kaloyanMilev13/GreenHouse/doc/design/design_presentation.odp

## Greenhouse Management Design

The presentation is separated into 4 parts:

1. Overview
2. Wiring and Schematics
3. Modules
4. Firmware

## Overview

Back to first slide

## Slide 3

1.1. System architecture

1. Overview

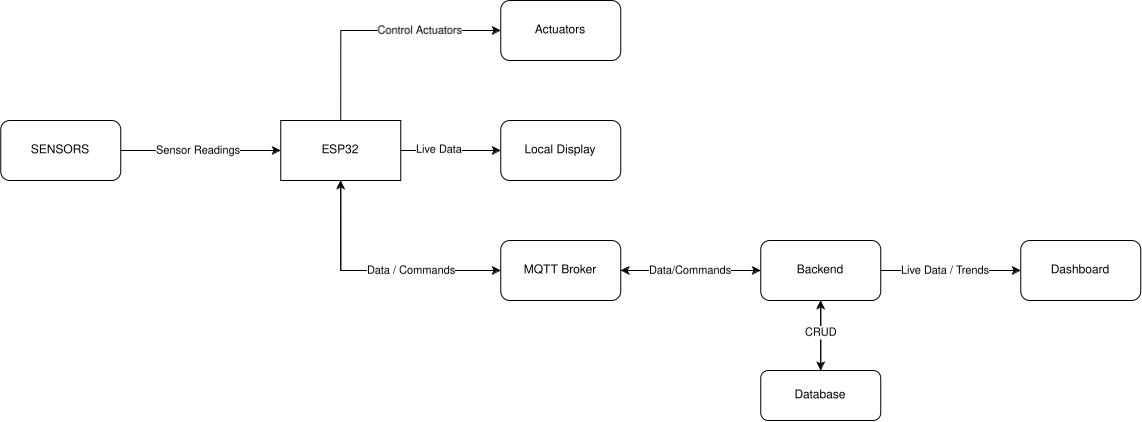
[picture p1: figure]

Back to first slide

## Slide 4

1.1. System architecture - detailed

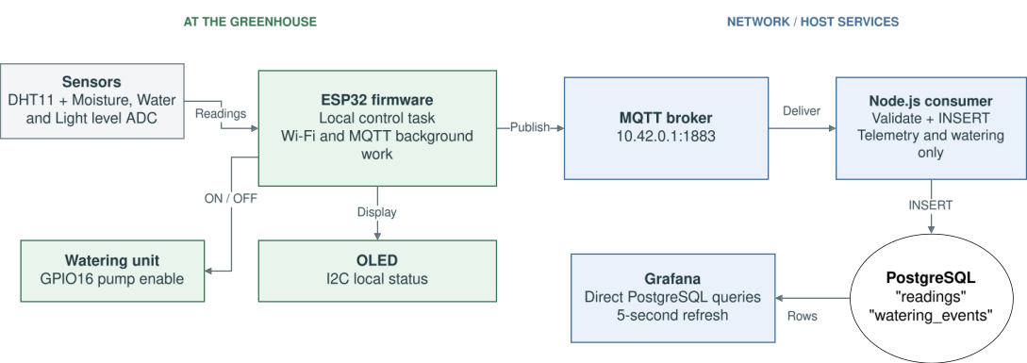
[picture p2: figure]

1. Overview

Back to first slide

## Slide 5

1.2. Firmware responsibilities

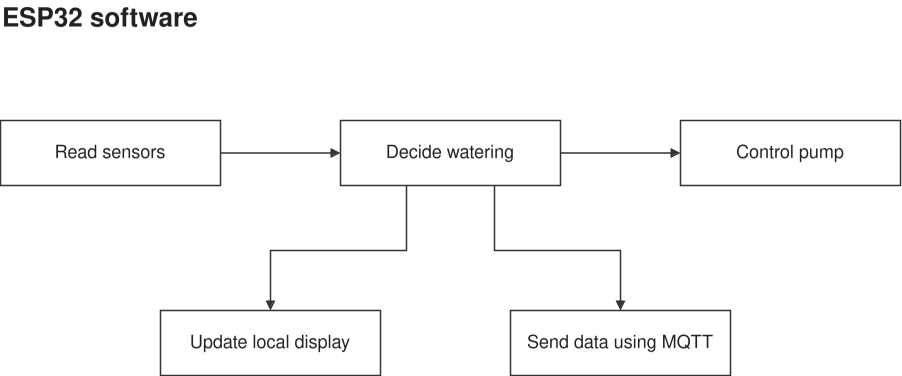
[picture p3: figure]

1. Overview

Back to first slide

## Slide 6

1.3. Whole system – more detailed

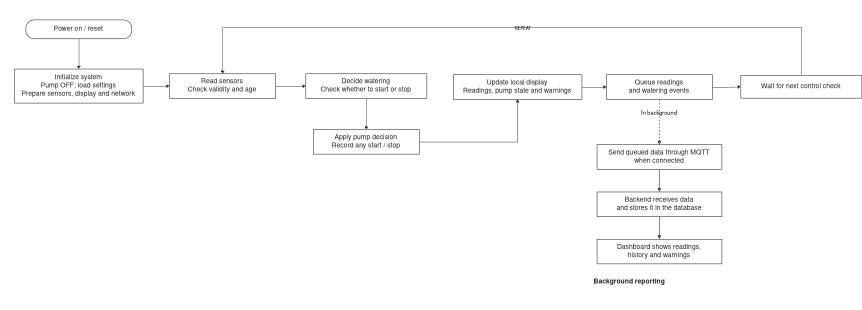
[picture p4: figure]

1. Overview

Back to first slide

## Slide 7

1.4. Initialization / setup part

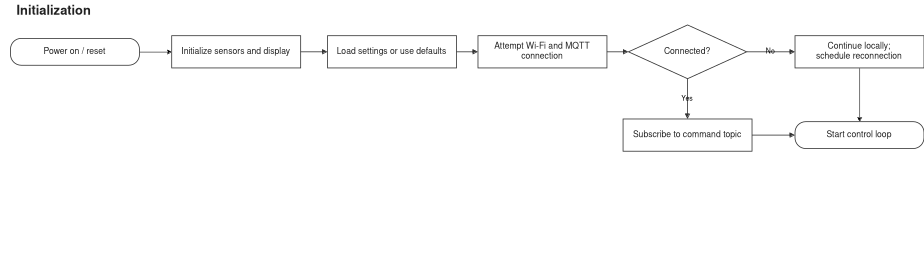
[picture p5: figure]

1. Overview

Back to first slide

## Slide 8

1.5. Control Loop

1. Overview

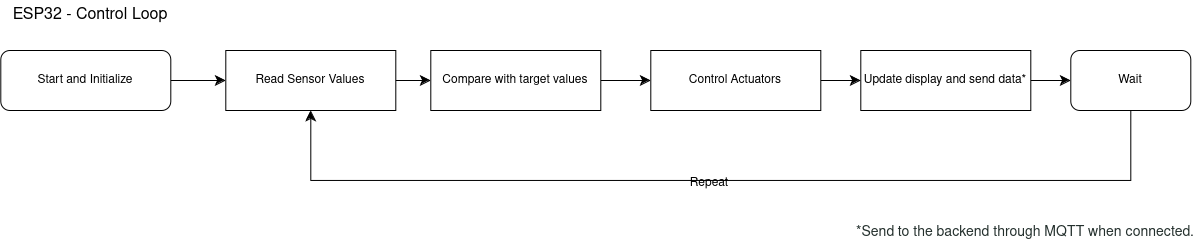
[picture p6: figure]

Back to first slide

## Slide 9

1.6. Communication protocol

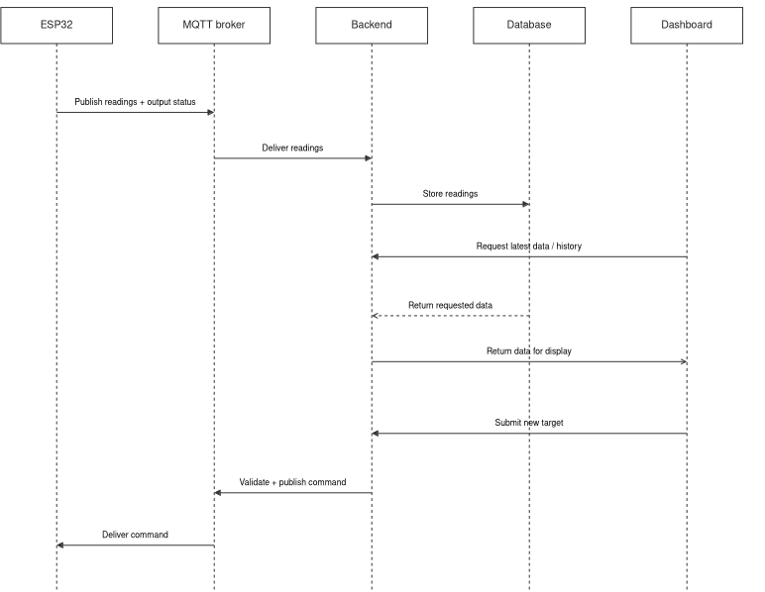
[picture p7: figure]

1. Overview

Back to first slide

## Slide 10

1.7. Sensor Readings

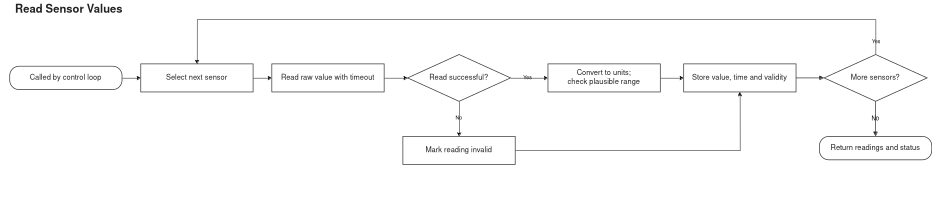
[picture p8: figure]

1. Overview

Back to first slide

## Wiring and Schematics

Back to first slide

## Slide 12

2.1. Wiring table

Component | Component signal | ESP32 GPIO | Interface / behavior
Soil-moisture sensor | Analog output | GPIO33 | ADC1 channel 5
Water-level sensor | Analog output | GPIO35 | ADC1 channel 7
Light sensor | Analog output | GPIO34 | ADC1 channel 6
DHT11 temperature/humidity sensor | DATA | GPIO17 | Digital sensor communication
Pump control | PUMP_EN | GPIO16 | HIGH = ON; LOW = OFF
SSD1306 OLED, 128 × 64 | SDA | GPIO21 | I²C data
SSD1306 OLED, 128 × 64 | SCL | GPIO22 | I²C clock

2. Wiring and Schematics

Back to first slide

## Slide 13

2.2. KiCad Wiring Schematic

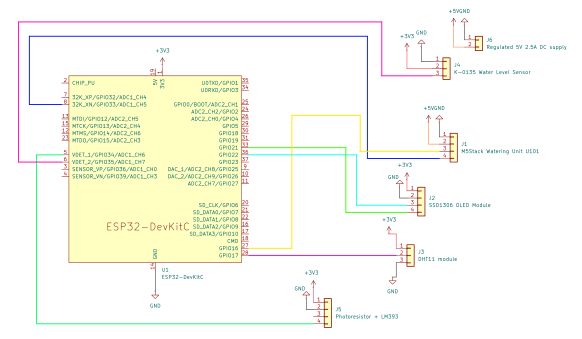
[picture p9: figure]

2. Wiring and Schematics

Back to first slide

## Slide 14

2.2. Power Wiring Table

Component | Power connection | Ground connection
ESP32 DevKitC — U1 | USB through Micro-USB socket | ESP32 GND → common GND
External 5V supply — J6 | J6 pin 2 (+5V) → J1 pin 2 | J6 pin 1 (negative) → common GND
Watering unit: soil sensor + pump — J1 | J1 pin 2 → external +5V | J1 pin 1 → common GND
SSD1306 OLED — J2 | J2 pin 1 → ESP32 3V3 | J2 pin 2 → common GND
DHT11 module — J3 | J3 pin 1 → ESP32 3V3 | J3 pin 3 → common GND
Water-level sensor — J4 | J4 pin 2 → ESP32 3V3 | J4 pin 1 → common GND
Light-sensor module — J5 | J5 pin 1 → ESP32 3V3 | J5 pin 2 → common GND

2. Wiring and Schematics

Back to first slide

## Modules

Back to first slide

## Slide 16

3.1. Source files and responsibilities

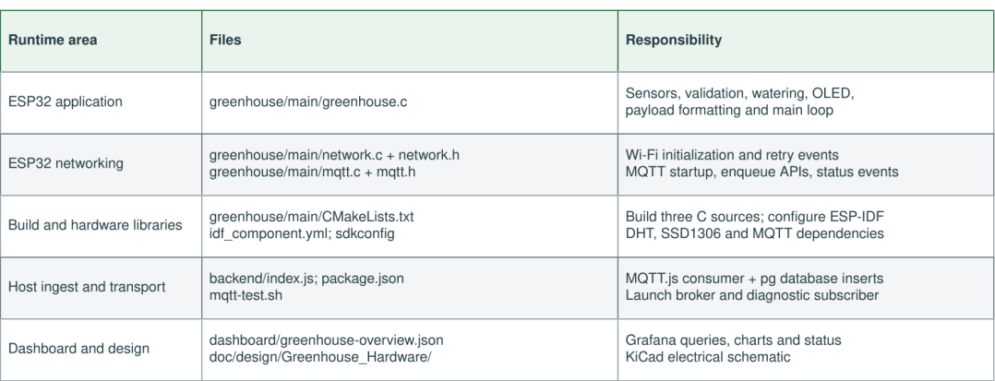
[picture p10: figure]

3. Modules

Back to first slide

## Slide 17

3.2. Connections between modules

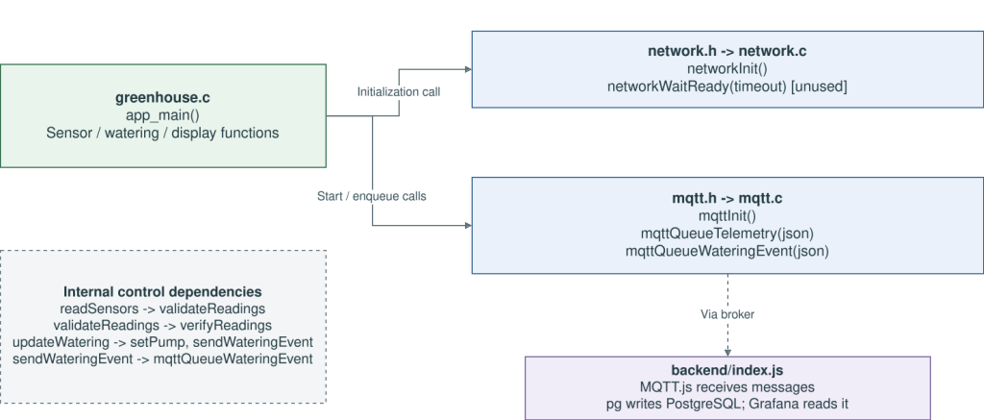
[picture p11: figure]

3. Modules

Back to first slide

## Slide 18

3.3. Data Structures

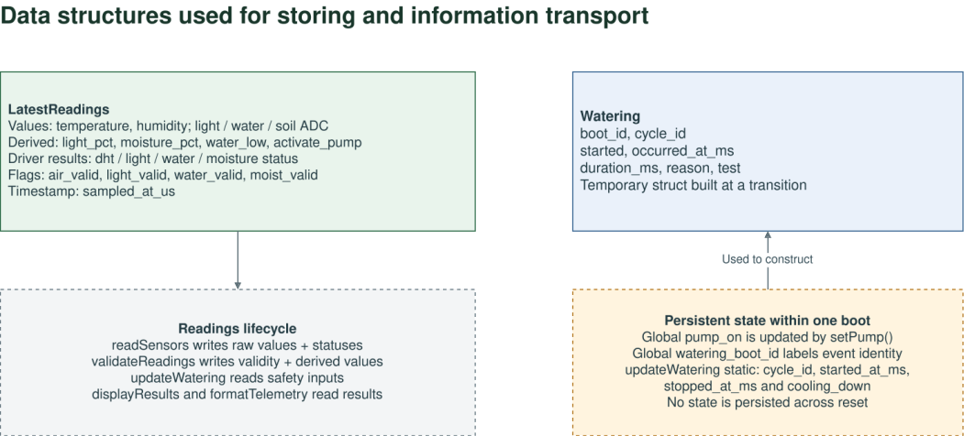
[picture p12: figure]

Back to first slide

3. Modules

## Firmware

Back to first slide

## Slide 20

4.1. Control Loop Logic

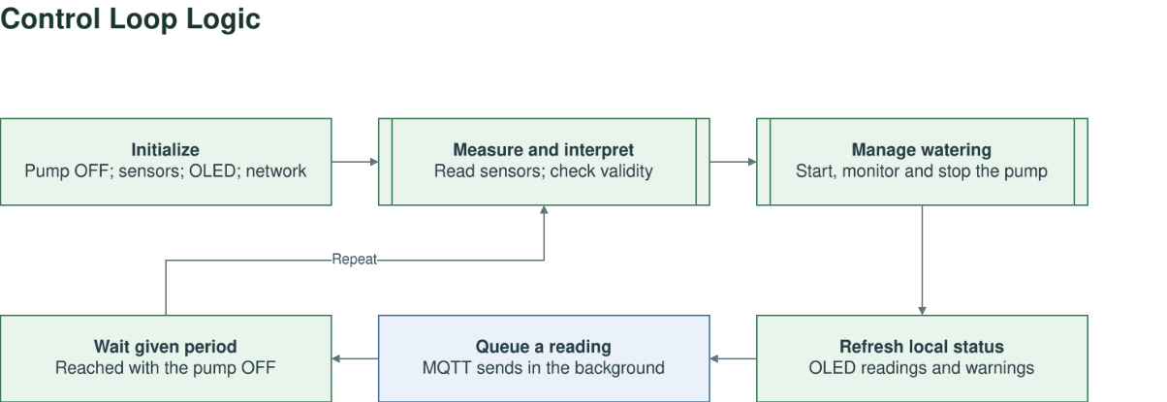
[picture p13: figure]

4. Firmware

Back to first slide

## Slide 21

4.2. Startup Logic

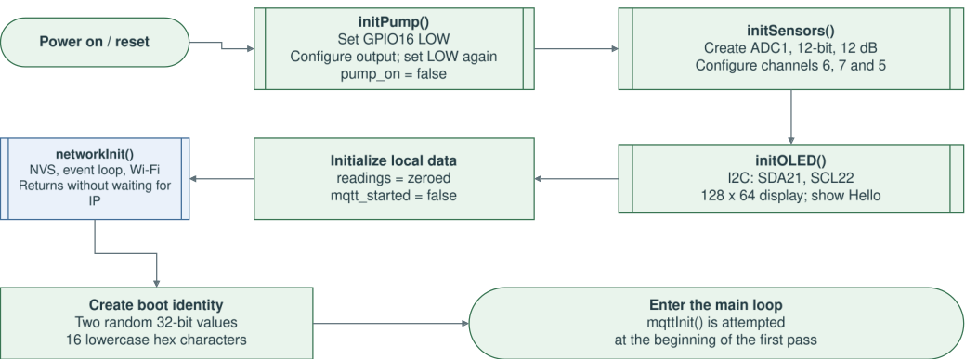
[picture p14: figure]

4. Firmware

Back to first slide

## Slide 22

4.3. Main Loop Logic

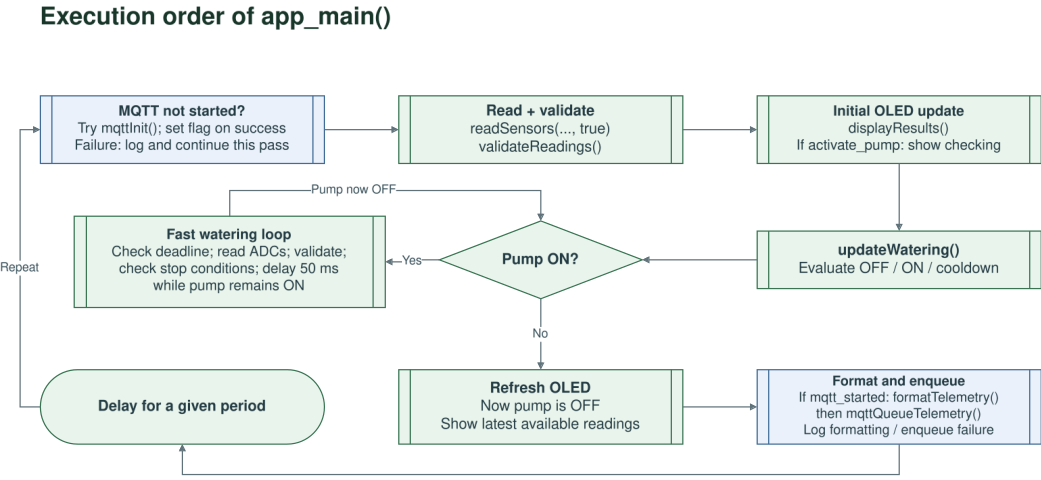
[picture p15: figure]

4. Firmware

Back to first slide

## Slide 23

4.4. Network logic

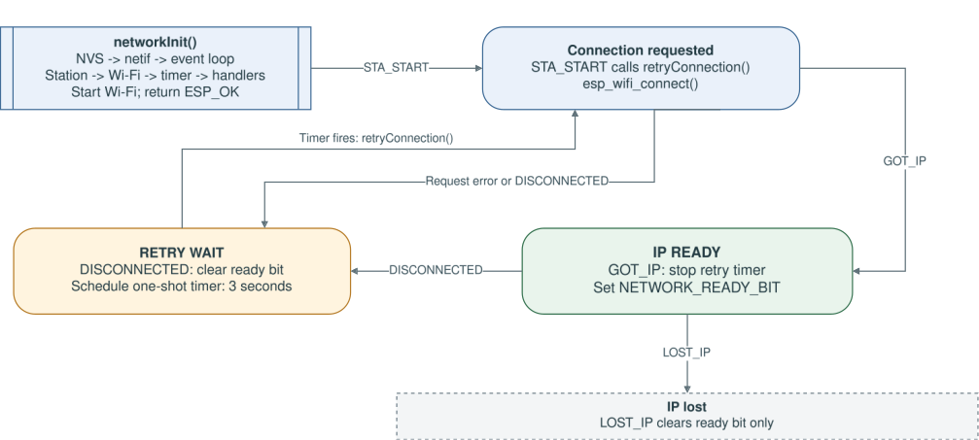
[picture p16: figure]

4. Firmware

Back to first slide

## Slide 24

4.5. MQTT Logic

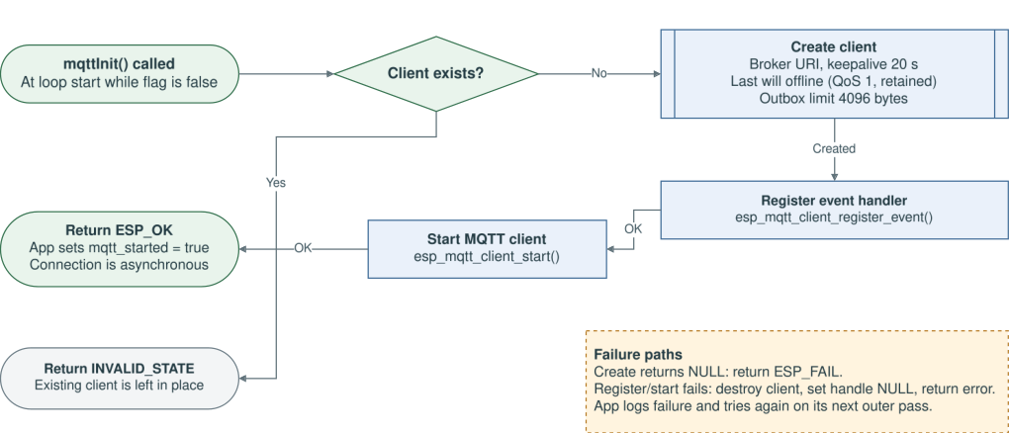
[picture p17: figure]

4. Firmware

Back to first slide

## Slide 25

4.6. Backend Logic

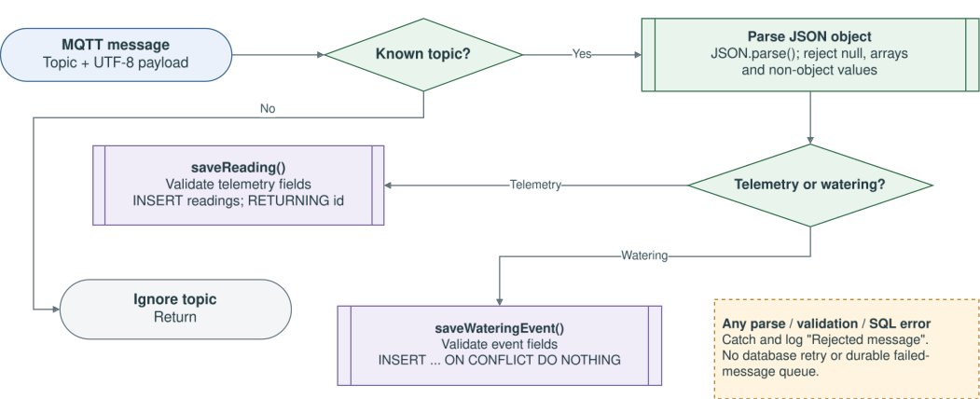
[picture p18: figure]

4. Firmware

Back to first slide

## Slide 26

4.7. Reporting Logic

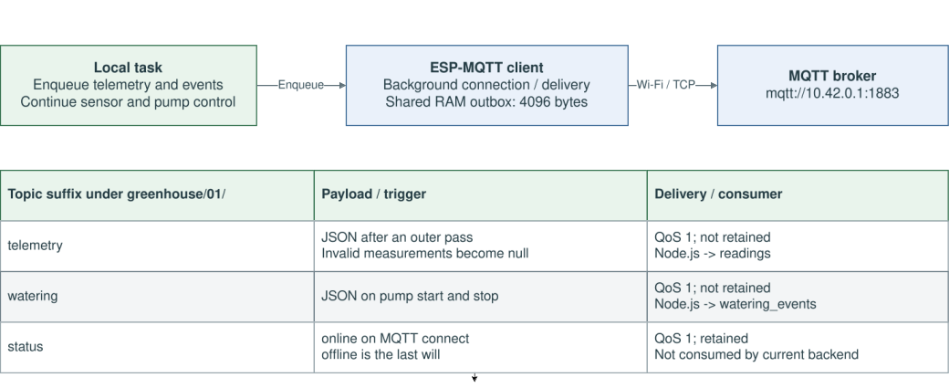
[picture p19: figure]

4. Firmware

Back to first slide
