kaloyanMilev13/GreenHouse/doc/realizaton/realization.pdf

# Demonstration Presentation

1.OLED View
2.Dashboard View
3.Project overview
4.Temperature and Humidity Functionality 5.Light Level Functionality
6.Water Status Functionality 7.Irrigation Example

## 1.1. OLED View

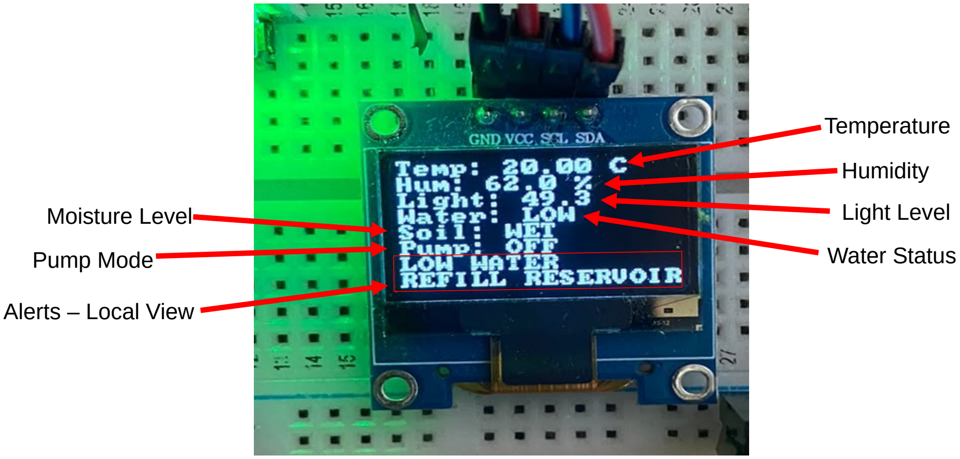
[picture p25: figure]
Temperature; Humidity; Light Level; Water Status; Moisture Level; Pump Mode; Alerts – Local View
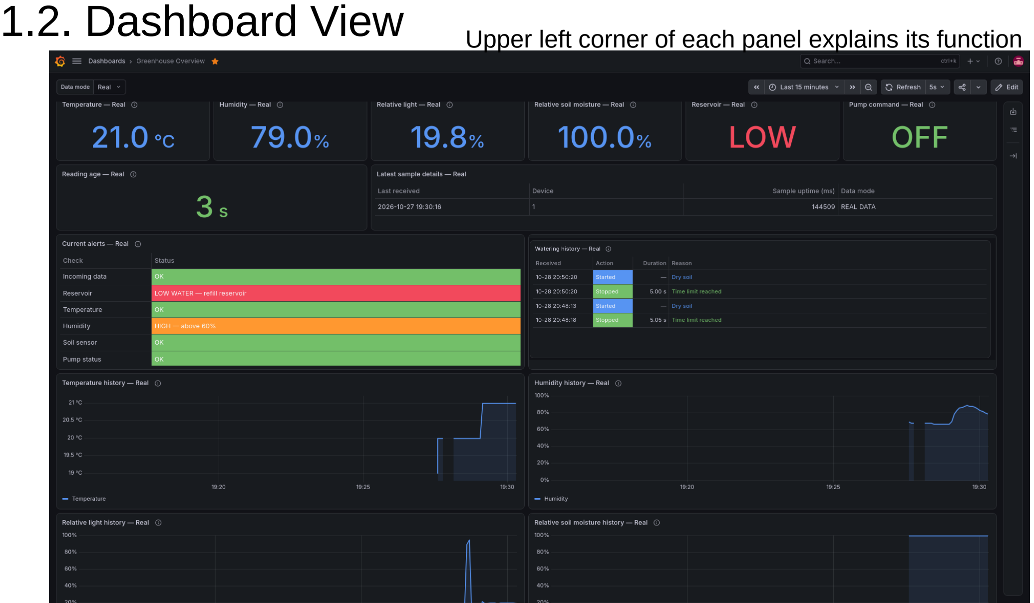
[picture p26: page 3]

1.2. Dashboard View Upper left corner of each panel explains its function

# 2. Overview

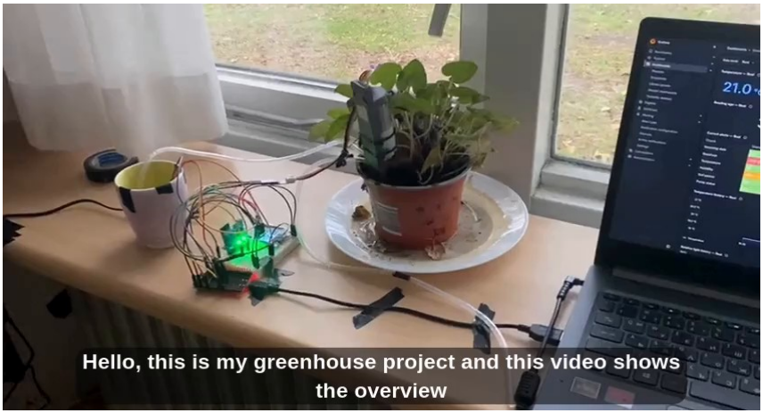
[picture p27: figure]

## 3. Temperature and Humidity functionality

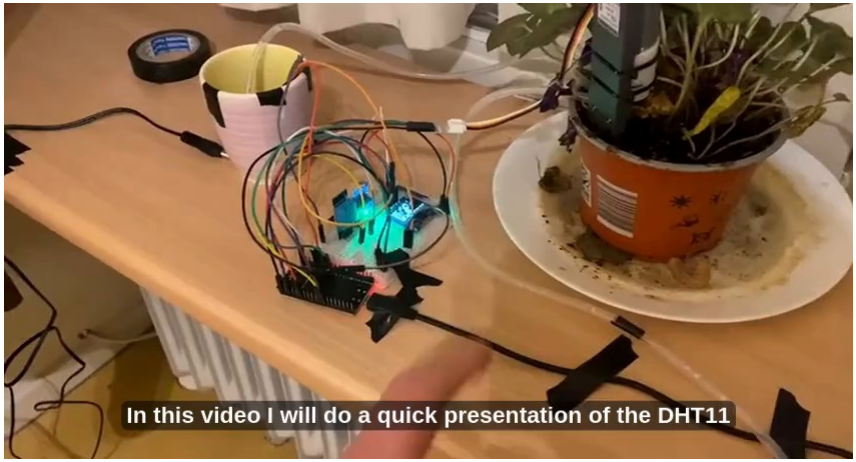
[picture p28: figure]

## 4. Light Level functionality

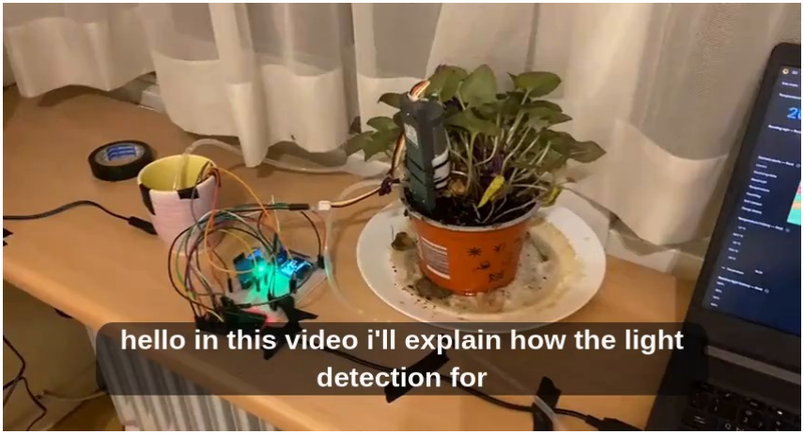
[picture p29: figure]

## 5. Water Status functionality

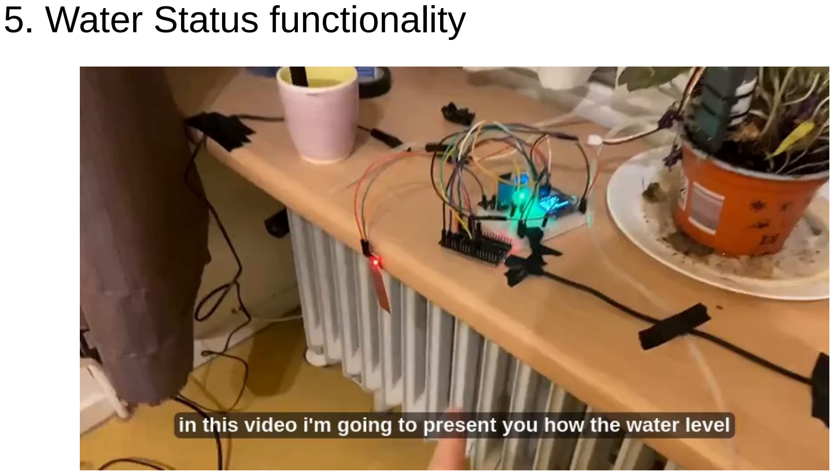
[picture p30: page 7]

## 6. Irrigation Example

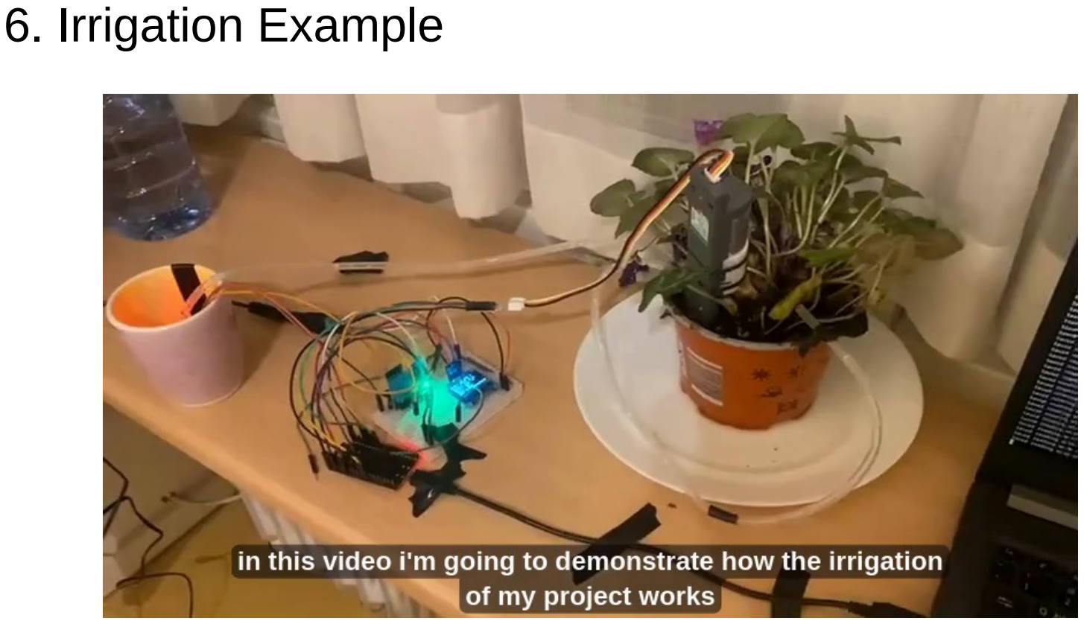
[picture p31: page 8]
