kaloyanMilev13/GreenHouse/doc/planning/Greenhouse_Project_Plan.docx

# Greenhouse Planning and Approach

# 1. Waterfall approach

I will work through five phases, checking components early and updating earlier decisions when a problem requires it.

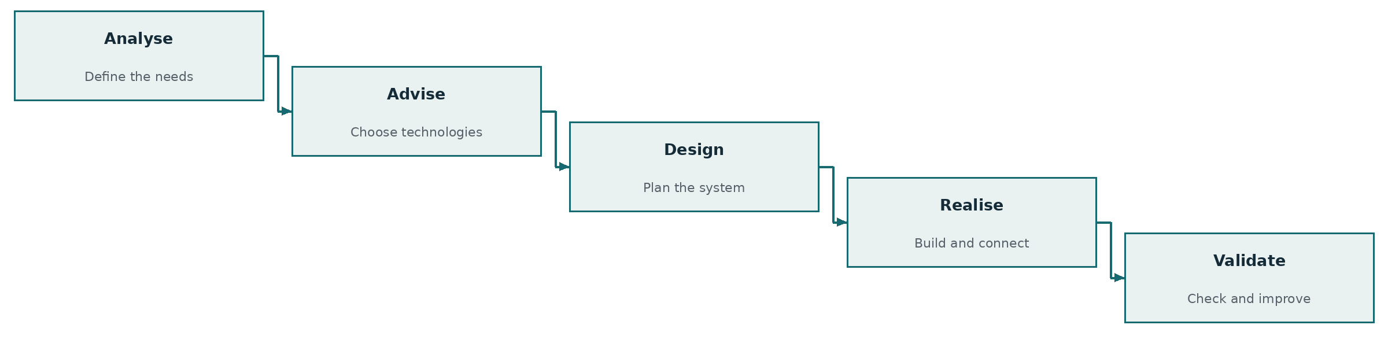
[picture p32: figure]
Five descending phases: Analyse, Advise, Design, Realise, Validate. Each names its main activity.

# 2. Weekly milestones

Week 1 | Week 2 | Week 3 | Week 4
Requirements and technology choices defined. | Design ready and individual components checked. | Local control, storage and dashboard connected. | Final checks complete; fixes retested and work submitted.

# 3. What depends on what

These links show which work must come together before the complete system can be evaluated.

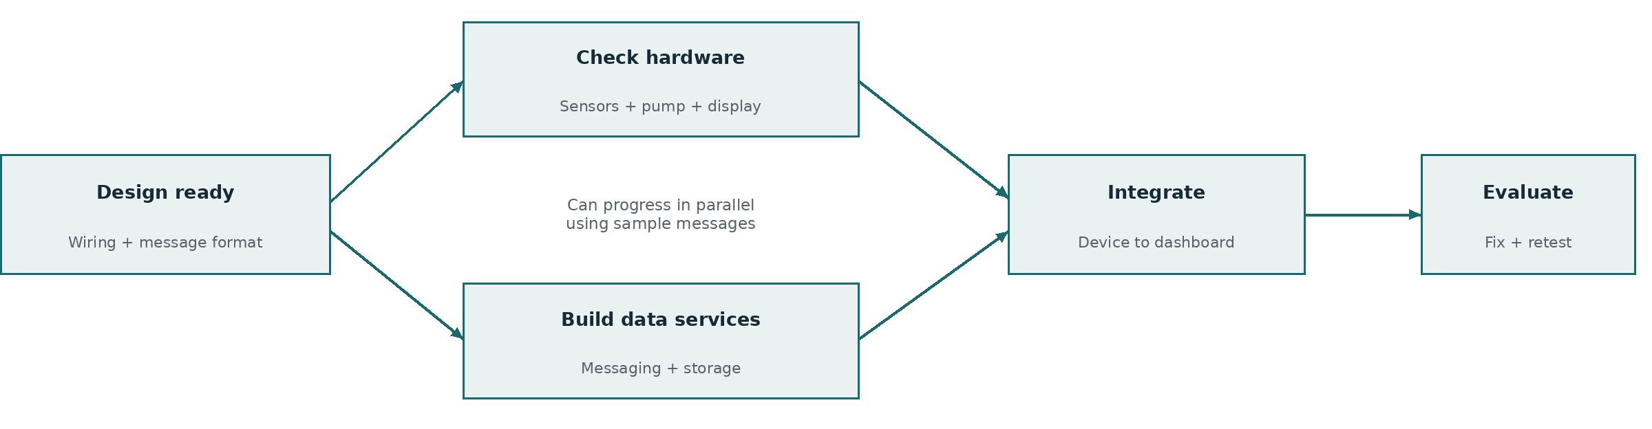
[picture p33: figure]
Design branches into hardware checks and data services, which can progress in parallel using sample messages. Both feed integration, followed by evaluation, fixes and retesting.

If parts are delayed, I can continue the data services with sample readings. Actual hardware integration still needs the real components.

# 4. How I will handle delays

If this happens | My response
A component does not work as expected | Check compatibility early; revise the choice or wiring before integration.
Connecting the software takes longer | Complete one path first: device → stored reading → dashboard. Expand after it works.
There is not enough time for every feature | Postpone “Could Have” requirements first, then “Should Have” if needed.

# 5. Detailed schedule – Gantt Chart

The Gantt chart will show task durations, overlaps, dependencies and milestones across the four weeks.

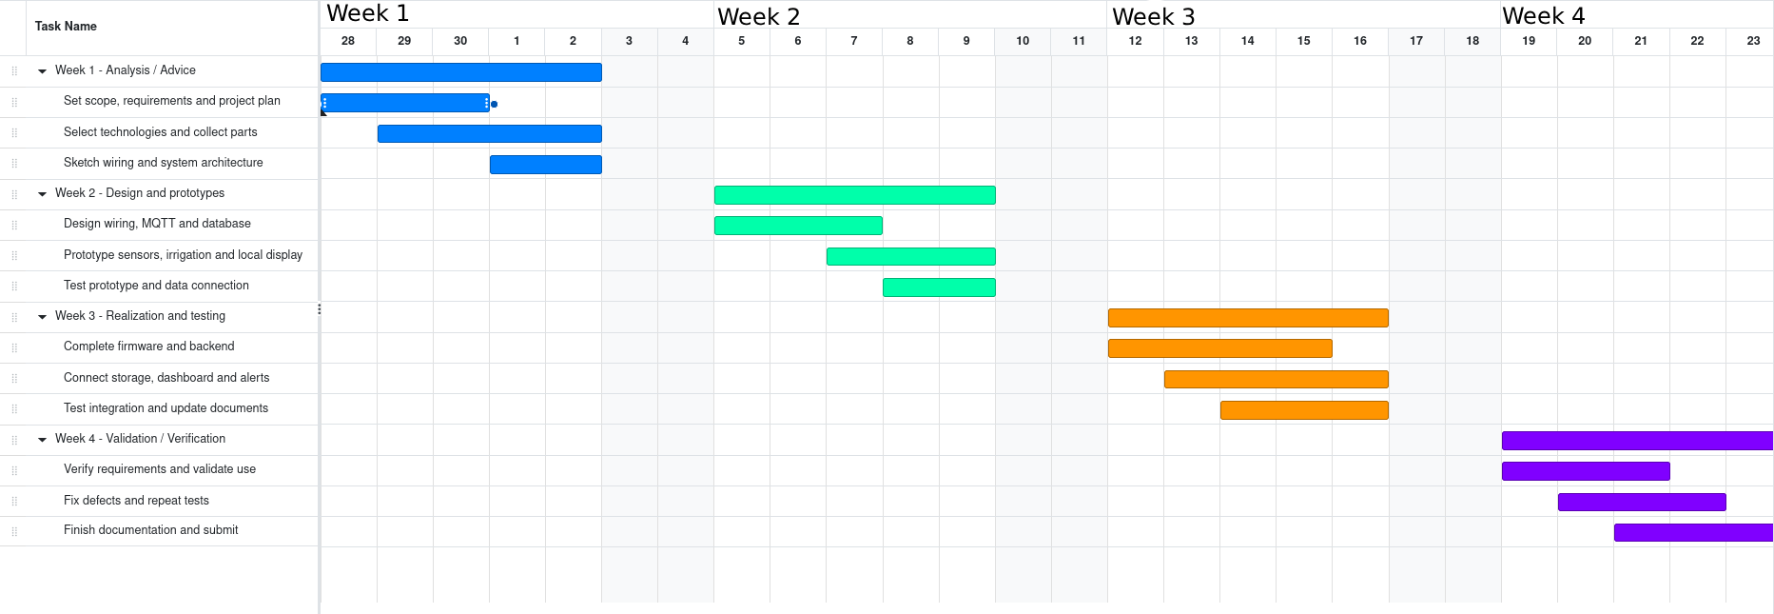
[picture p34: figure]

Kaloyan Milev | 4
