kaloyanMilev13/GreenHouse/doc/planning/Project_Plan_Gantt.pdf

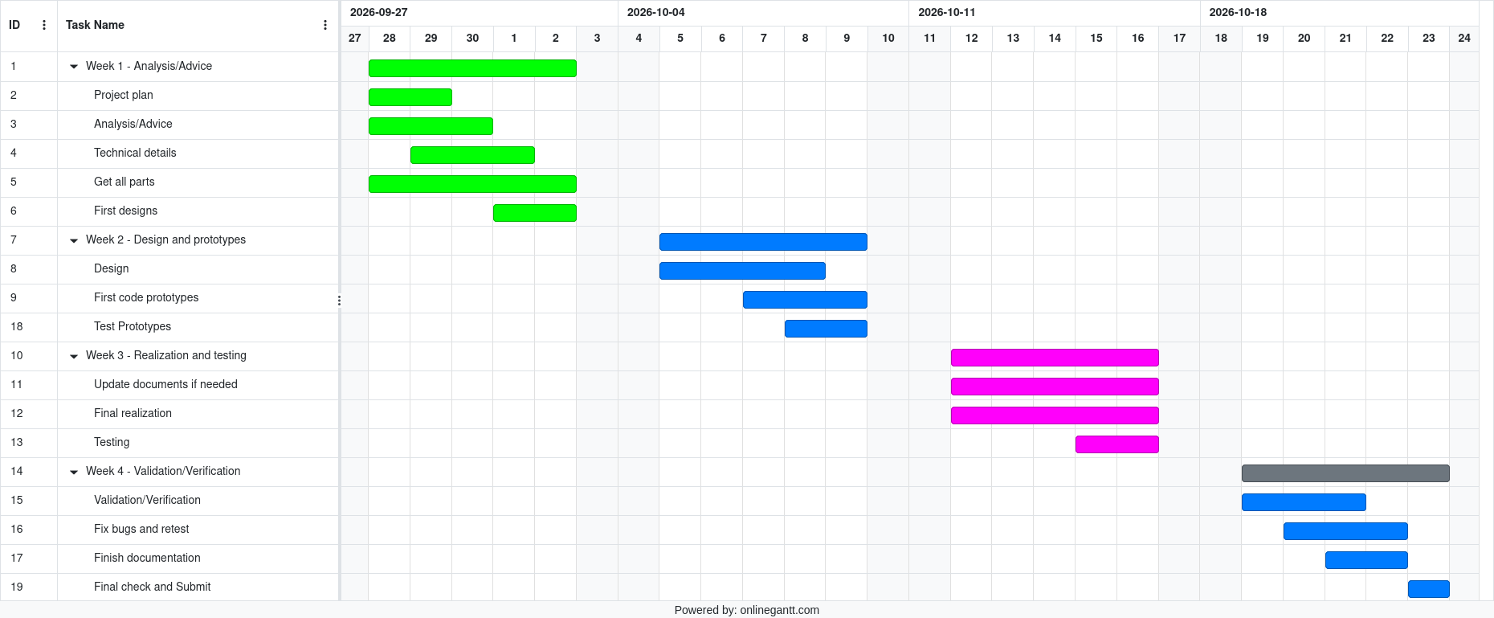
[picture p37: page 1]
