kaloyanMilev13/GreenHouse/doc/design/System_Architecture/previews/00_Design_Map/01-map.png

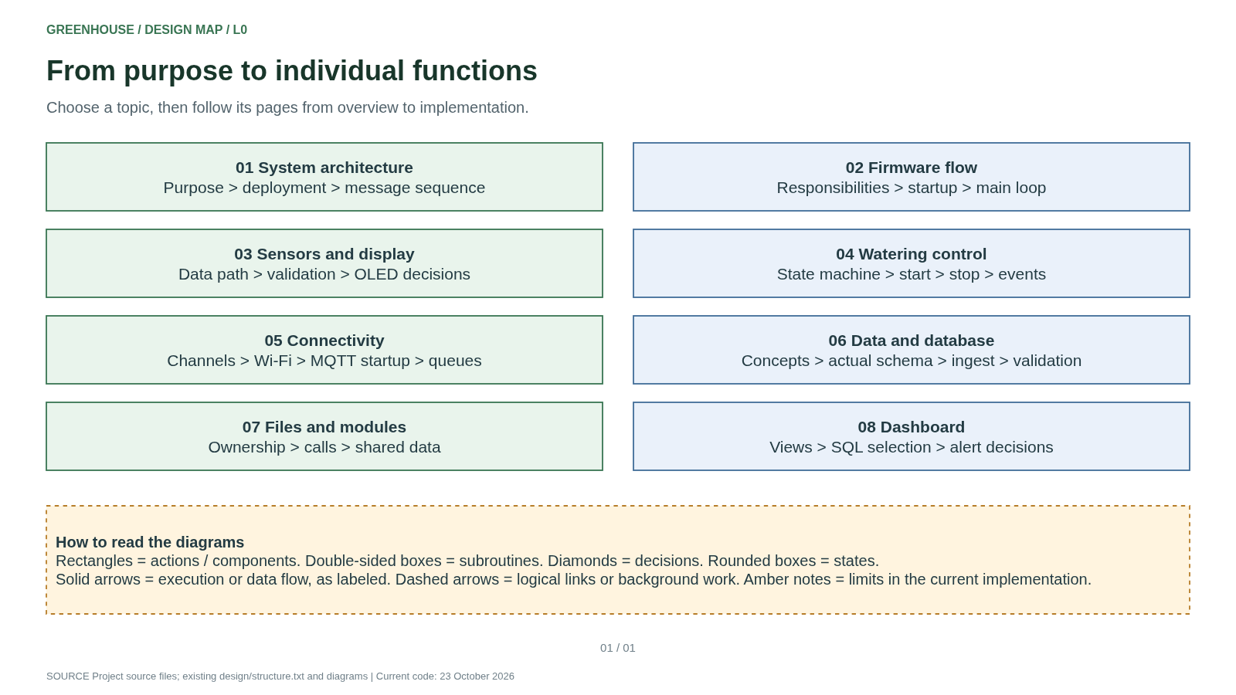
doc/design/System_Architecture/previews/00_Design_Map/01-map.png
