kaloyanMilev13/GreenHouse/doc/design/System_Architecture/previews/01_System_Architecture/01-system-purpose.png

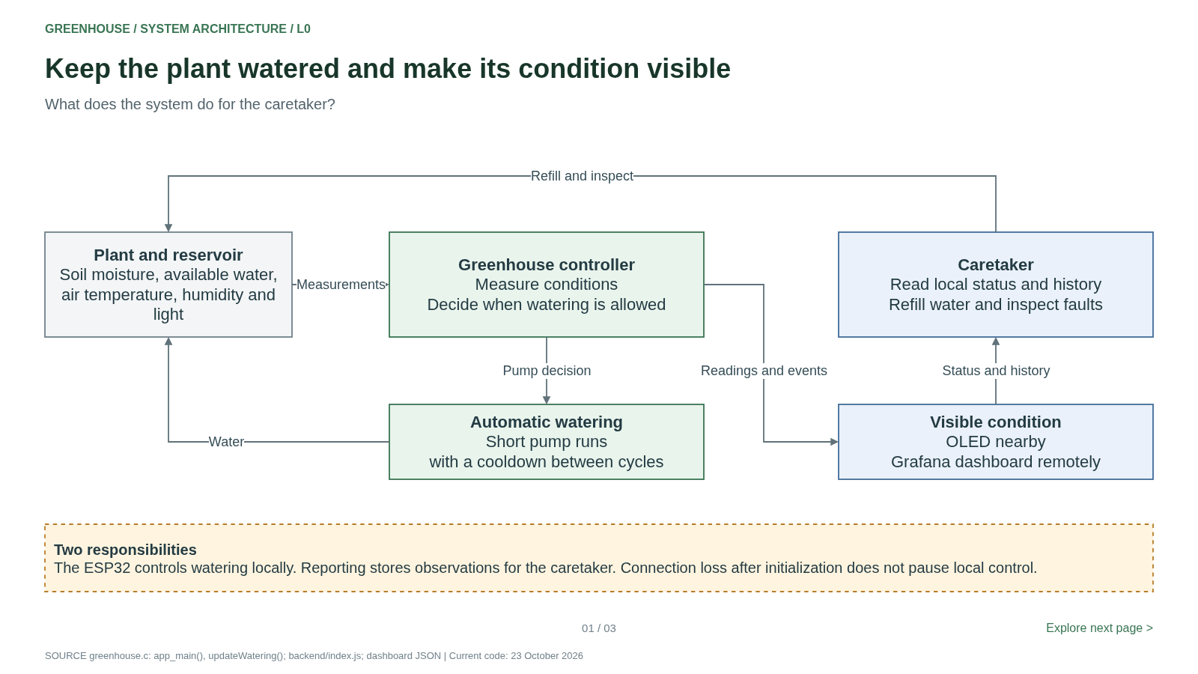
doc/design/System_Architecture/previews/01_System_Architecture/01-system-purpose.png
