kaloyanMilev13/GreenHouse/doc/design/System_Architecture/previews/01_System_Architecture/02-system-containers.png

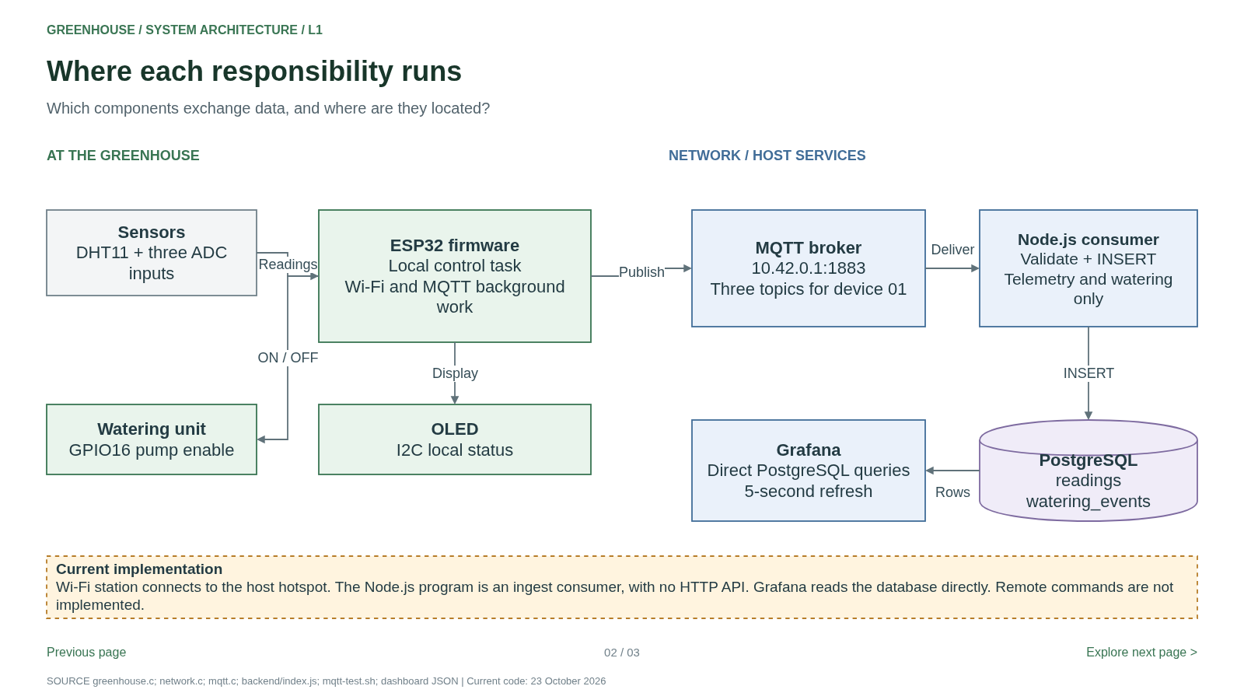
doc/design/System_Architecture/previews/01_System_Architecture/02-system-containers.png
