kaloyanMilev13/GreenHouse/doc/design/System_Architecture/previews/01_System_Architecture/03-system-sequence.png

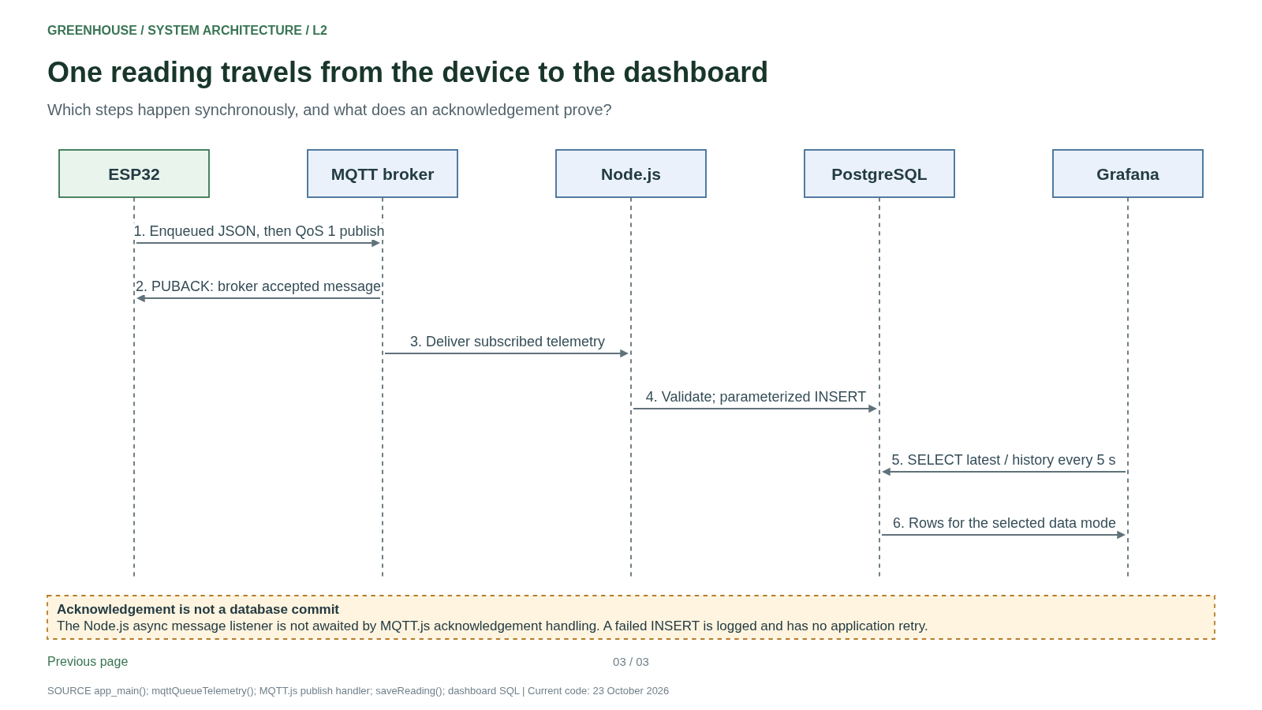
doc/design/System_Architecture/previews/01_System_Architecture/03-system-sequence.png
