kaloyanMilev13/GreenHouse/doc/design/System_Architecture/previews/02_Firmware_Flow/01-firmware-overview.png

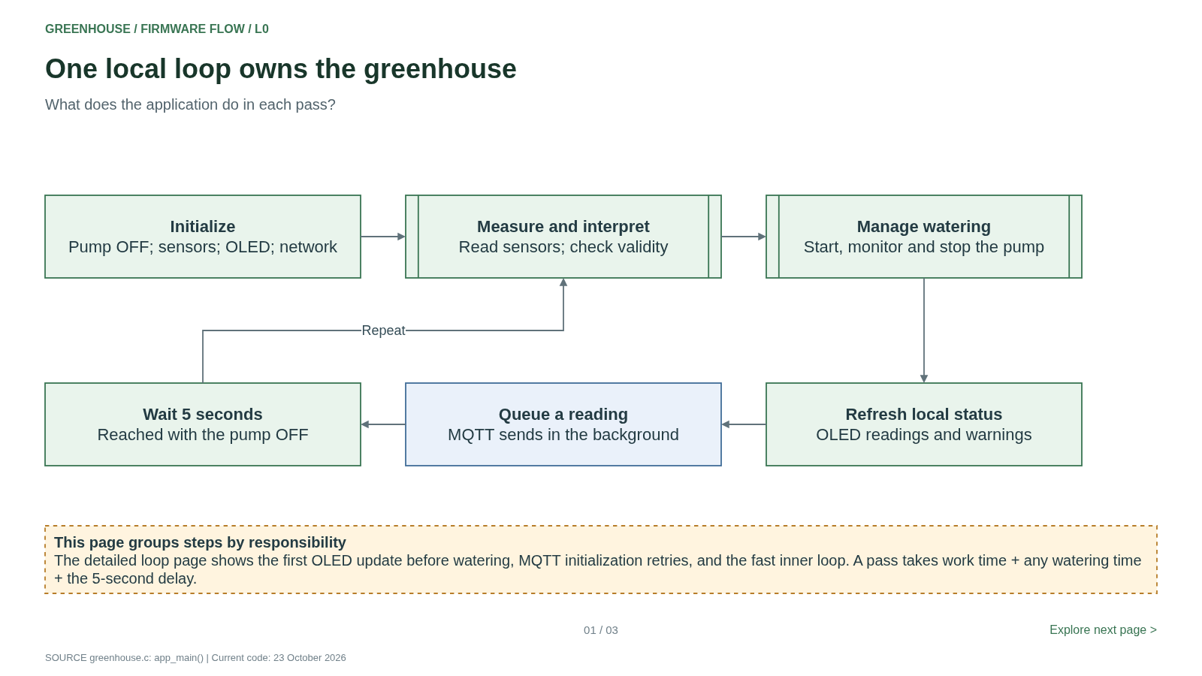
doc/design/System_Architecture/previews/02_Firmware_Flow/01-firmware-overview.png
