kaloyanMilev13/GreenHouse/doc/design/System_Architecture/previews/02_Firmware_Flow/02-firmware-startup.png

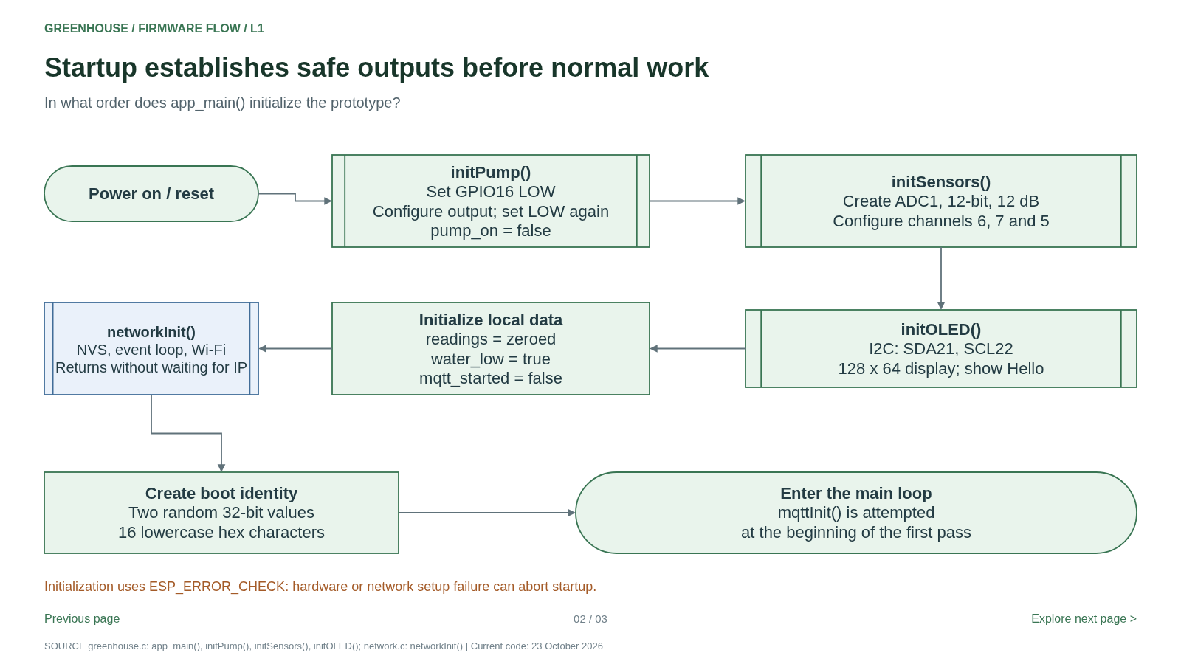
doc/design/System_Architecture/previews/02_Firmware_Flow/02-firmware-startup.png
