kaloyanMilev13/GreenHouse/doc/design/System_Architecture/previews/02_Firmware_Flow/03-firmware-main.png

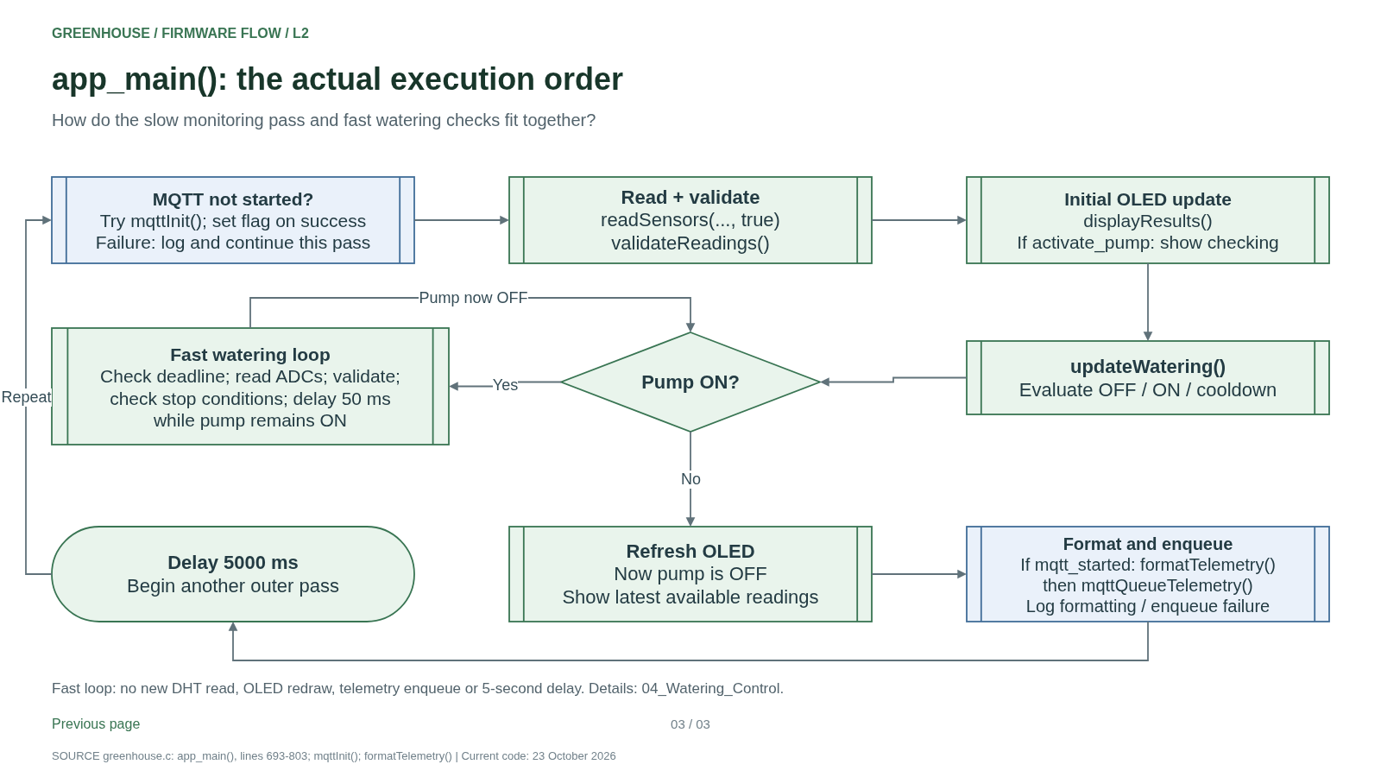
doc/design/System_Architecture/previews/02_Firmware_Flow/03-firmware-main.png
