kaloyanMilev13/GreenHouse/doc/design/System_Architecture/previews/03_Sensors_and_Display/01-sensors-path.png

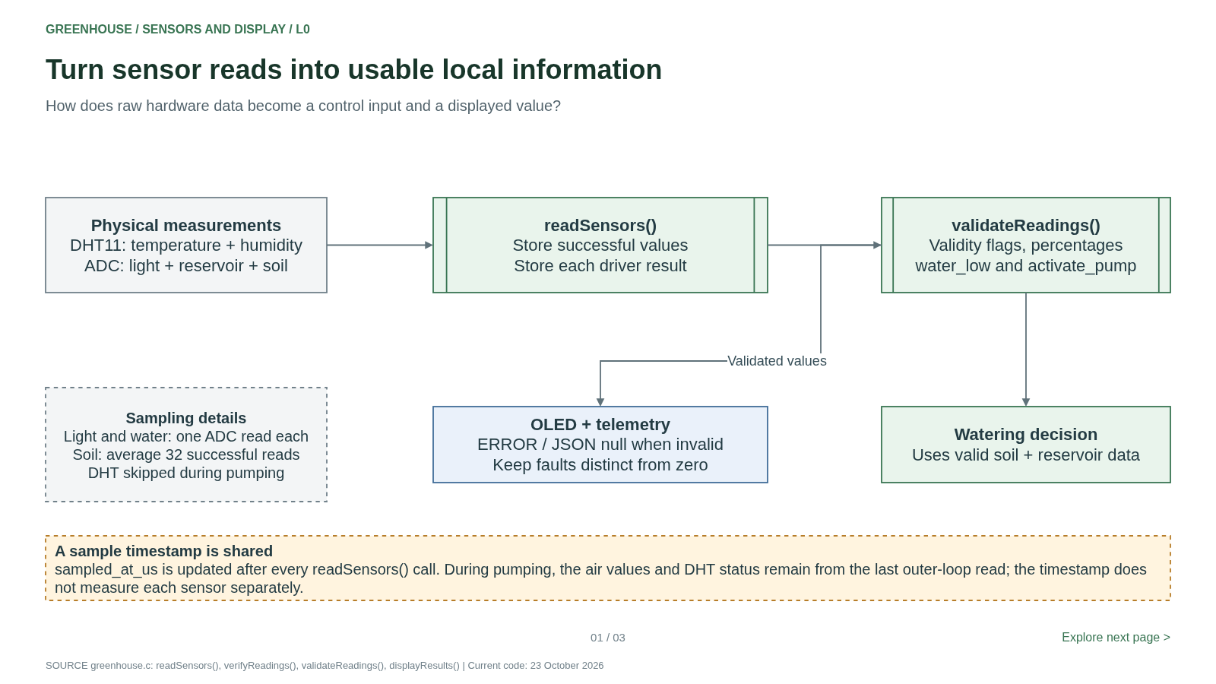
doc/design/System_Architecture/previews/03_Sensors_and_Display/01-sensors-path.png
