kaloyanMilev13/GreenHouse/doc/design/System_Architecture/previews/03_Sensors_and_Display/03-oled-priority.png

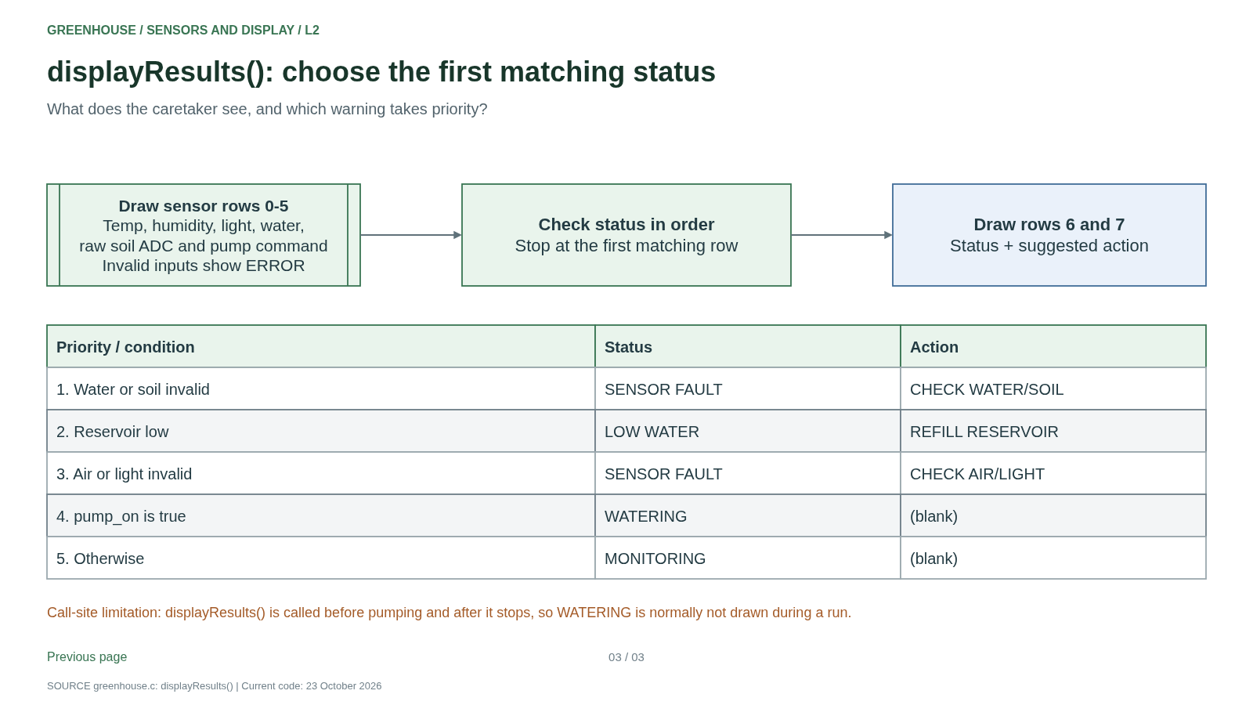
doc/design/System_Architecture/previews/03_Sensors_and_Display/03-oled-priority.png
