kaloyanMilev13/GreenHouse/doc/design/System_Architecture/previews/04_Watering_Control/01-watering-states.png

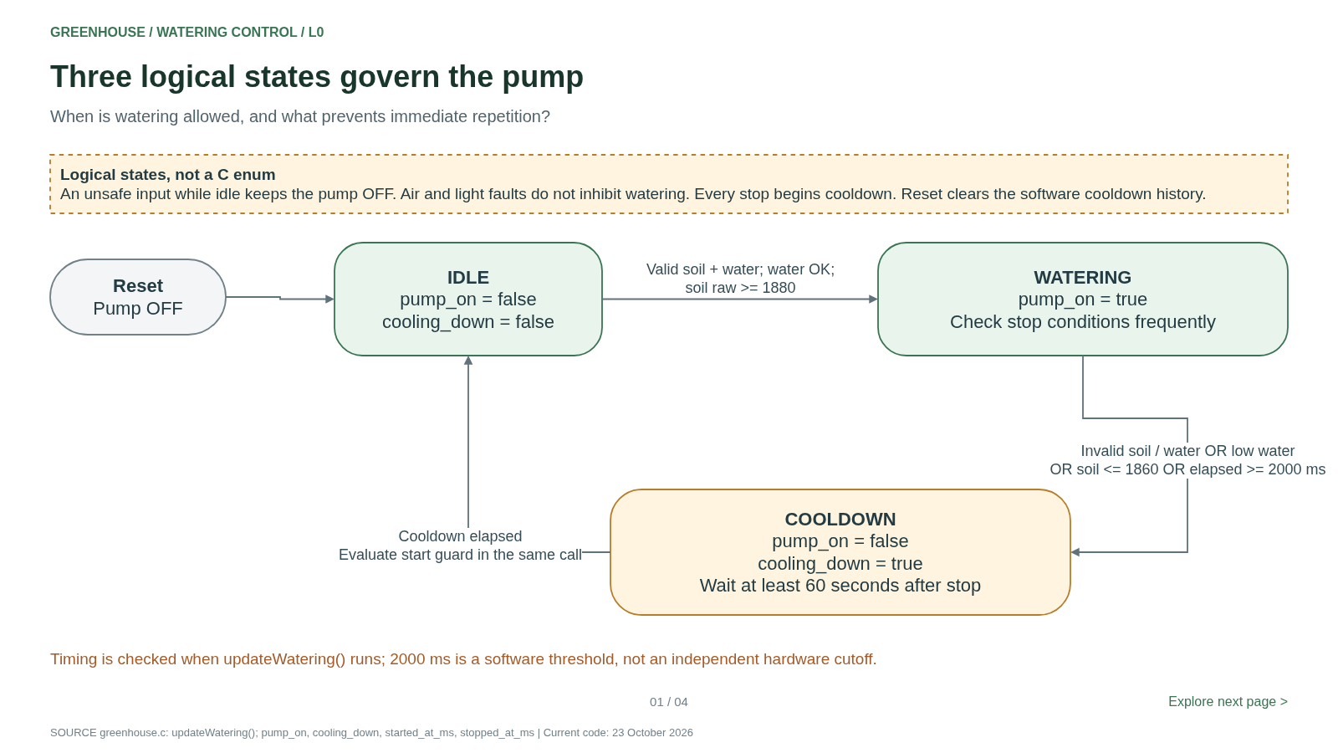
doc/design/System_Architecture/previews/04_Watering_Control/01-watering-states.png
