kaloyanMilev13/GreenHouse/doc/design/System_Architecture/previews/04_Watering_Control/02-watering-start.png

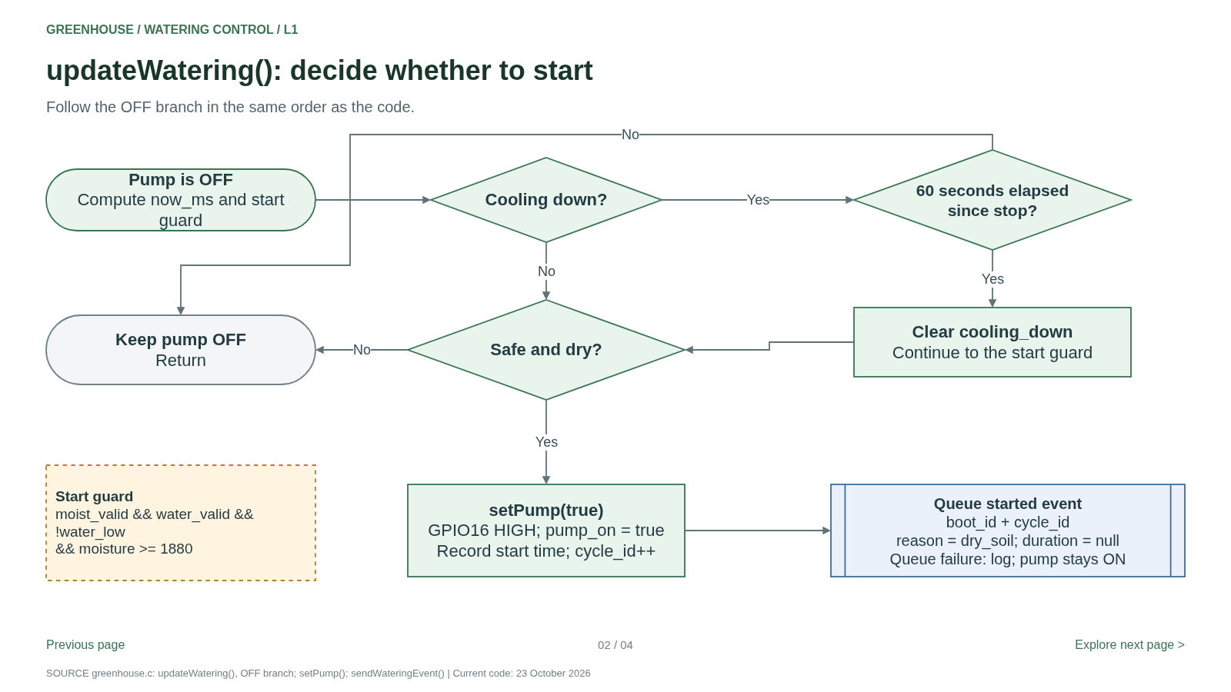
doc/design/System_Architecture/previews/04_Watering_Control/02-watering-start.png
