kaloyanMilev13/GreenHouse/doc/design/System_Architecture/previews/04_Watering_Control/03-watering-stop.png

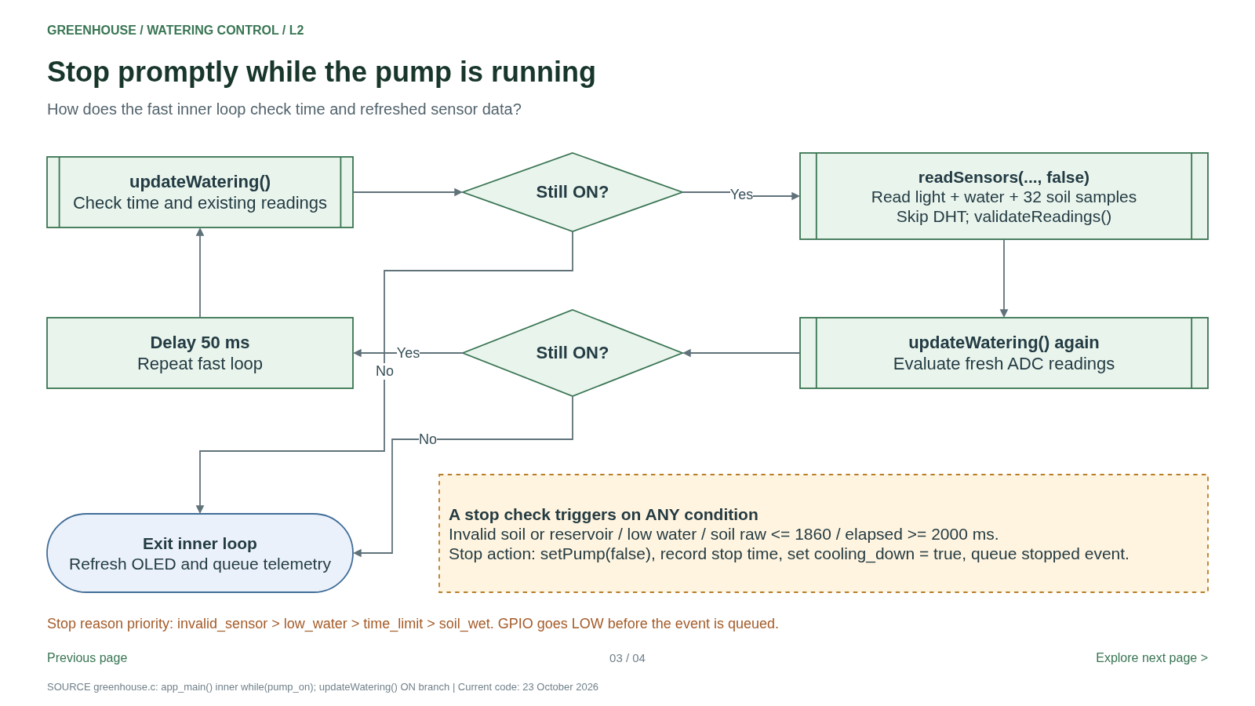
doc/design/System_Architecture/previews/04_Watering_Control/03-watering-stop.png
