kaloyanMilev13/GreenHouse/doc/design/System_Architecture/previews/04_Watering_Control/04-watering-events.png

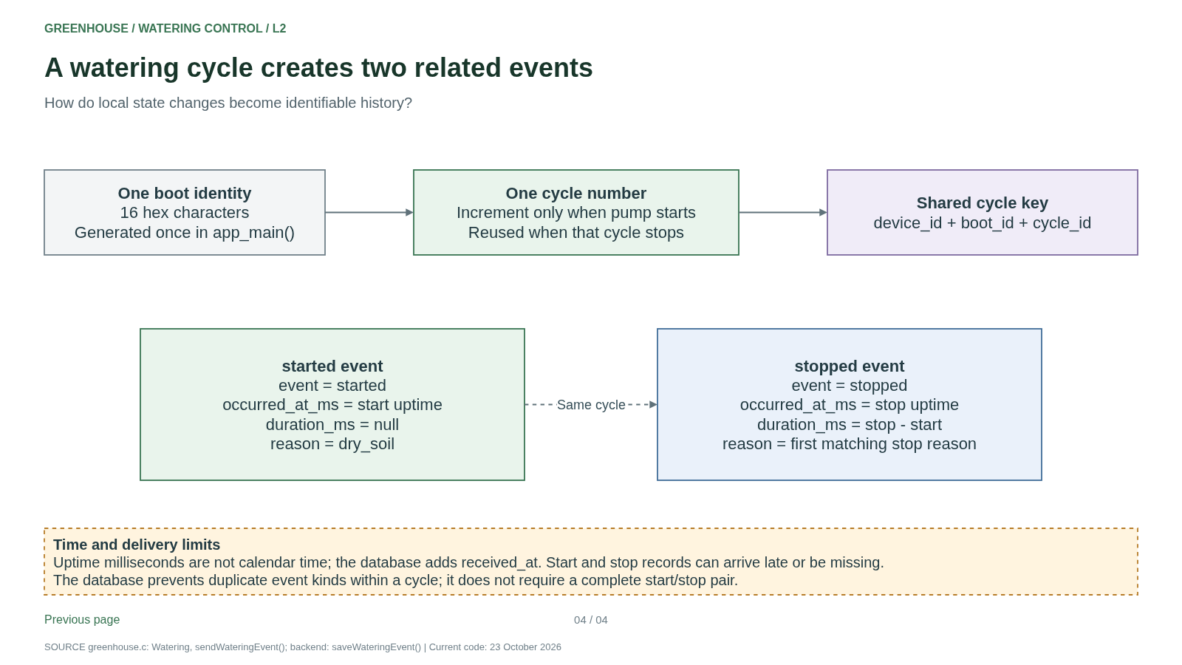
doc/design/System_Architecture/previews/04_Watering_Control/04-watering-events.png
