kaloyanMilev13/GreenHouse/doc/design/System_Architecture/previews/05_Connectivity/01-connectivity-overview.png

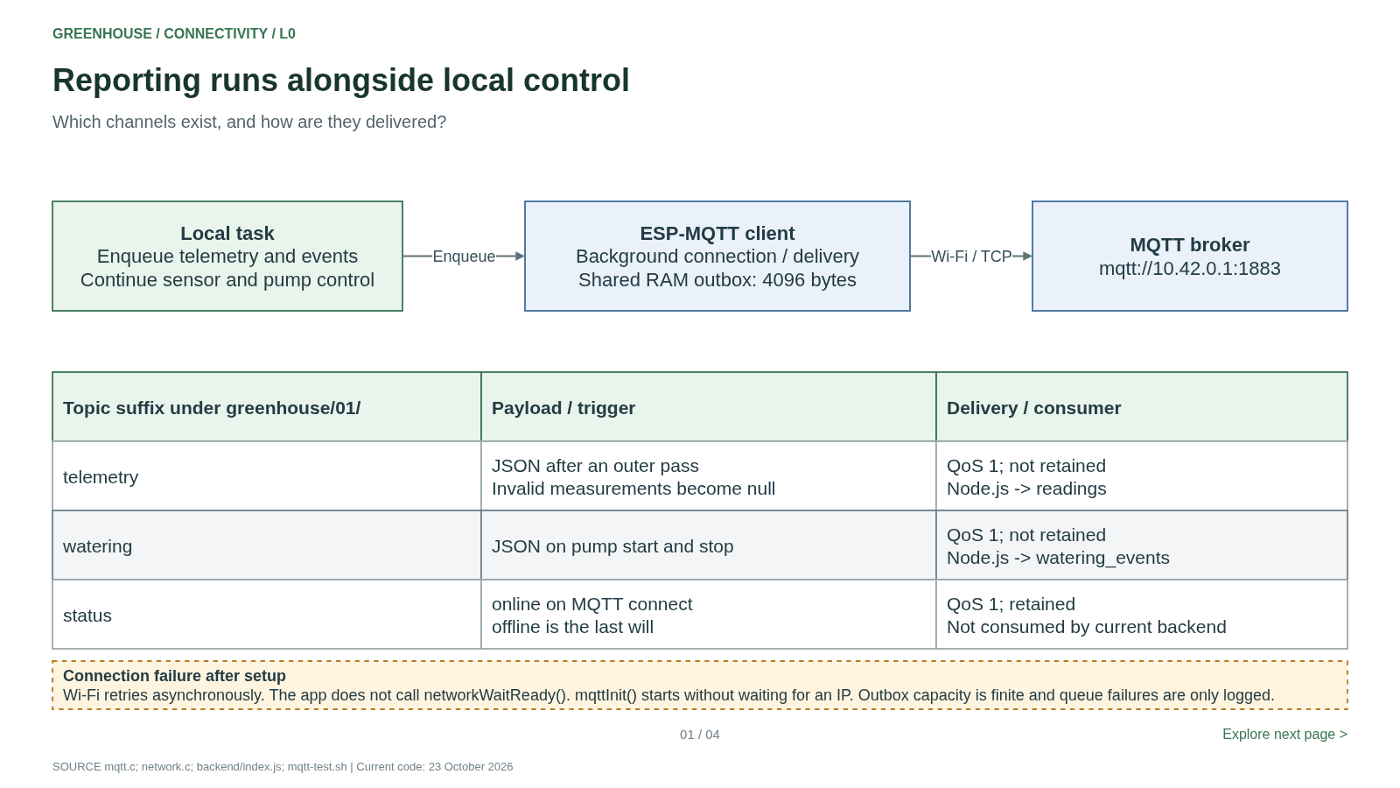
doc/design/System_Architecture/previews/05_Connectivity/01-connectivity-overview.png
