kaloyanMilev13/GreenHouse/doc/design/System_Architecture/previews/05_Connectivity/02-wifi-states.png

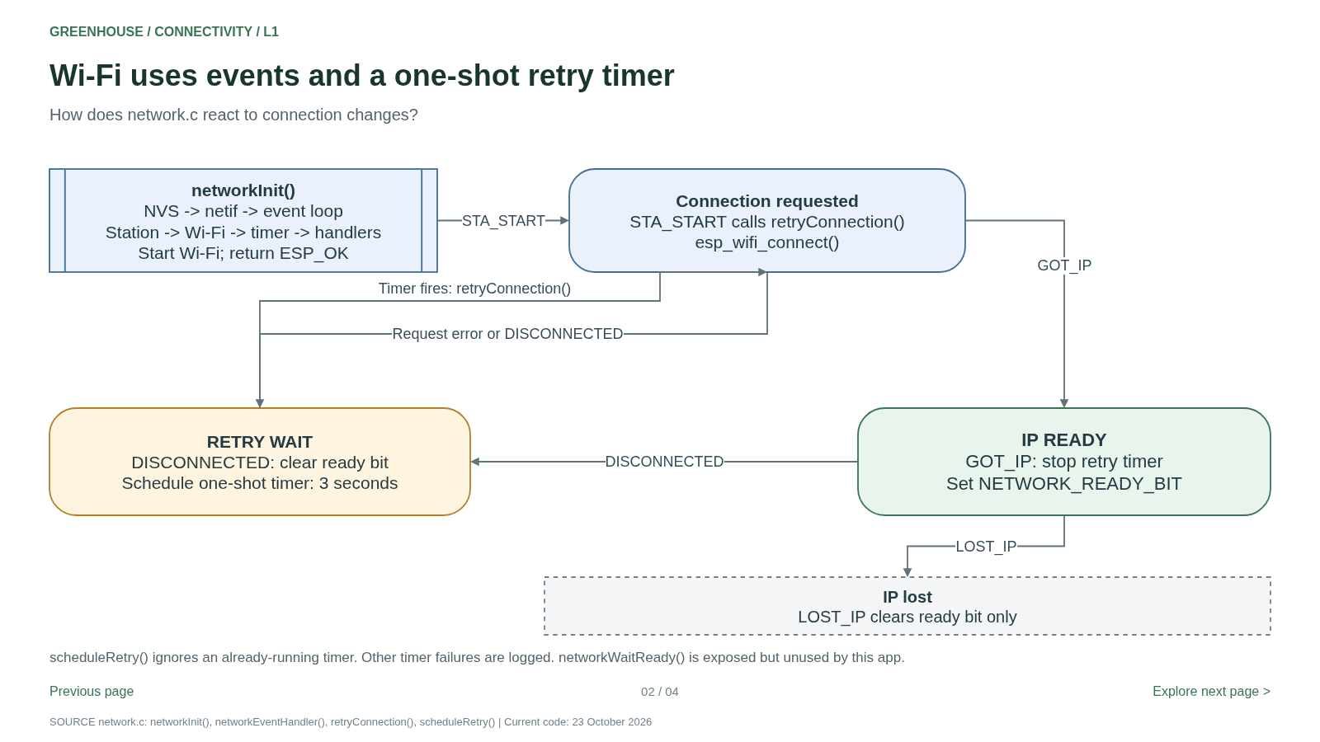
doc/design/System_Architecture/previews/05_Connectivity/02-wifi-states.png
