kaloyanMilev13/GreenHouse/doc/design/System_Architecture/previews/05_Connectivity/03-mqtt-start.png

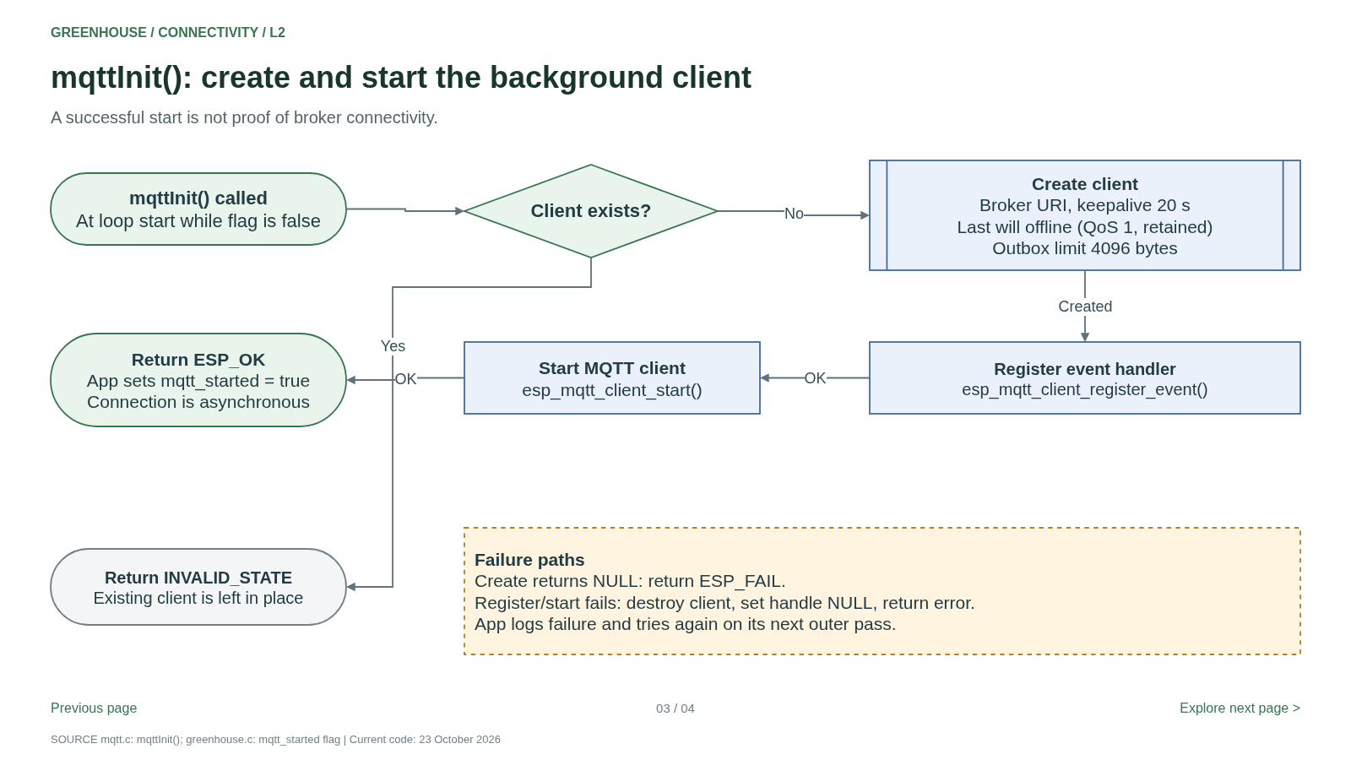
doc/design/System_Architecture/previews/05_Connectivity/03-mqtt-start.png
