kaloyanMilev13/GreenHouse/doc/design/System_Architecture/previews/05_Connectivity/04-mqtt-queue.png

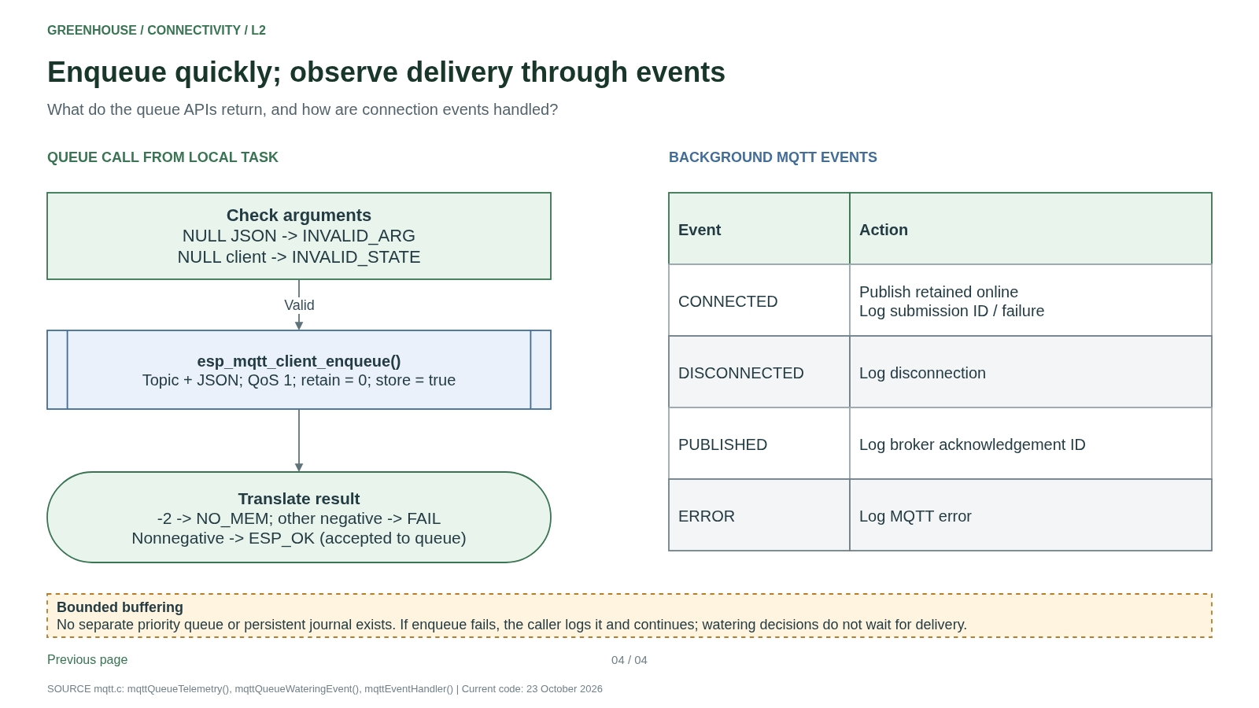
doc/design/System_Architecture/previews/05_Connectivity/04-mqtt-queue.png
