kaloyanMilev13/GreenHouse/doc/design/System_Architecture/previews/06_Data_and_Database/01-data-concepts.png

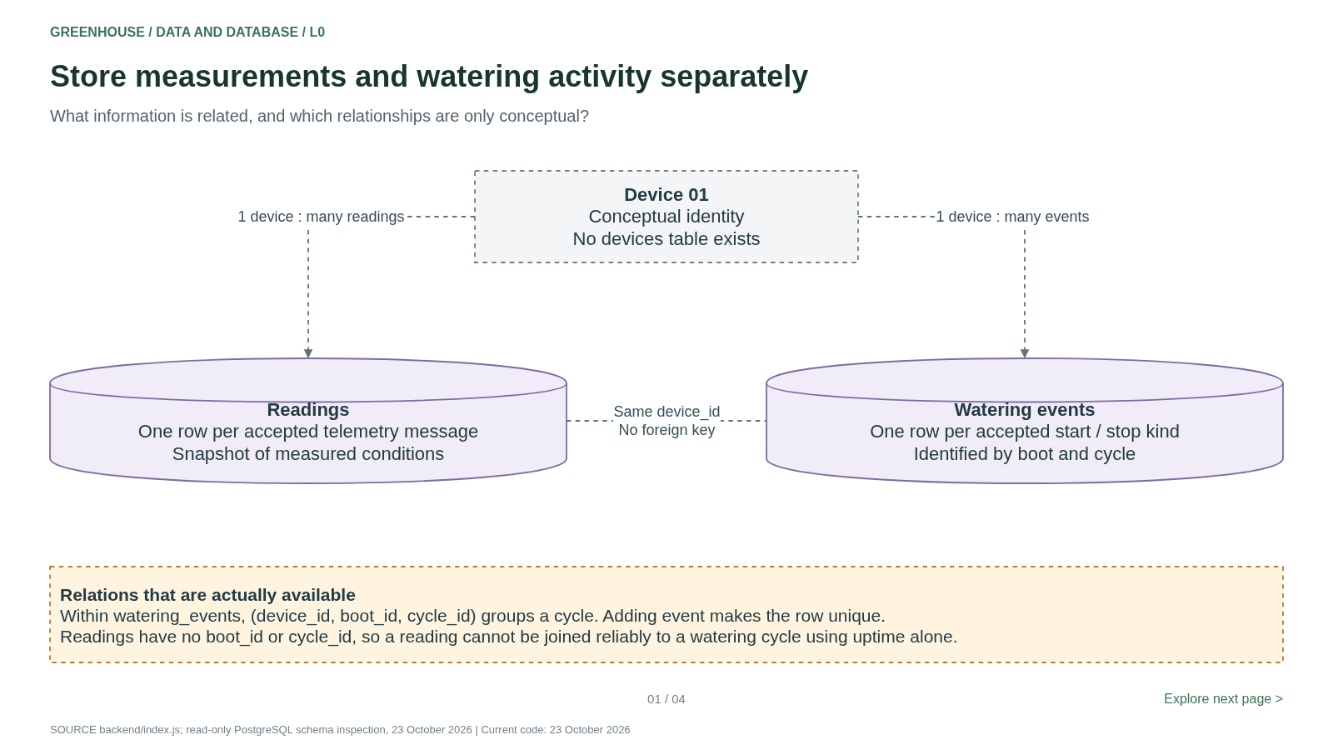
doc/design/System_Architecture/previews/06_Data_and_Database/01-data-concepts.png
