kaloyanMilev13/GreenHouse/doc/design/System_Architecture/previews/06_Data_and_Database/02-database-schema.png

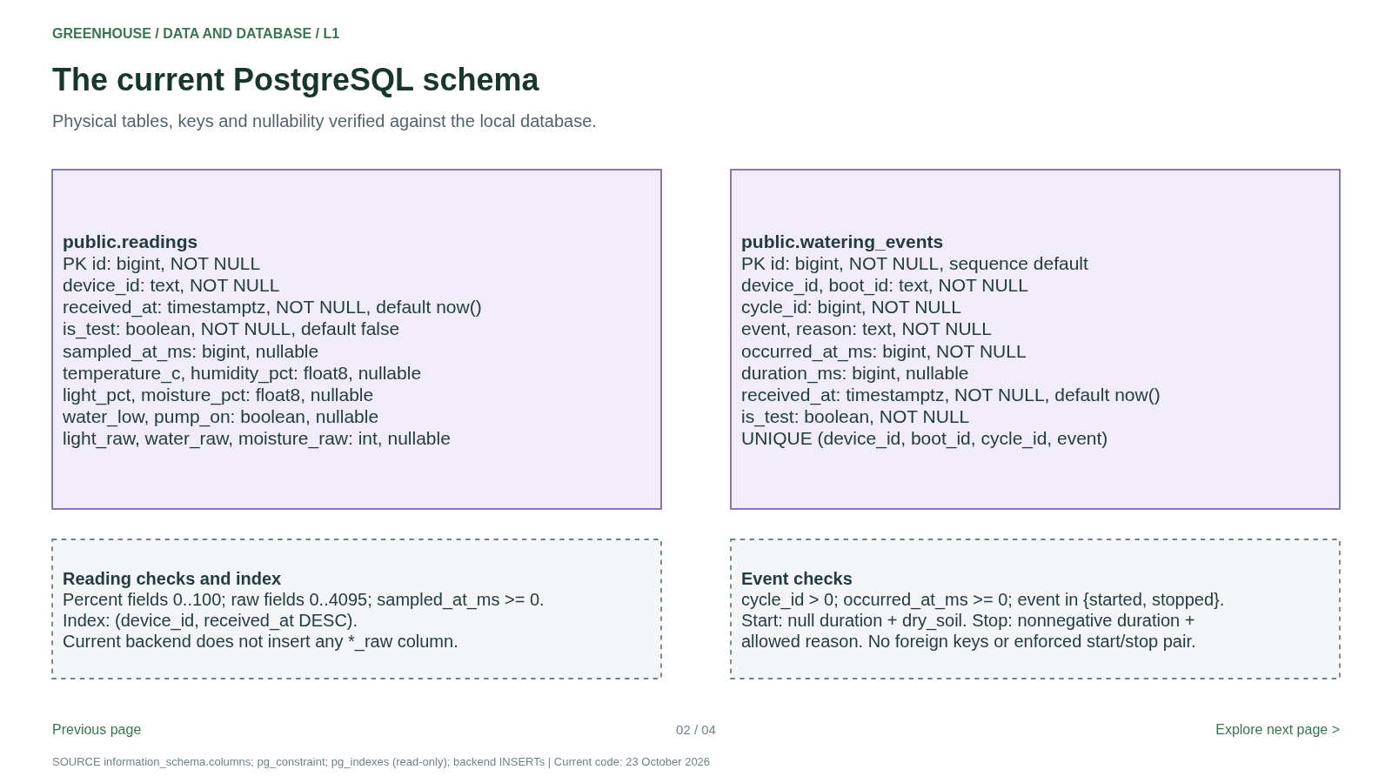
doc/design/System_Architecture/previews/06_Data_and_Database/02-database-schema.png
