kaloyanMilev13/GreenHouse/doc/design/System_Architecture/previews/06_Data_and_Database/03-backend-ingest.png

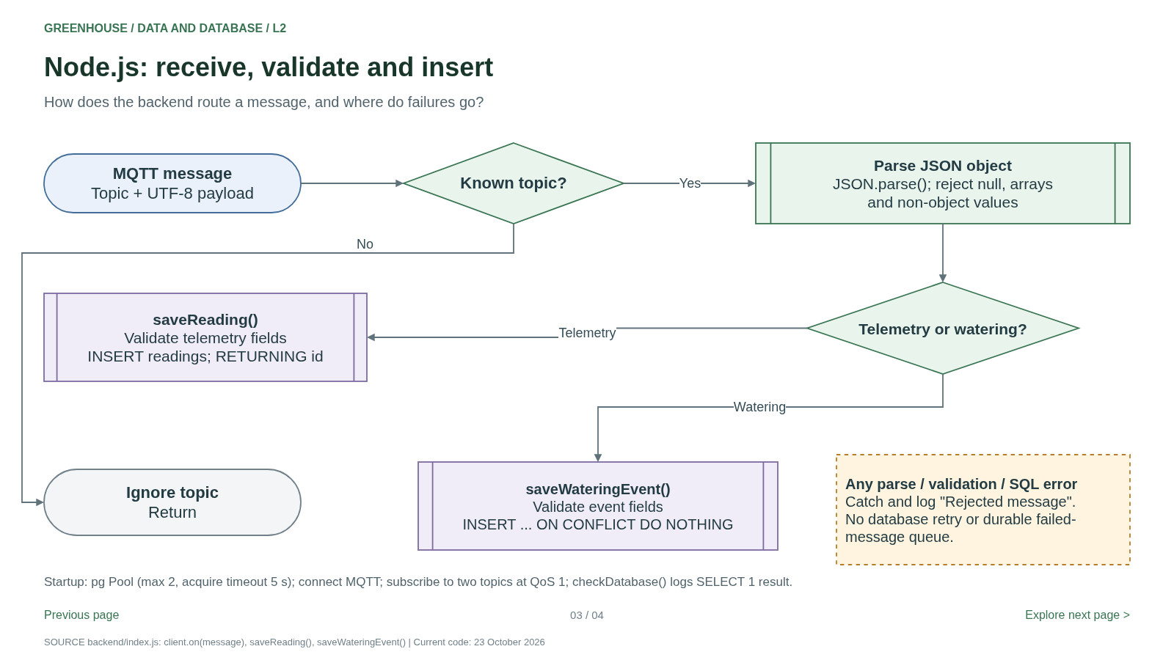
doc/design/System_Architecture/previews/06_Data_and_Database/03-backend-ingest.png
