kaloyanMilev13/GreenHouse/doc/design/System_Architecture/previews/07_Files_and_Modules/01-files-ownership.png

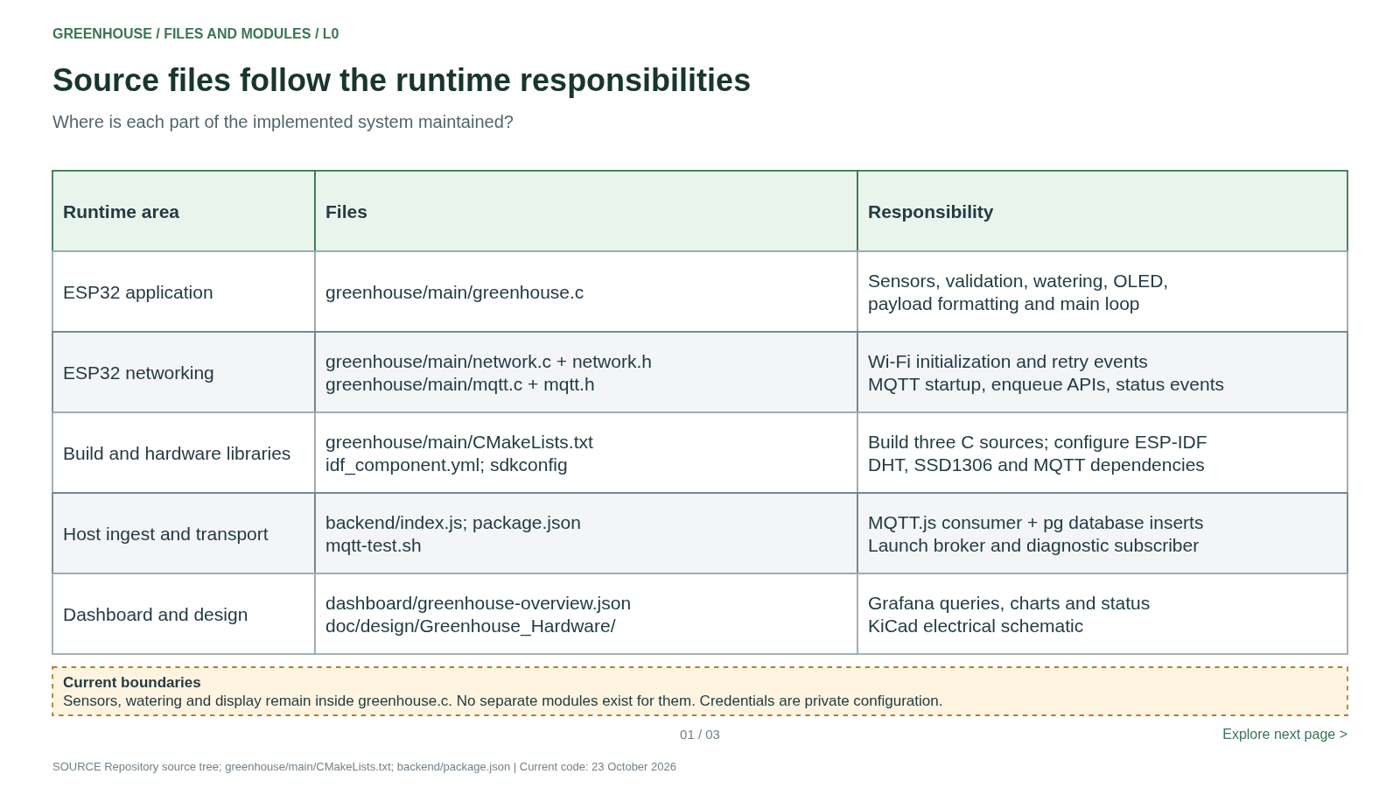
doc/design/System_Architecture/previews/07_Files_and_Modules/01-files-ownership.png
