kaloyanMilev13/GreenHouse/doc/design/System_Architecture/previews/07_Files_and_Modules/02-files-calls.png

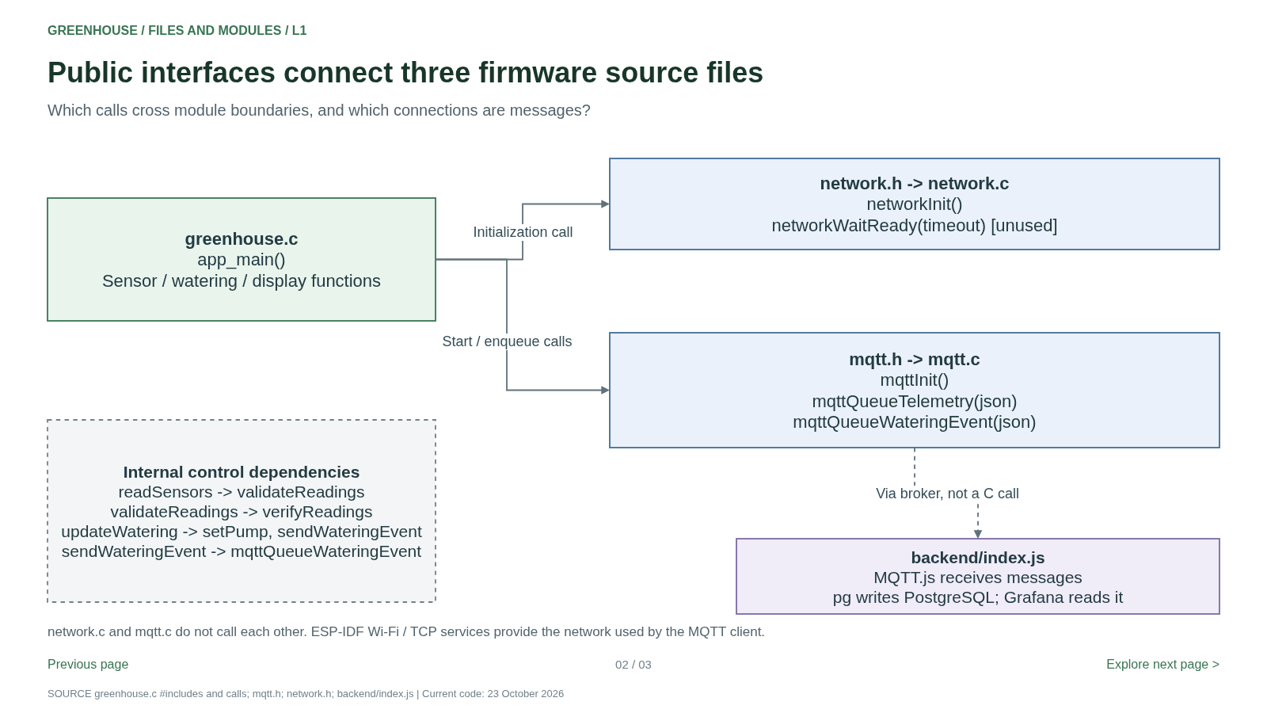
doc/design/System_Architecture/previews/07_Files_and_Modules/02-files-calls.png
