kaloyanMilev13/GreenHouse/doc/design/System_Architecture/previews/07_Files_and_Modules/03-files-data.png

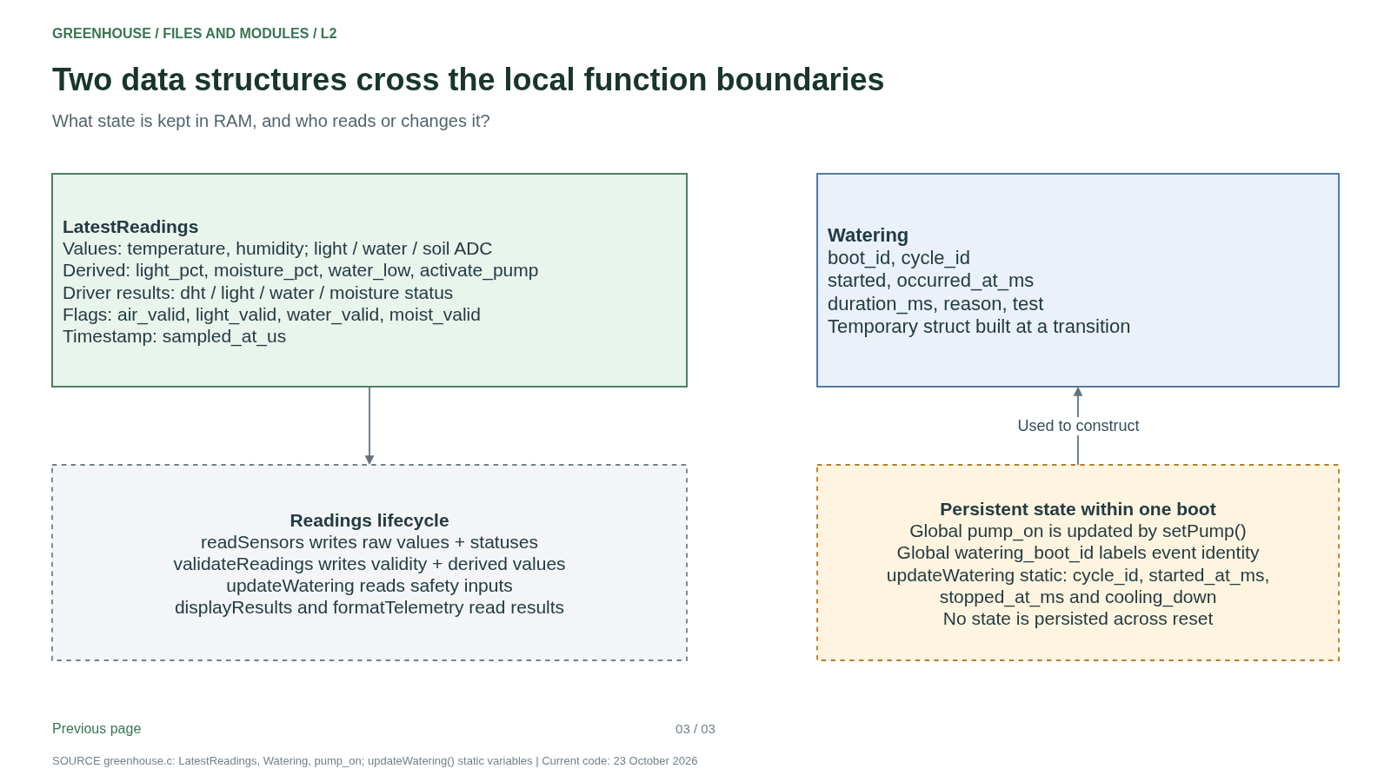
doc/design/System_Architecture/previews/07_Files_and_Modules/03-files-data.png
