kaloyanMilev13/GreenHouse/doc/design/System_Architecture/previews/08_Dashboard/01-dashboard-overview.png

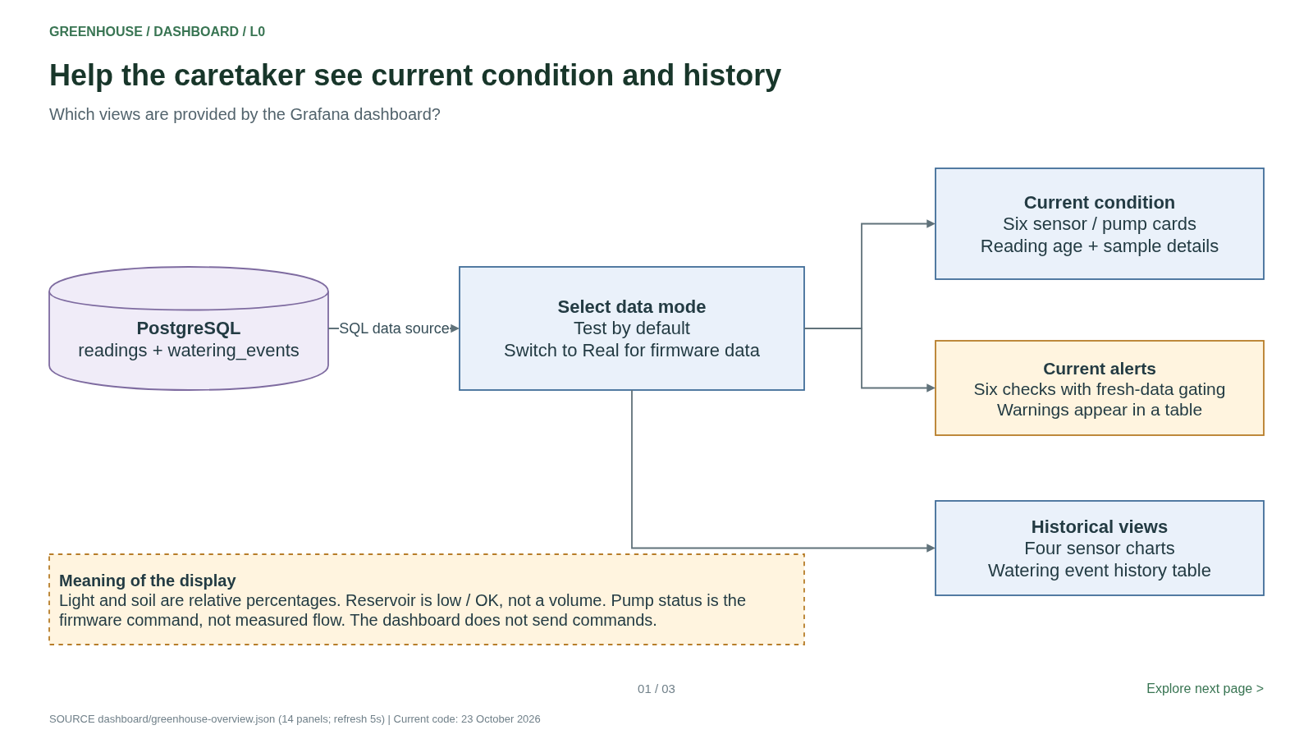
doc/design/System_Architecture/previews/08_Dashboard/01-dashboard-overview.png
