kaloyanMilev13/GreenHouse/doc/design/System_Architecture/previews/08_Dashboard/02-dashboard-queries.png

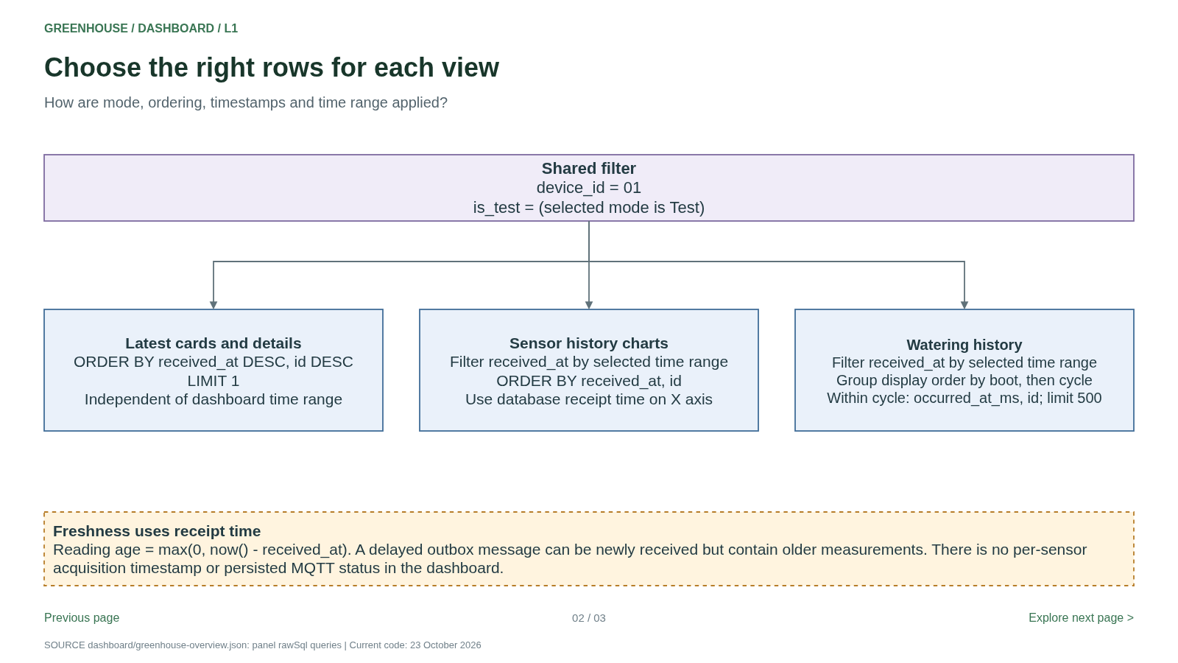
doc/design/System_Architecture/previews/08_Dashboard/02-dashboard-queries.png
