kaloyanMilev13/GreenHouse/doc/design/System_Architecture/previews/08_Dashboard/03-dashboard-alerts.png

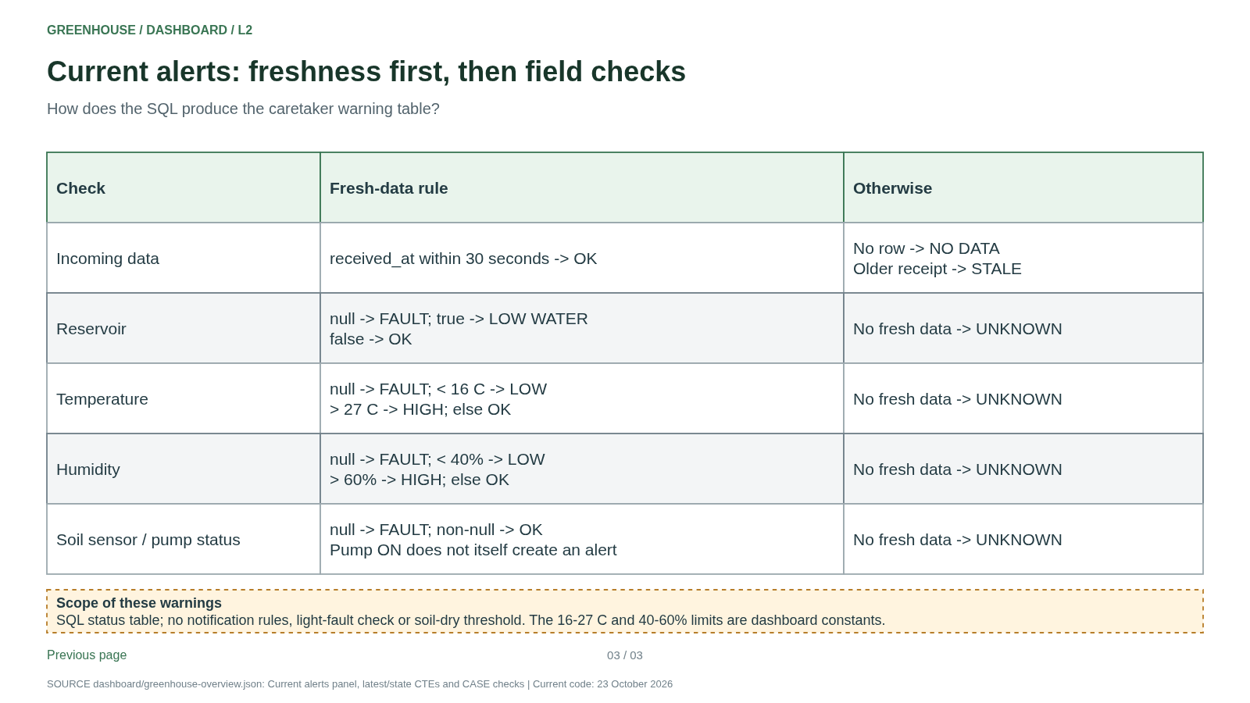
doc/design/System_Architecture/previews/08_Dashboard/03-dashboard-alerts.png
