kaloyanMilev13/GreenHouse/Pasted image.png

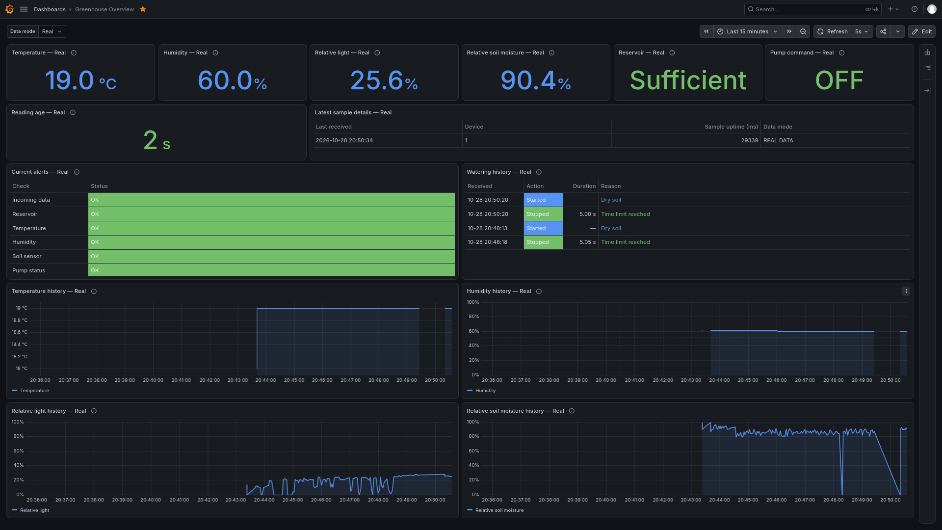
Pasted image.png
