kaloyanMilev13/GreenHouse/tmp/docx-courses/page-1.png

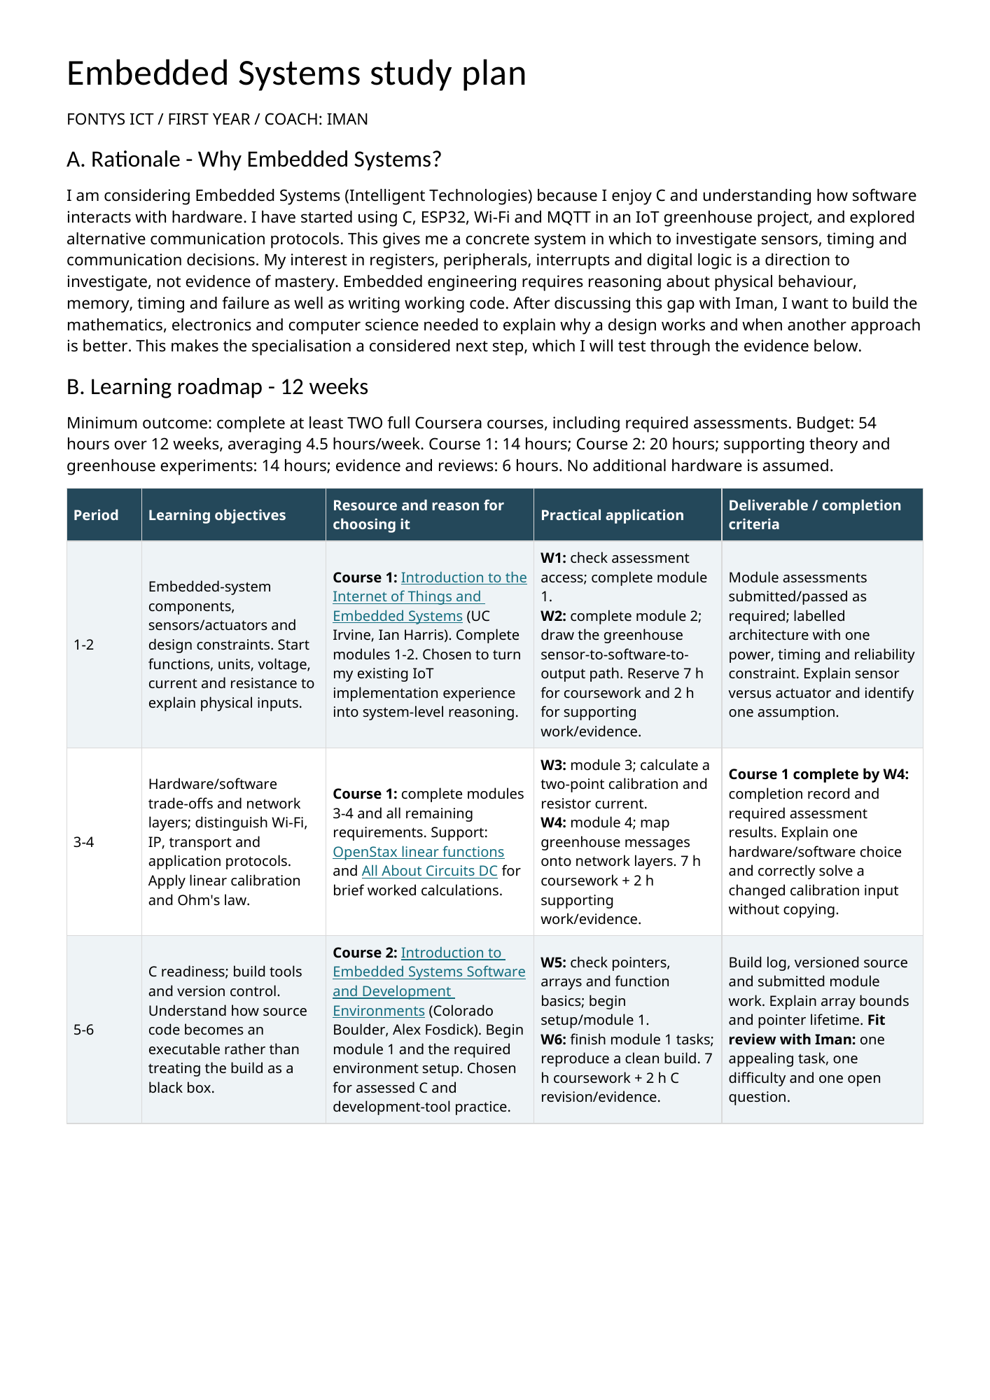
tmp/docx-courses/page-1.png
