kaloyanMilev13/GreenHouse/tmp/docx-courses/page-2.png

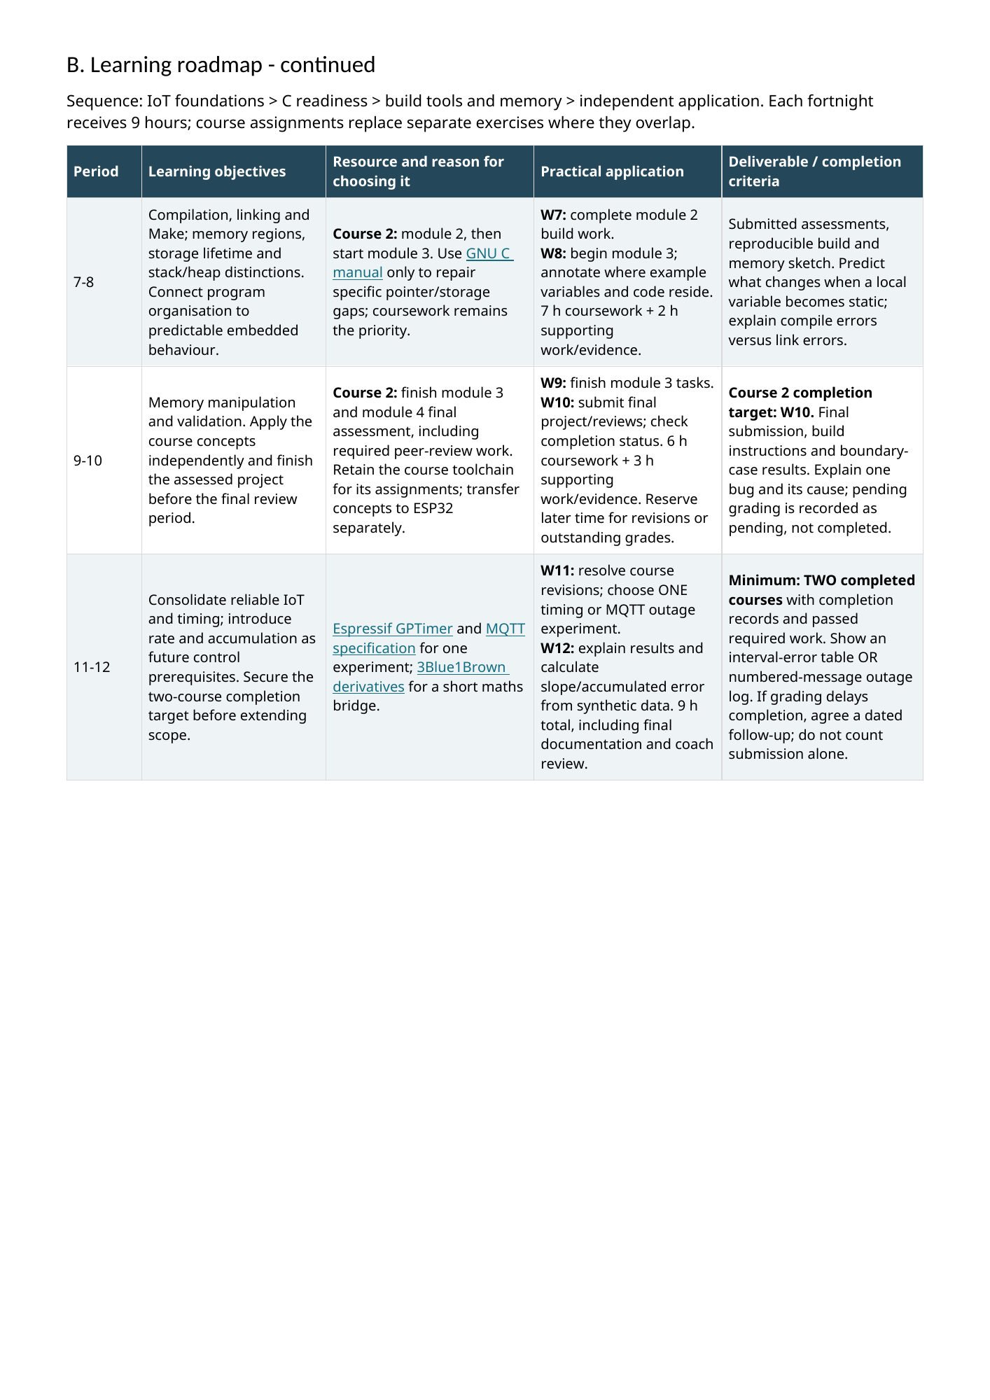
tmp/docx-courses/page-2.png
