kaloyanMilev13/GreenHouse/tmp/docx-courses/page-3.png

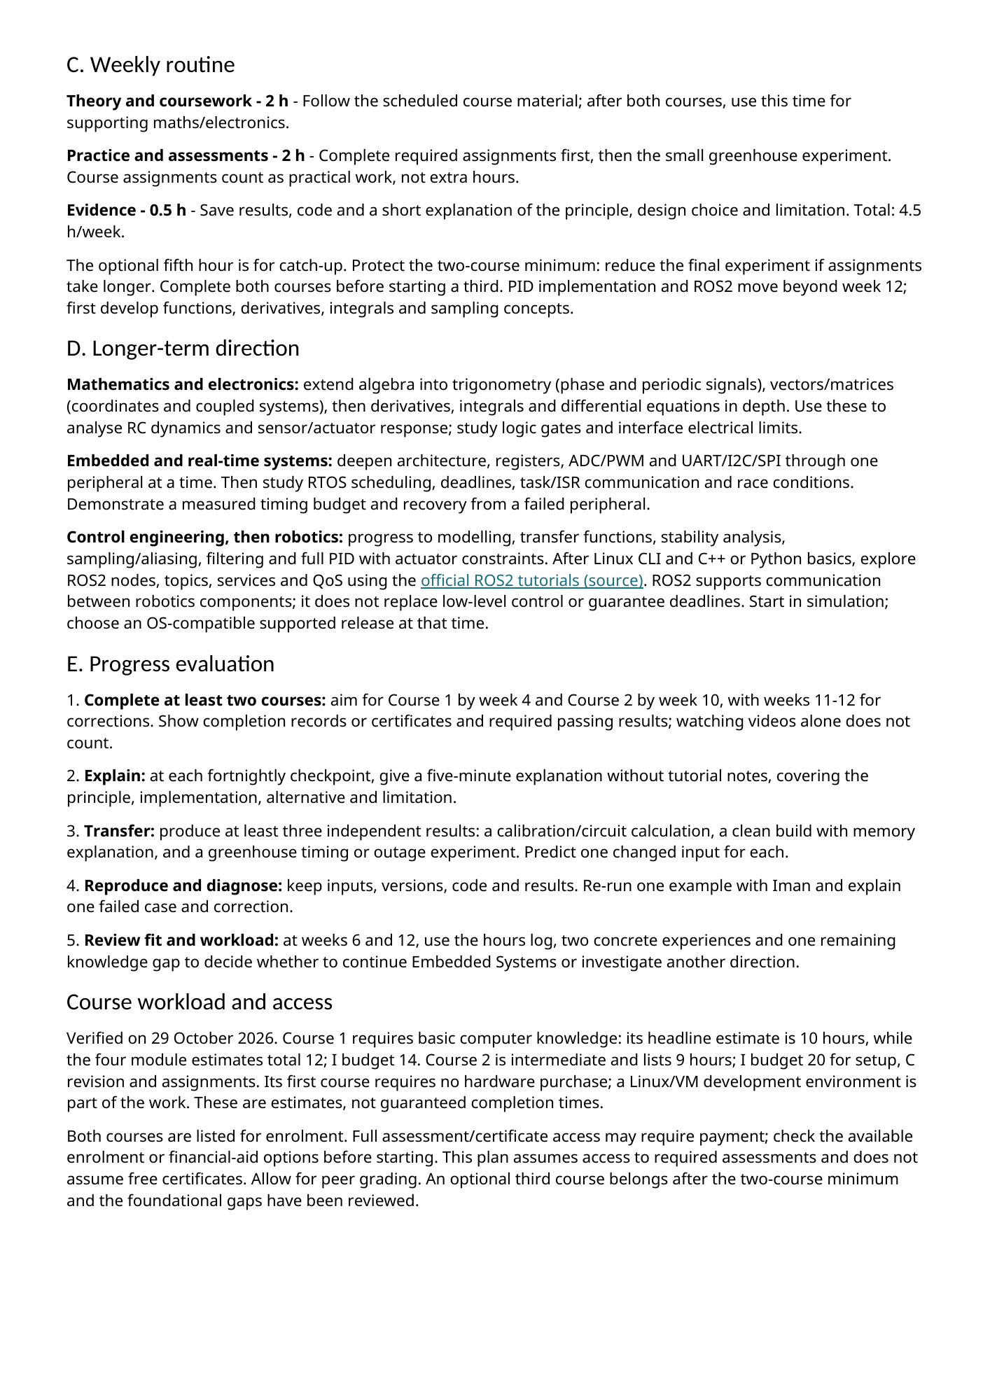
tmp/docx-courses/page-3.png
