kaloyanMilev13/GreenHouse/tmp/docx-final/page-1.png

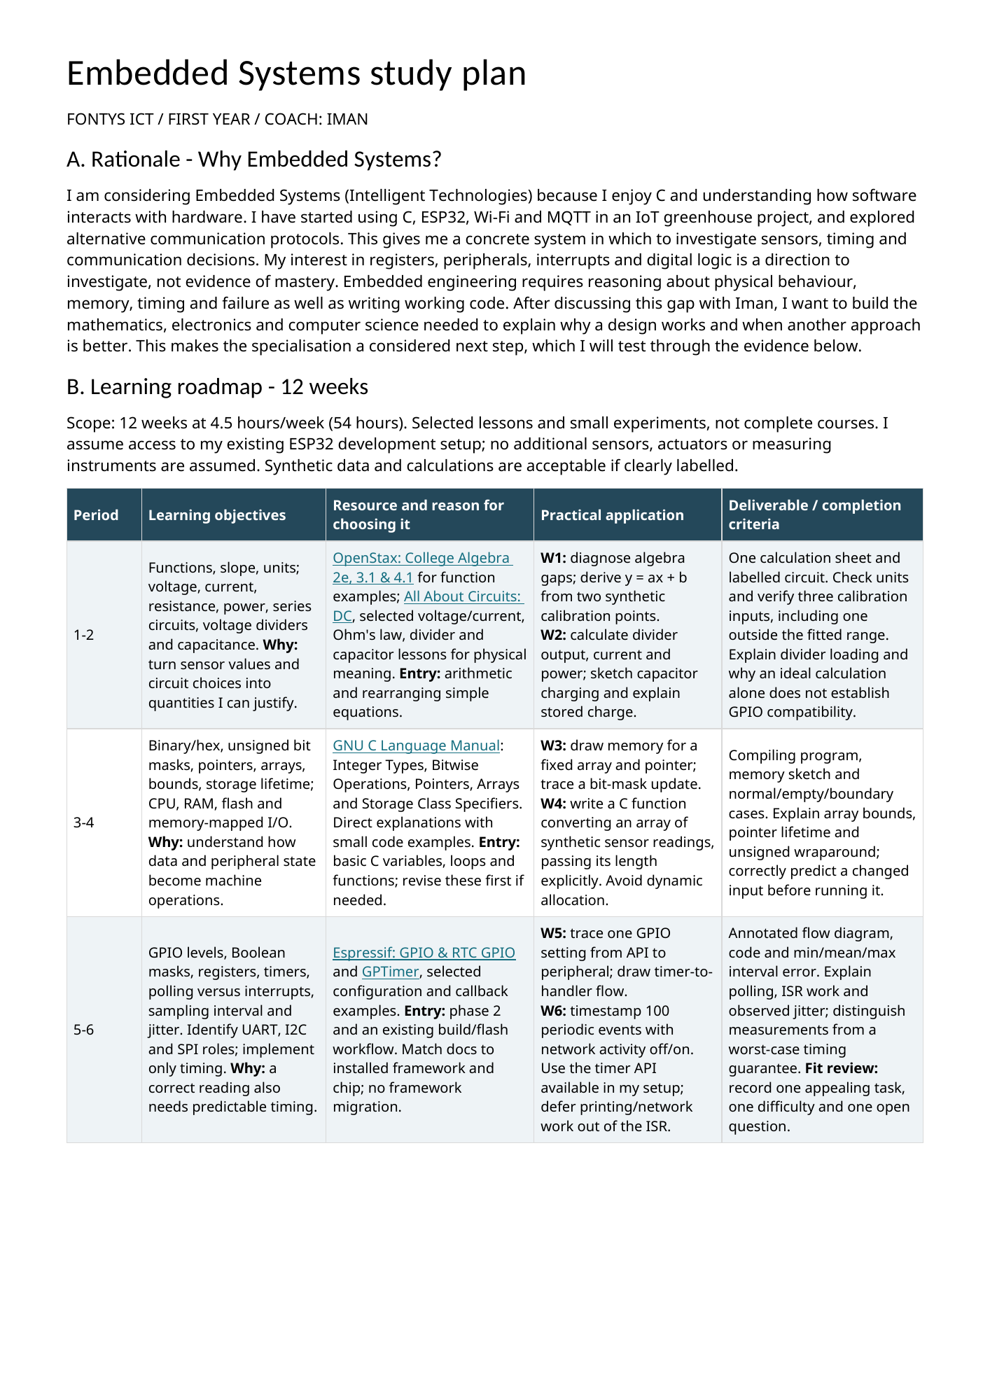
tmp/docx-final/page-1.png
