kaloyanMilev13/GreenHouse/tmp/docx-final/page-3.png

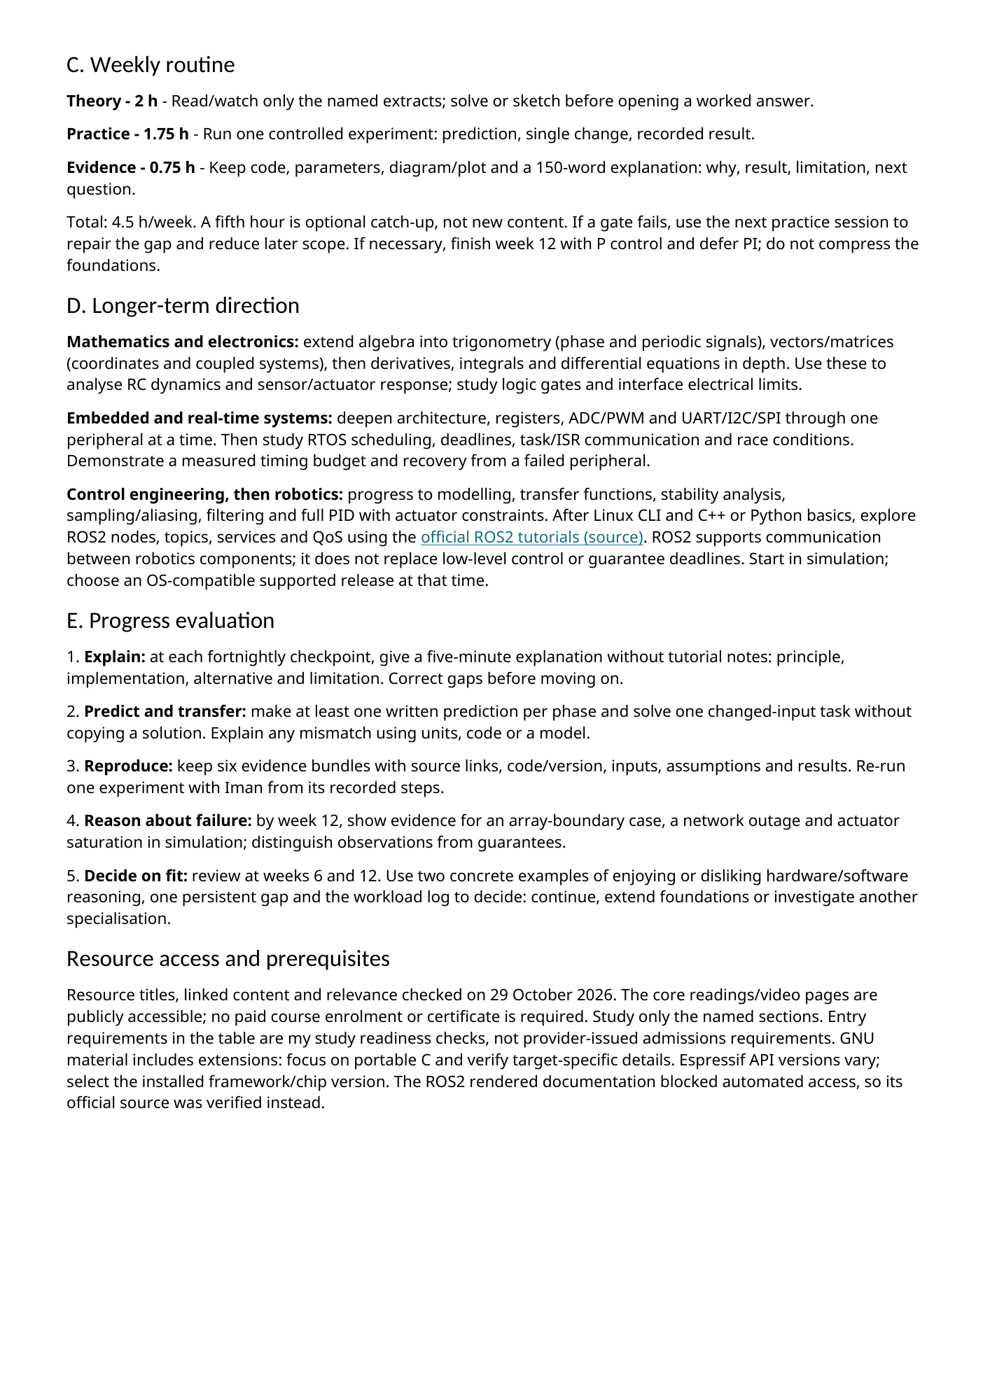
tmp/docx-final/page-3.png
