kaloyanMilev13/GreenHouse/tmp/docx-review/page-1.png

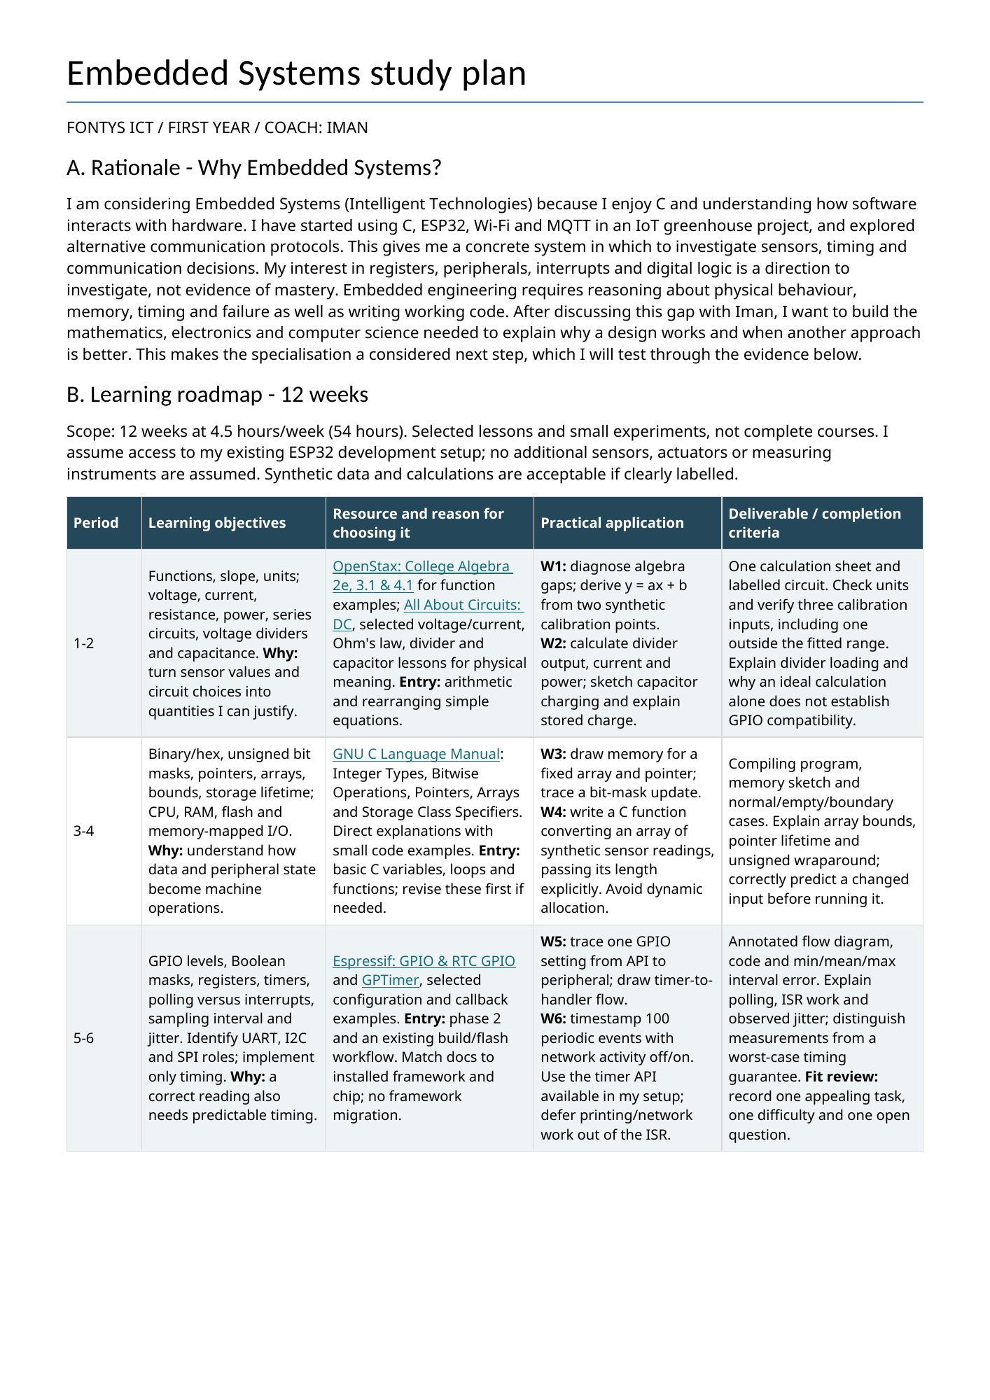
tmp/docx-review/page-1.png
