kaloyanMilev13/GreenHouse/tmp/docx-review/page-2.png

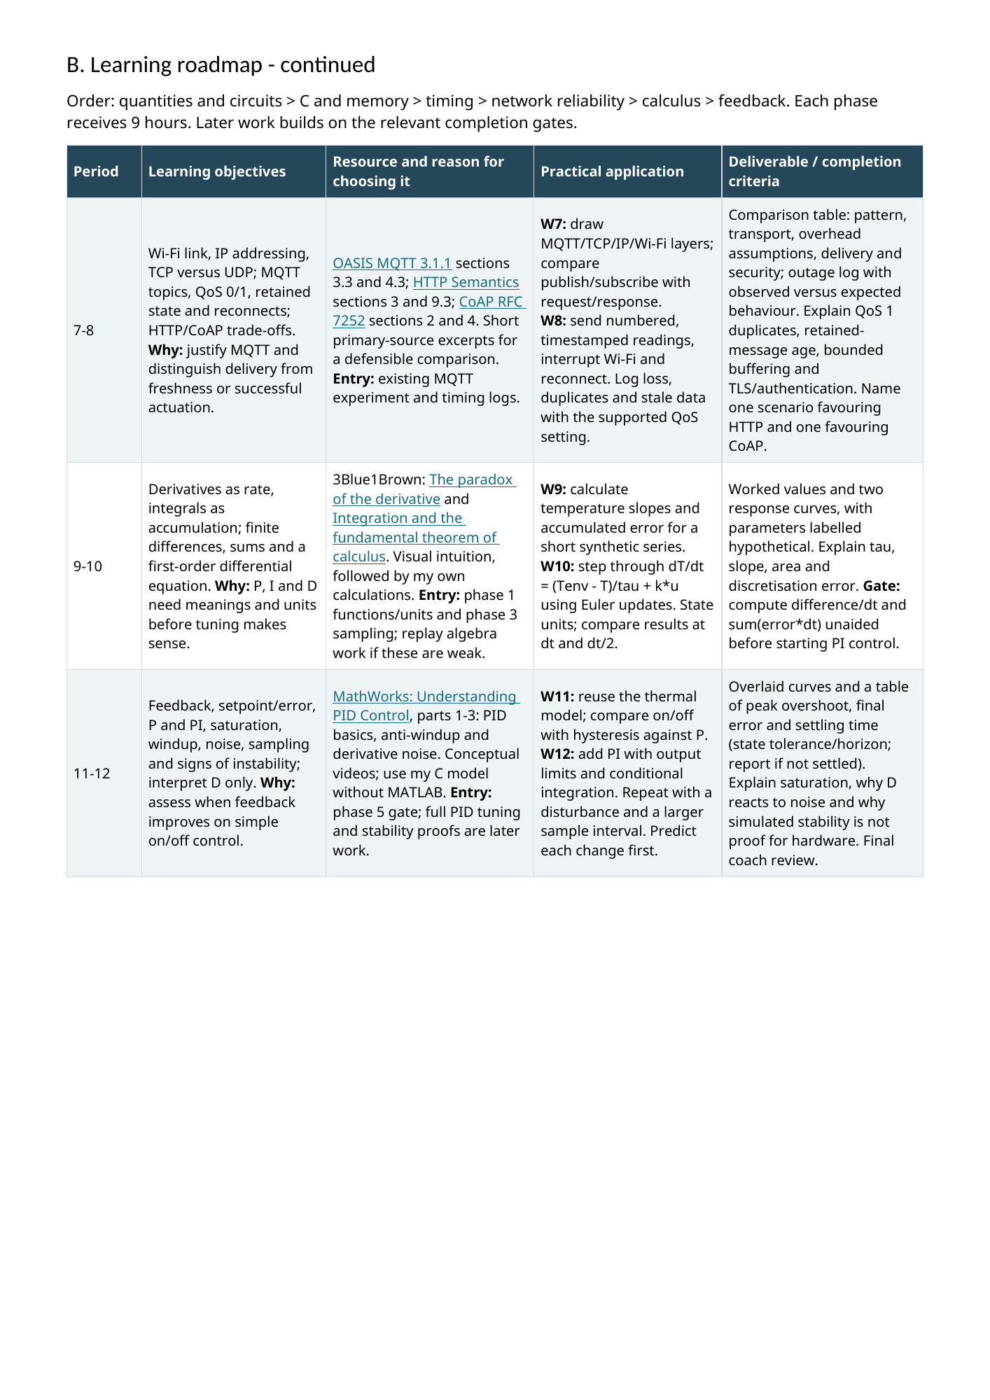
tmp/docx-review/page-2.png
