kaloyanMilev13/GreenHouse/tmp/pdfs/checked-1.png

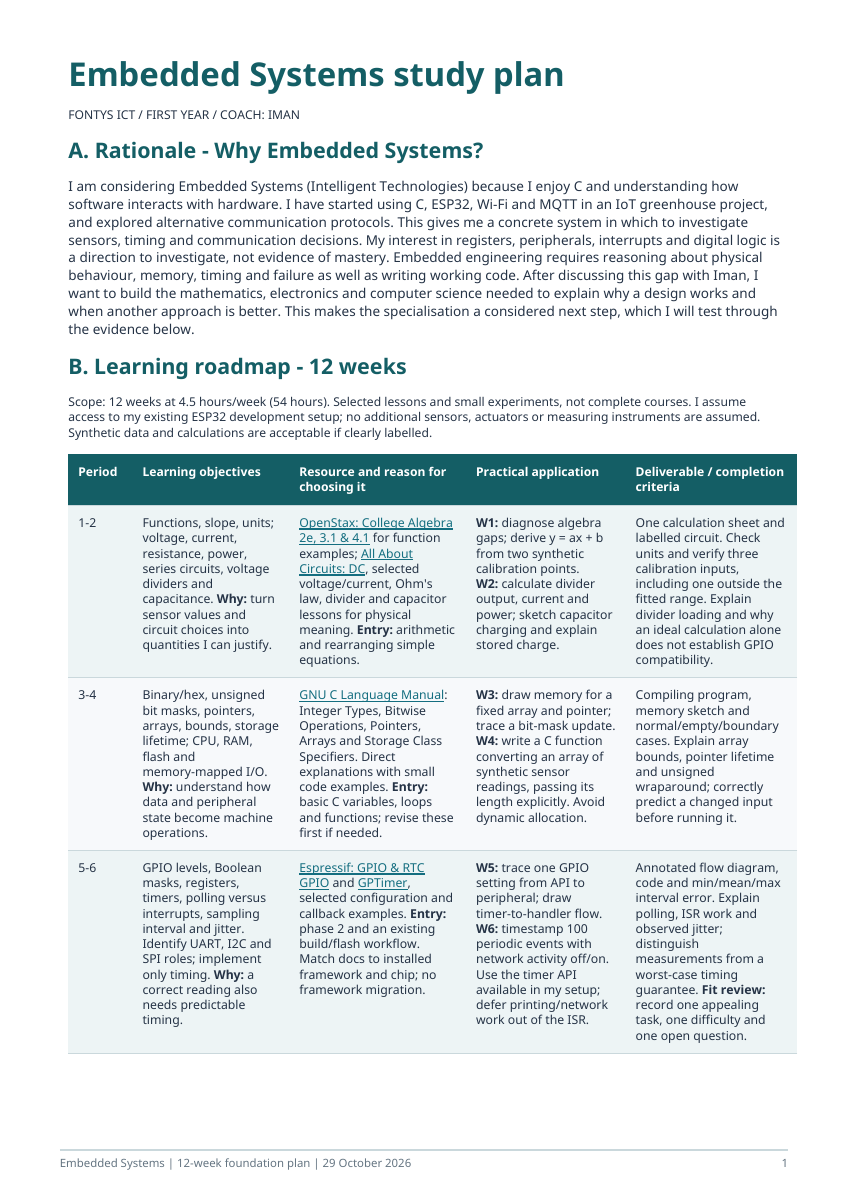
tmp/pdfs/checked-1.png
