kaloyanMilev13/GreenHouse/tmp/pdfs/checked-2.png

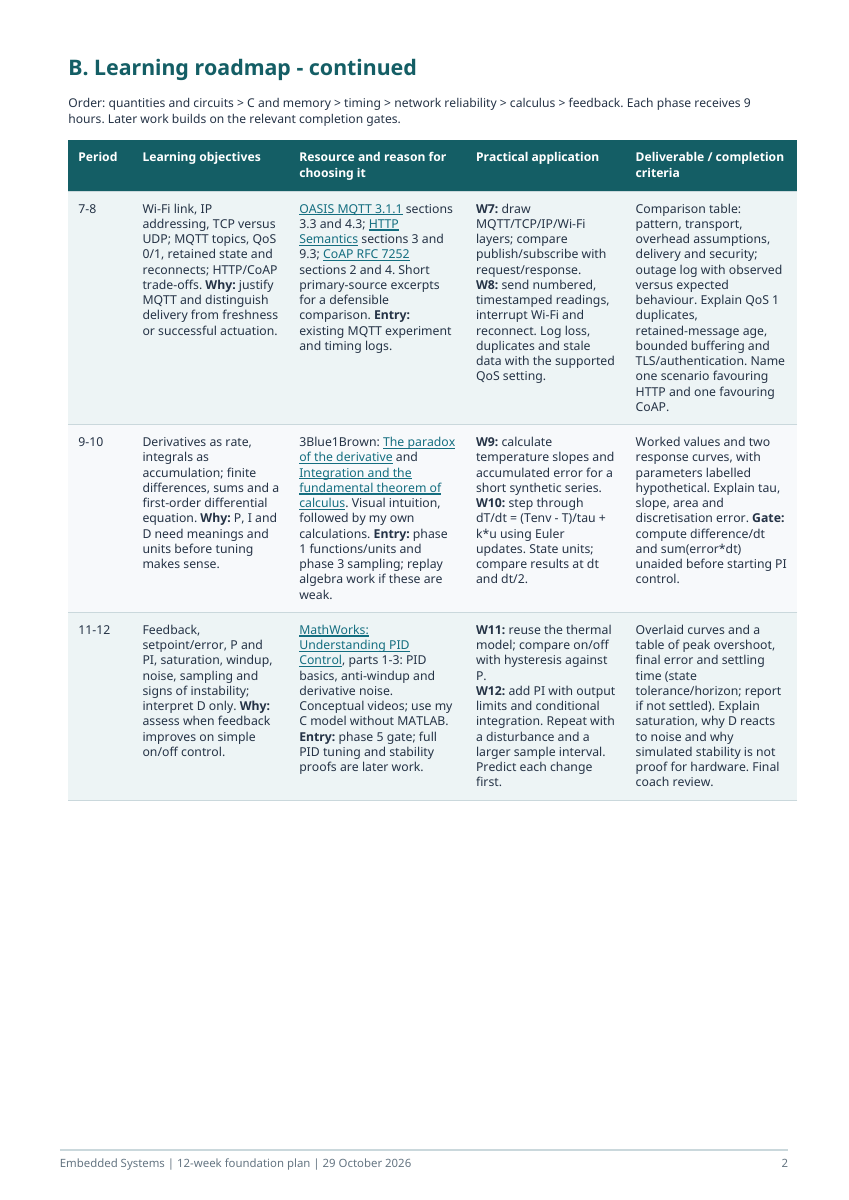
tmp/pdfs/checked-2.png
