kaloyanMilev13/GreenHouse/tmp/pdfs/checked-3.png

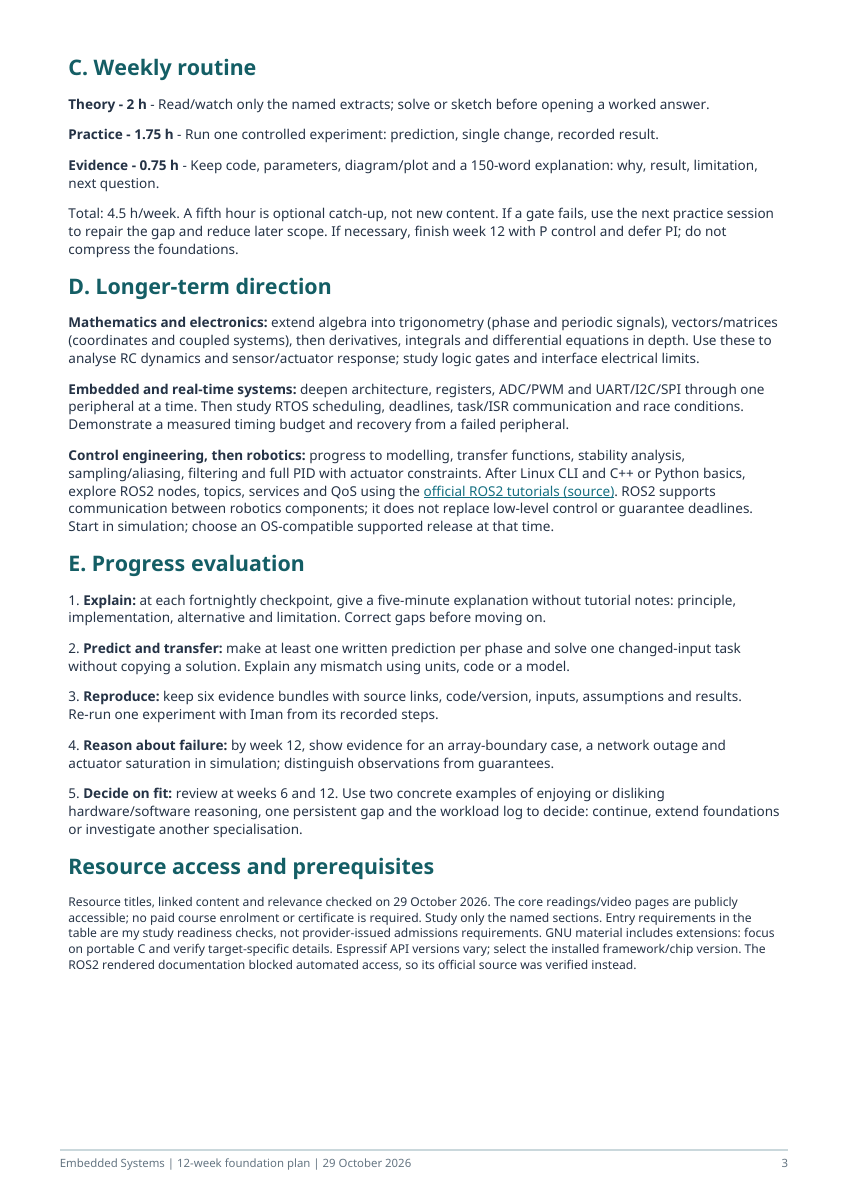
tmp/pdfs/checked-3.png
