kaloyanMilev13/GreenHouse/tmp/pdfs/final-1.png

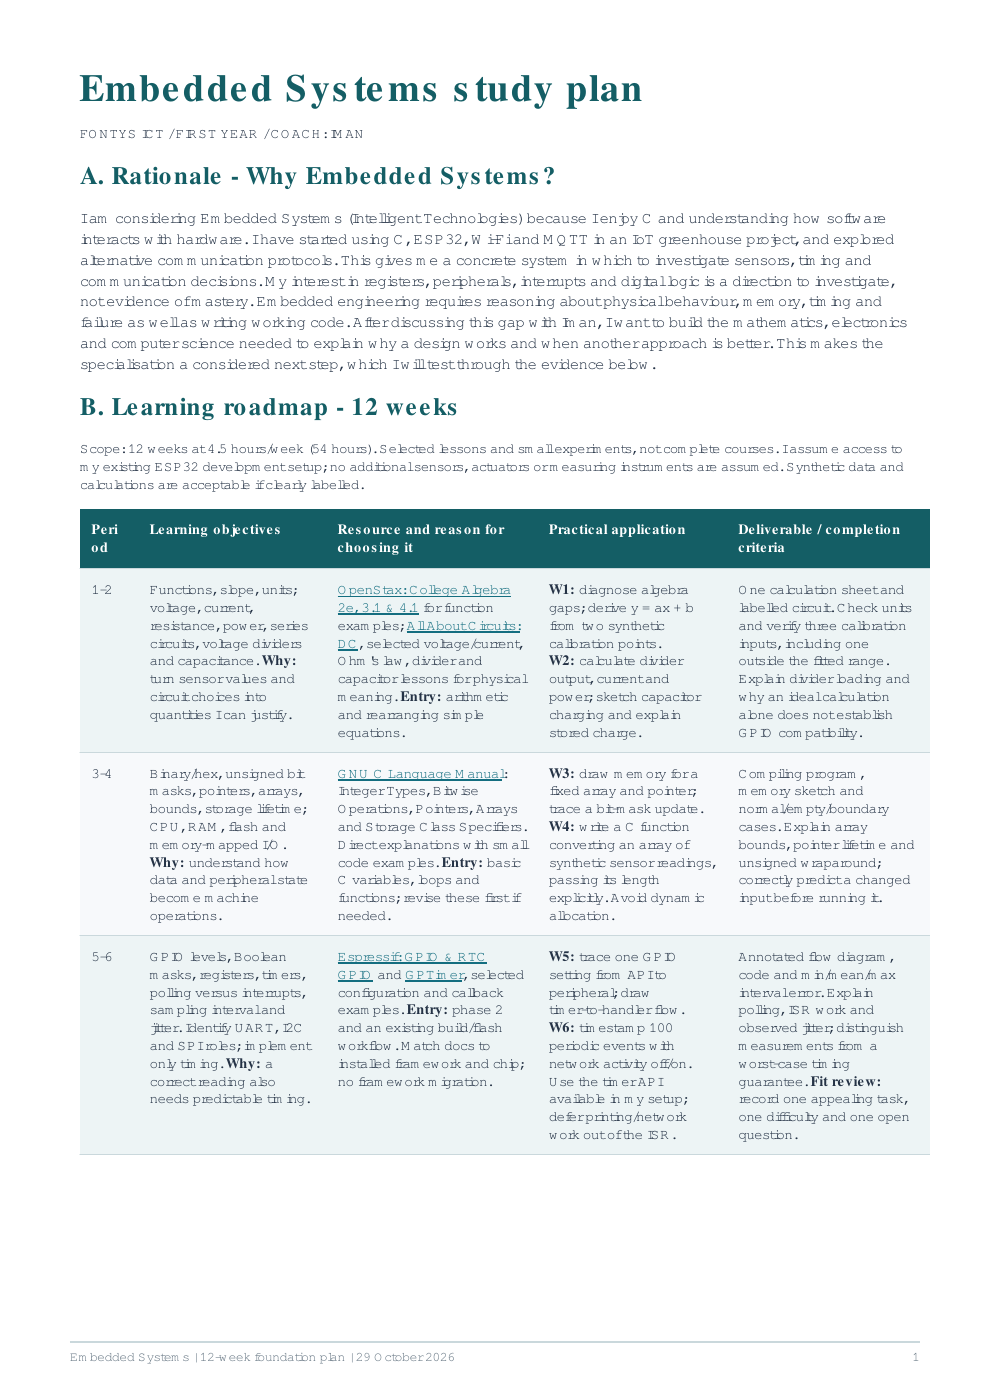
tmp/pdfs/final-1.png
