kaloyanMilev13/GreenHouse/tmp/pdfs/final-2.png

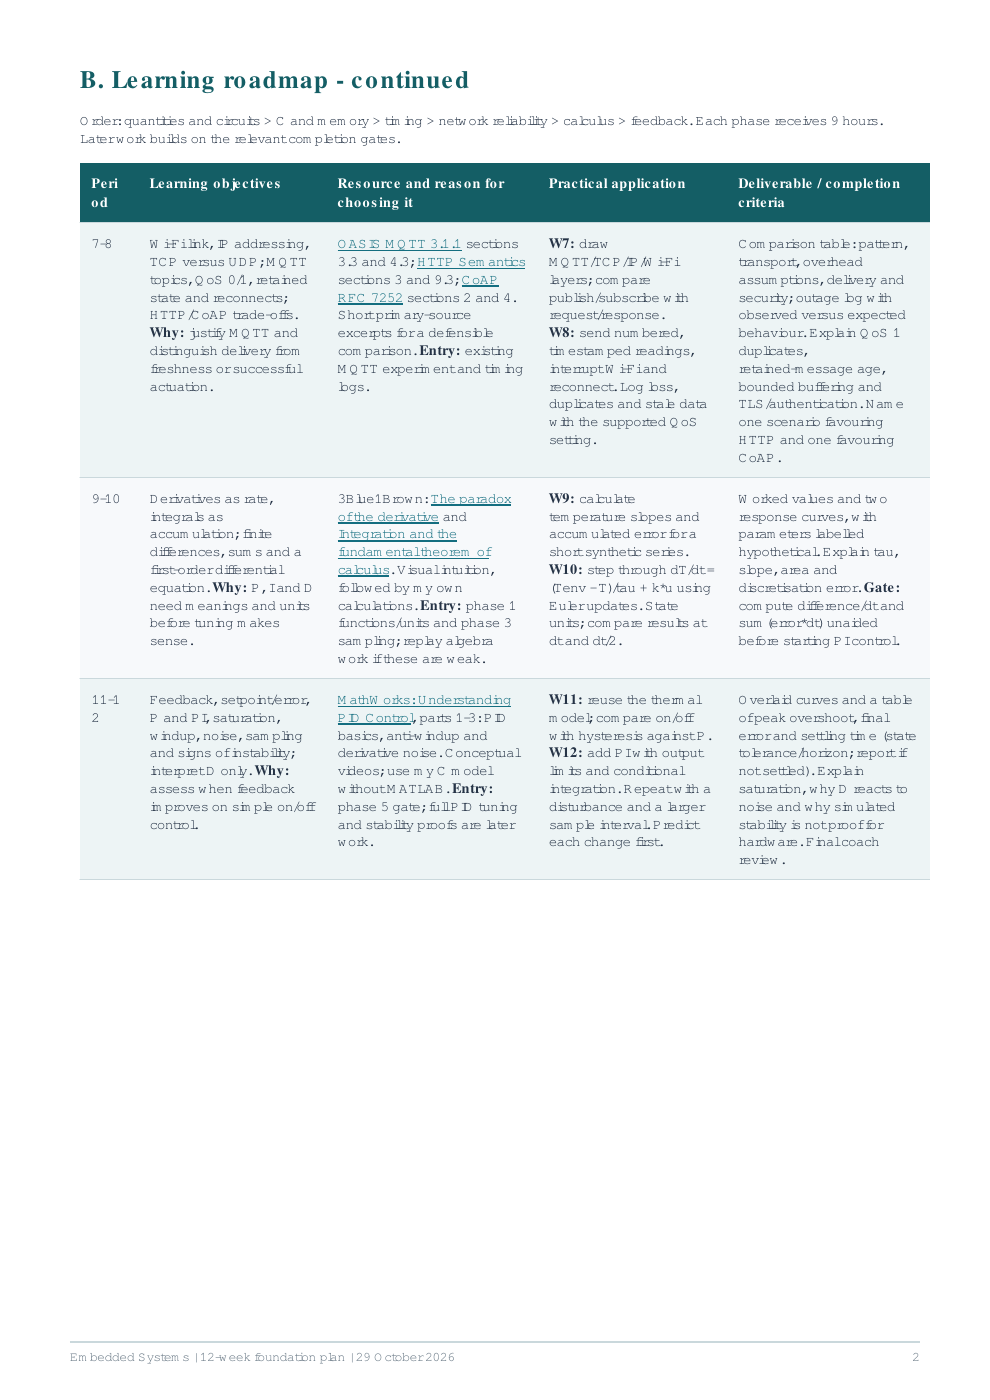
tmp/pdfs/final-2.png
