kaloyanMilev13/GreenHouse/tmp/pdfs/final-3.png

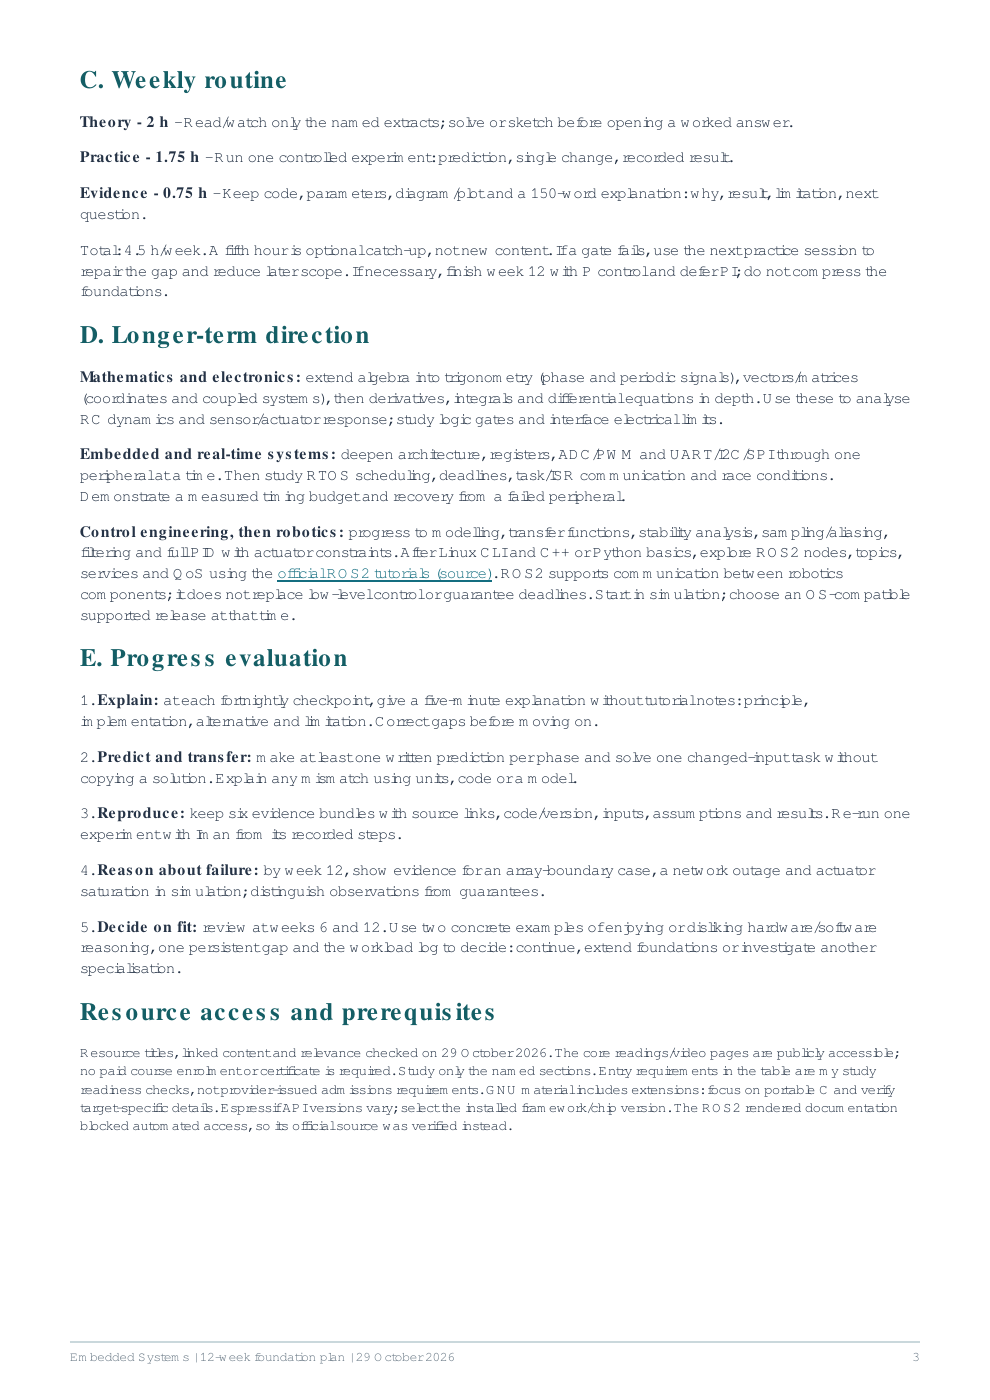
tmp/pdfs/final-3.png
