kaloyanMilev13/GreenHouse/tmp/pdfs/plan-1.png

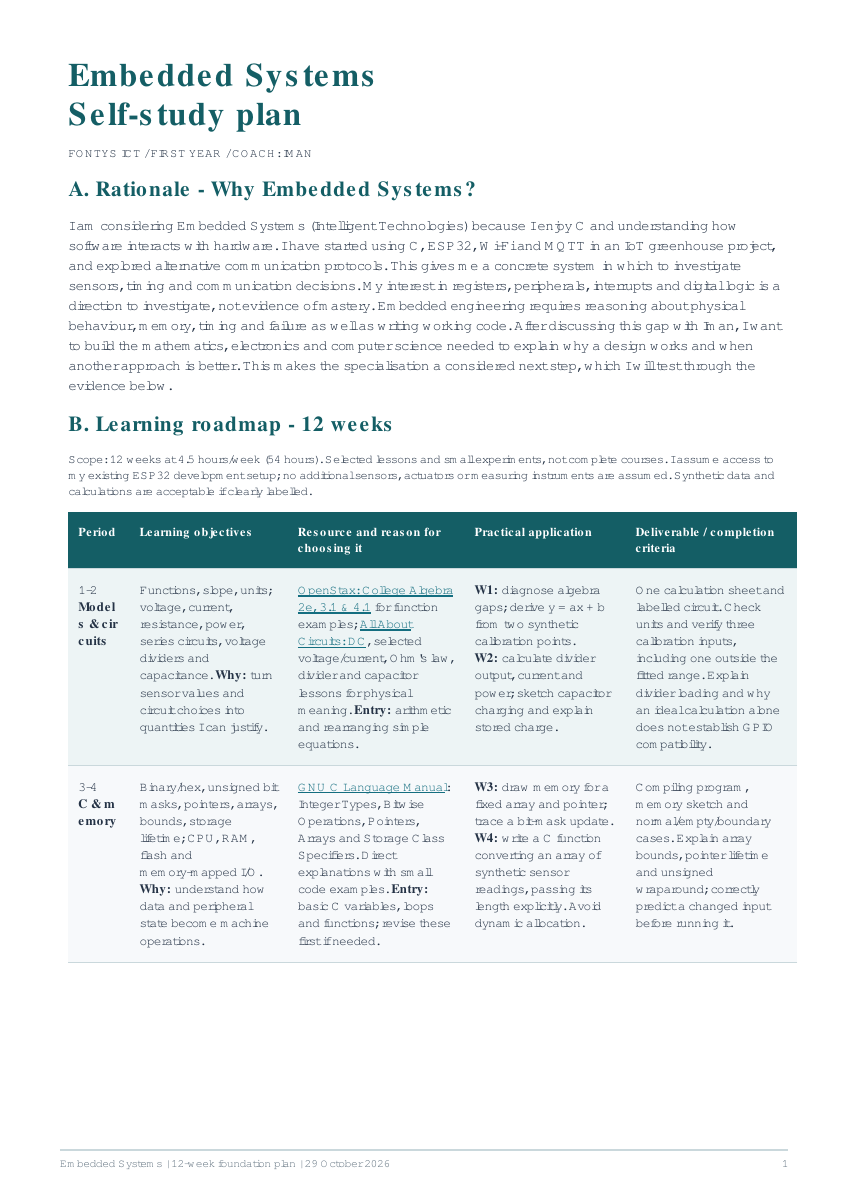
tmp/pdfs/plan-1.png
