kaloyanMilev13/GreenHouse/tmp/pdfs/plan-2.png

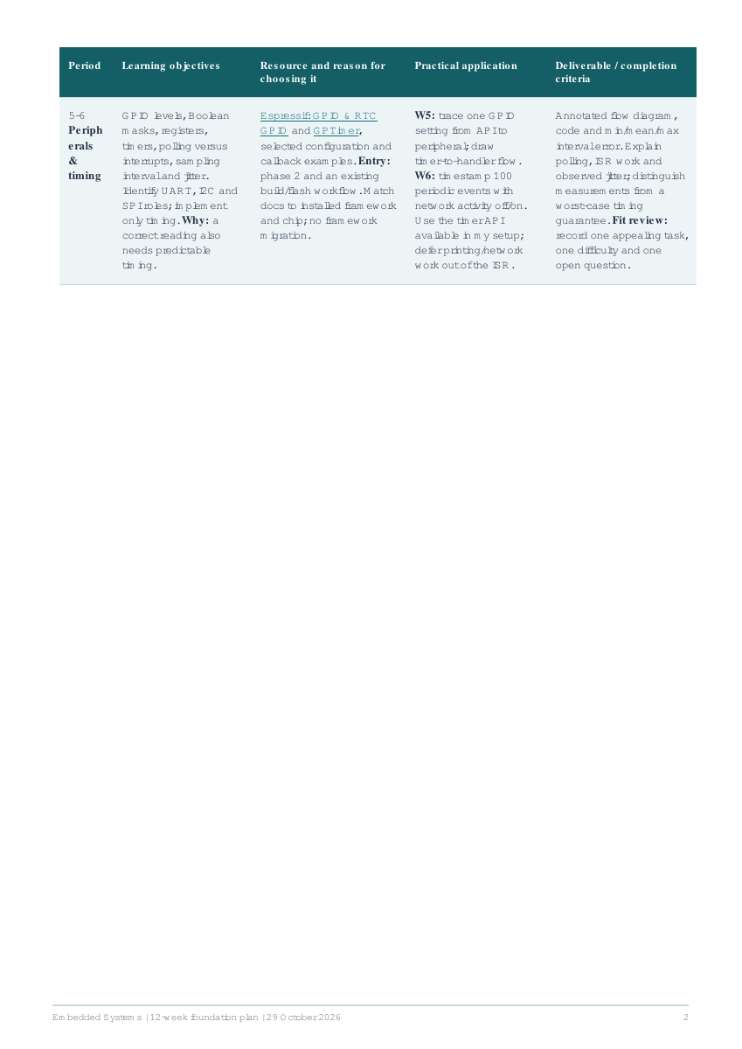
tmp/pdfs/plan-2.png
