kaloyanMilev13/GreenHouse/tmp/pdfs/plan-3.png

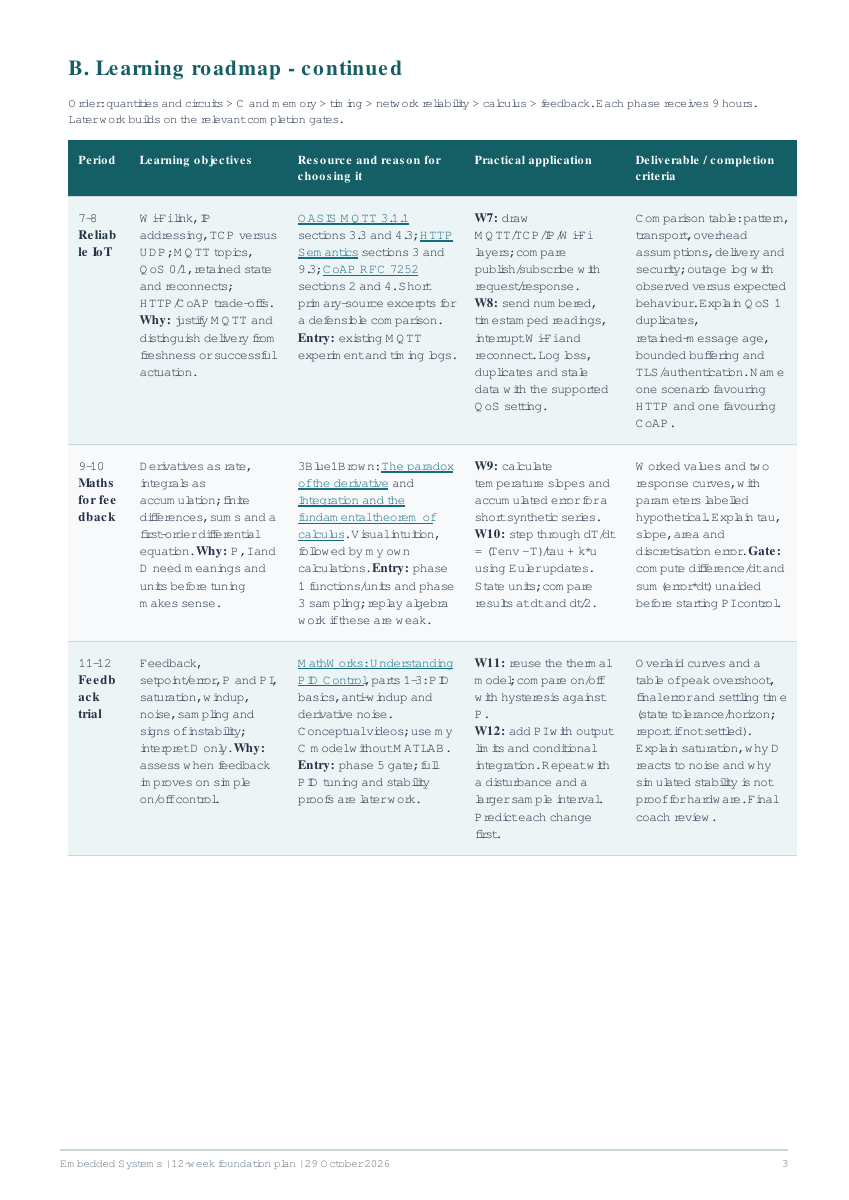
tmp/pdfs/plan-3.png
