kaloyanMilev13/GreenHouse/tmp/pdfs/plan-4.png

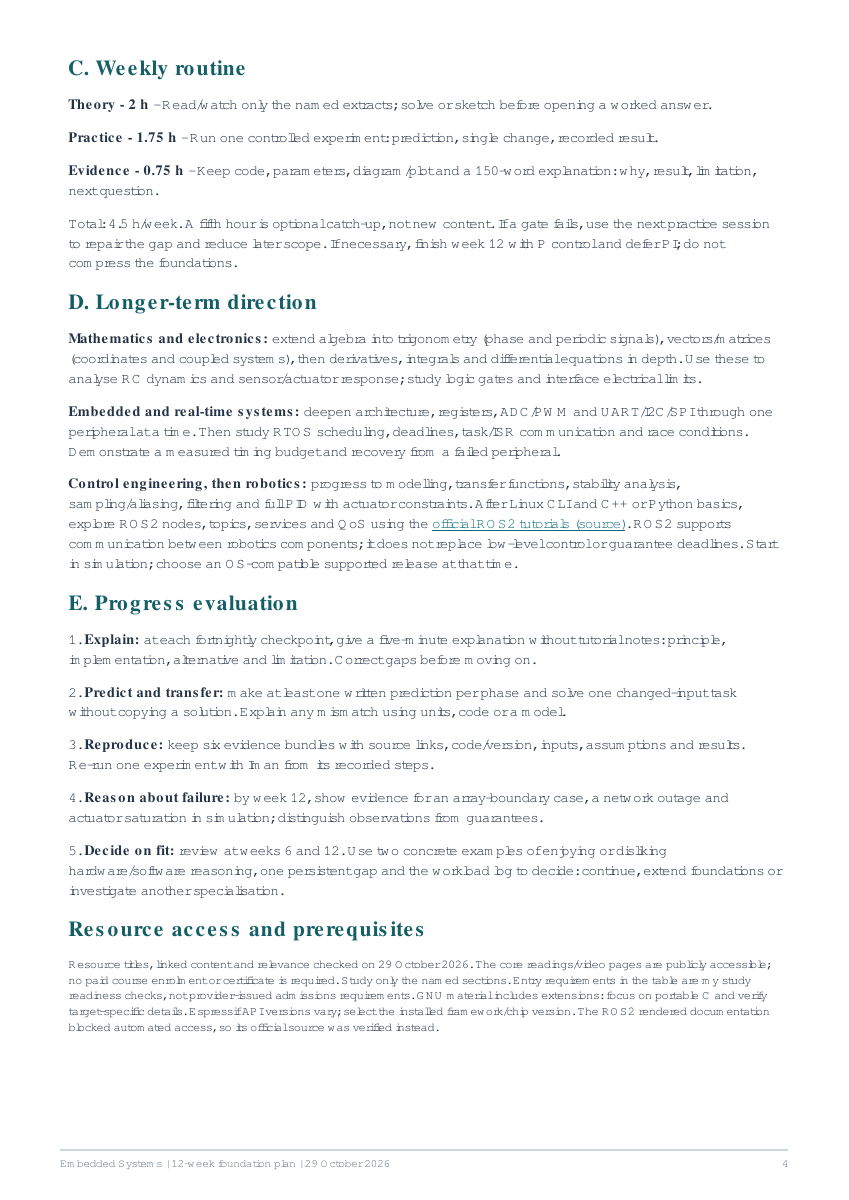
tmp/pdfs/plan-4.png
