kaloyanMilev13/GreenHouse/doc/analysis/parts.pdf

Sheet1

Category | Component | Exact part / specification
Controller | Microcontroller

USB cable

Sensors | Temperature and humidity DHT11 sensor module
Light | Photoresistor + LM393
Reservoir water level | K-0135 Sensor
Irrigation | Soil sensor and pump
| Water tubing
| Water reservoir | 200ml cup
Display | Local display
Power and wiring Pump power supply | Regulated 5V 2.5A DC supply
| Power connector
| Breadboard and wires
Plant setup | Plant | One small live plant in a pot

ESP32-DevKitC V4 with
ESP32-WROOM-32D
Micro-USB data cable for
programming and ESP32
power

M5Stack Watering Unit —
capacitive soil-moisture sensor + 5V pump

Tubing supplied with the
M5Stack unit

0.96″ SSD1306 OLED, 128 ×
64, I²C

Matching female DC barreljack to screw-terminal adapter Solderless breadboard + jumper wires
