kaloyanMilev13/GreenHouse/doc/planning/Online Gantt 20261013(1).csv

Outline Level | ID | Name | Start | Finish | Duration | % Complete | Predecessors | Resource Names | Color | Notes
1 | 1 | Week 1 - Analysis / Advice | 2026-09-28 | 2026-10-02 | 5 day | 0 |  |  | 210 | <p>Weekly work window. Subtasks share the available time; bar length is not full-time effort.</p>
2 | 2 | Set scope, requirements and project plan | 2026-09-28 | 2026-09-30 | 3 day | 0 |  |  | 210 | <p>Agree the one-plant scope, MoSCoW priorities and four-week plan. Complete the analysis and advice.</p>
2 | 3 | Select technologies and collect parts | 2026-09-29 | 2026-10-02 | 4 day | 0 |  |  | 210 | <p>Finish technical choices. Check the ESP32, sensors, pump, OLED, power supply and any missing parts.</p>
2 | 4 | Sketch wiring and system architecture | 2026-10-01 | 2026-10-02 | 2 day | 0 |  |  | 210 | <p>Draft the wiring and the connection between ESP32, MQTT, backend, database and dashboard.</p>
1 | 5 | Week 2 - Design and prototypes | 2026-10-05 | 2026-10-09 | 5 day | 0 |  |  | 160 | <p>Weekly work window. Subtasks share the available time; bar length is not full-time effort.</p>
2 | 6 | Design wiring, MQTT and database | 2026-10-05 | 2026-10-07 | 3 day | 0 |  |  | 160 | <p>Define pins, irrigation rules, MQTT messages, database tables and display content.</p>
2 | 7 | Prototype sensors, irrigation and local display | 2026-10-07 | 2026-10-09 | 3 day | 0 |  |  | 160 | <p>Read sensors, show values on the OLED and try the pump with low-water protection.</p>
2 | 8 | Test prototype and data connection | 2026-10-08 | 2026-10-09 | 2 day | 0 |  |  | 160 | <p>Check sensor readings and pump behaviour. Send a reading from the ESP32 through MQTT to the backend and database.</p>
1 | 9 | Week 3 - Realization and testing | 2026-10-12 | 2026-10-16 | 5 day | 0 |  |  | 35 | <p>Weekly work window. Subtasks share the available time; bar length is not full-time effort.</p>
2 | 10 | Complete firmware and backend | 2026-10-12 | 2026-10-15 | 4 day | 0 |  |  | 35 | <p>Finish local irrigation, fault handling and the Node.js backend. Keep essential device functions working without the server.</p>
2 | 11 | Connect storage, dashboard and alerts | 2026-10-13 | 2026-10-16 | 4 day | 0 |  |  | 35 | <p>Connect PostgreSQL, Grafana, current readings, history, watering events and alerts.</p>
2 | 12 | Test integration and update documents | 2026-10-14 | 2026-10-16 | 3 day | 0 |  |  | 35 | <p>Test the full system, record defects and update analysis, technical details or designs where implementation changed.</p>
1 | 13 | Week 4 - Validation / Verification | 2026-10-19 | 2026-10-23 | 5 day | 0 |  |  | 270 | <p>Weekly work window. Subtasks share the available time; bar length is not full-time effort.</p>
2 | 14 | Verify requirements and validate use | 2026-10-19 | 2026-10-21 | 3 day | 0 |  |  | 270 | <p>Check all Must Haves, pump safeguards, alerts and offline operation. Demonstrate that the system meets the user needs.</p>
2 | 15 | Fix defects and repeat tests | 2026-10-20 | 2026-10-22 | 3 day | 0 |  |  | 270 | <p>Correct issues and repeat affected tests, including irrigation protection and the full data path.</p>
2 | 16 | Finish documentation and submit | 2026-10-21 | 2026-10-23 | 3 day | 0 |  |  | 270 | <p>Complete the report and setup guidance. On the final day, recheck the corrected system, demonstrate it and submit.</p>
