kaloyanMilev13/GreenHouse/doc/design/Greenhouse_Hardware/previews/Wiring_Table/01-wiring-signals.png

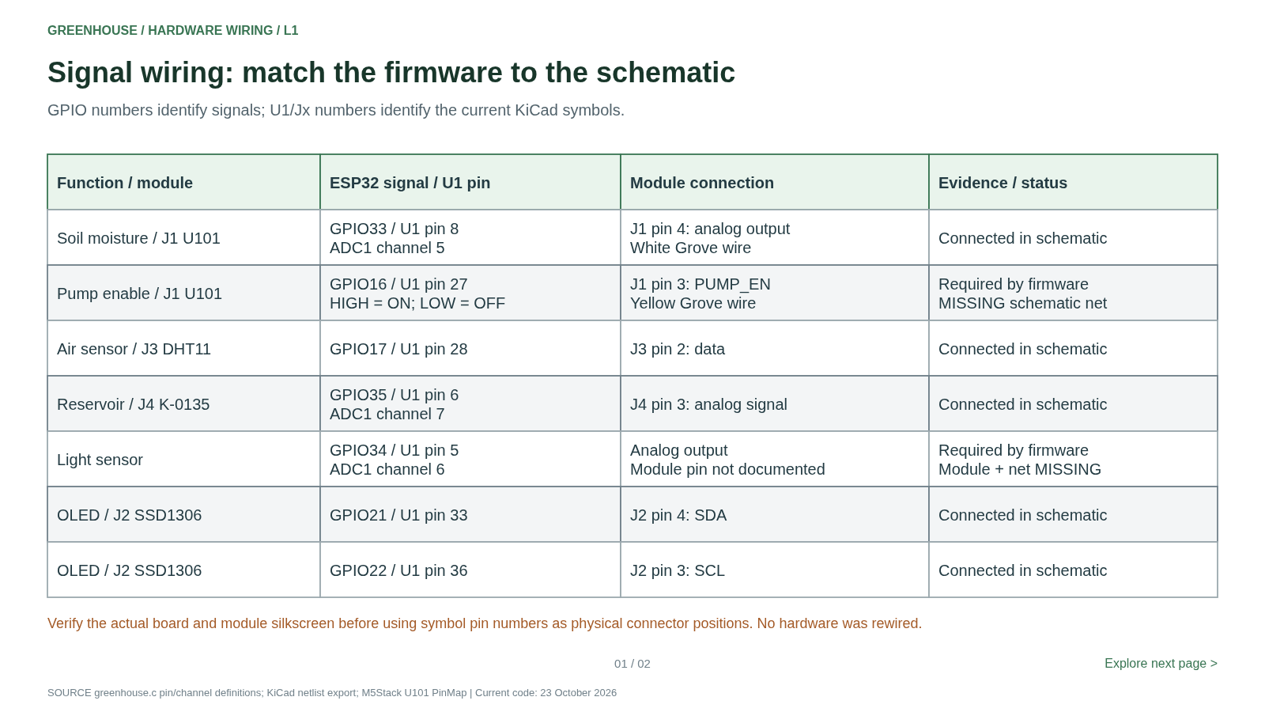
doc/design/Greenhouse_Hardware/previews/Wiring_Table/01-wiring-signals.png
