kaloyanMilev13/GreenHouse/doc/design/Greenhouse_Hardware/previews/Wiring_Table/02-wiring-power.png

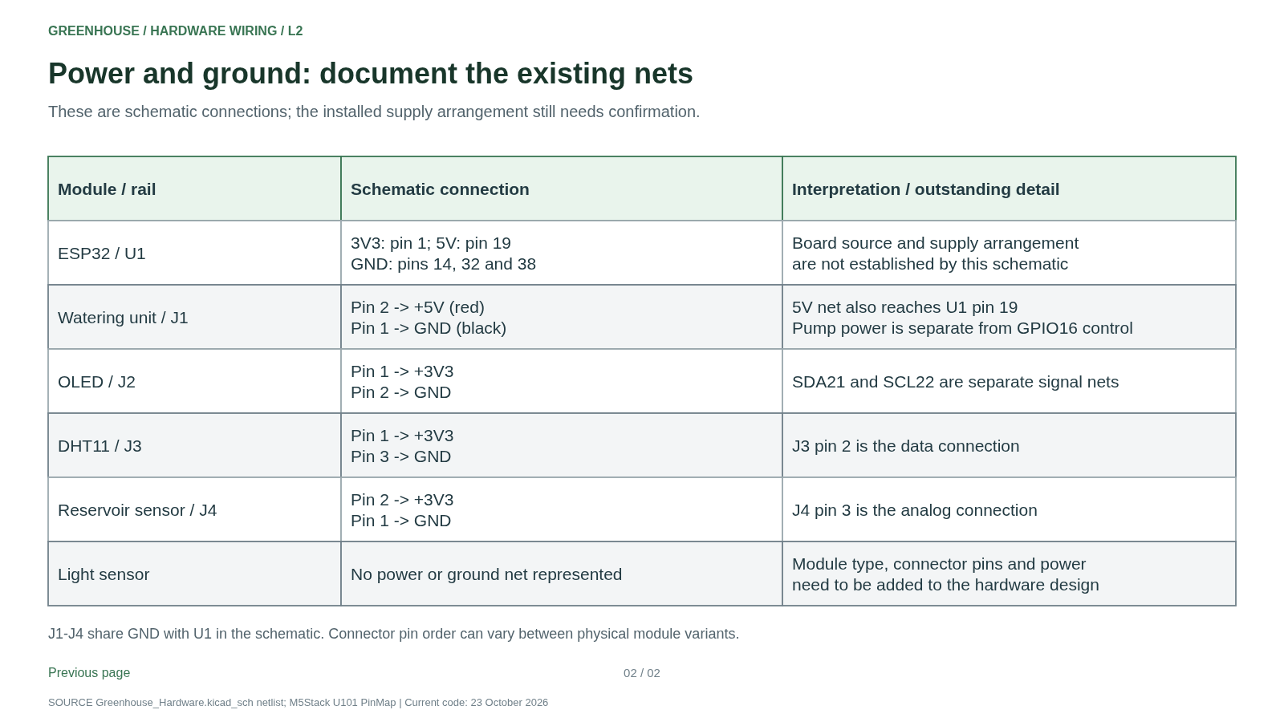
doc/design/Greenhouse_Hardware/previews/Wiring_Table/02-wiring-power.png
