kaloyanMilev13/GreenHouse/doc/validation/evidence/2026-10-28/caretaker-validation.md

# Caretaker validation record

Recorded 28 October 2026. Tester: project author acting as caretaker. Method: caretaker self-test, confirmed by the author in the project conversation.

## Confirmation

> i tested it as a caretaker and everything for validation is passed

This confirmation applies to VAL-01 through VAL-05. The table below transcribes the final report’s qualitative findings. It is a record of author-reported results, not an automated test log or an independent assessment.

| Validation | Task | Result | Finding recorded in the report |
|---|---|---|---|
| VAL-01  Understand the plant condition / FR-01, FR-05, FR-08, FR-11 | Read the soil condition, reservoir status, temperature and humidity from the display and dashboard. | PASS | I could read the soil condition, water level, temperature and humidity. The DRY, OK and WET labels made the soil reading understandable. |
| VAL-02  Know when to act / FR-02, FR-04, FR-05, FR-09 | Recognise low water, a sensor problem and an air warning, and explain what action to take. | PASS | I recognised the low-water, sensor and air warnings and understood the action needed, such as refilling the reservoir or checking a sensor. |
| VAL-03  Receive a useful amount of water / FR-01 to FR-04 | Check that automatic watering starts when needed, stops automatically and provides useful watering for routine care. | PASS | I found the automatic watering useful for routine plant care. Watering started when needed and stopped automatically. I accepted its behaviour for this use. |
| VAL-04  Understand watering history / FR-06 to FR-08 | Find three watering cycles, explain why each stopped and distinguish Test from Real data. | PASS | I could find three watering cycles, understand why each stopped and distinguish Test data from Real data. |
| VAL-05  Cope with a network failure / FR-09 and FR-10 | Use the local display when the dashboard shows STALE. Confirm that dashboard updates resume after reconnection. | PASS | I used the local display while the dashboard showed STALE. After reconnection, dashboard updates resumed. |

## Acceptance scope

VAL-03 records acceptance of automatic watering for routine care. It does not record a measured 100–150 ml dose or a long-term plant-growth result. VAL-05 records local-display use during interruption and resumed dashboard updates; it does not claim acquisition-time verification for queued data. No completion times, measured water volumes, trial date or video timestamps were supplied with the confirmation. The date above is the record date.

Source report: [Verification and Validation](../../Greenhouse_Verification_and_Validation_Updated.docx).
