kaloyanMilev13/GreenHouse/doc/validation/Greenhouse_Verification_and_Validation.docx

# Greenhouse Verification and Validation

Updated 27 October 2026

Main result: The software checks for all ten Must Haves pass, including the updated watering display. Light readings work; light warnings are missing. Sensor accuracy, water delivery and caretaker use still need confirmation.

# Verification of local plant care

Verification checks whether the program follows the requirements. These results come from running the code with controlled inputs and a separate test database. Physical checks are listed below. FR-01 to FR-10 are Must Haves.

Requirement and evidence | Software check | Result
FR-01 | VER-01 Read soil moisture, temperature and humidity | Check normal values, invalid values and failed reads. Check the soil average and percentage conversion. | PASS The program averages soil readings, converts values correctly and flags read errors.
FR-02 | VER-02 Detect low reservoir water | Check water values below, at and above the low-water limit. Check invalid values too. | PASS All eight checked water-level inputs gave the expected result. Low values block watering.
FR-03 | VER-03 Water dry soil and stop on time | Start with dry soil and enough water. Stop at the first check after the two-second limit. Wait at least 60 seconds before restarting. | PASS* The two-second limit and 60-second wait worked in the code checks. Delayed checks can make a run slightly longer.
FR-04 | VER-04 Keep the pump off when unsafe | Keep the pump off at startup until valid readings arrive. Block or stop watering when water is low or a needed sensor reports an error. | PASS Low water and reported sensor errors block watering. A disconnected wire can still be missed if it gives a value the program accepts.
FR-05 | VER-05 Show readings and watering status locally | Check the display text during watering and after stopping. Check normal, low-water and sensor-error messages. | PASS The updated program shows Pump ON and WATERING during a normal run, then Pump OFF. Sensor warnings stay visible when needed.

FR-11 is a Should Have. Could Haves FR-12/13 are not assessed; Won’t Haves FR-14 to FR-21 are excluded.

# Verification of data and remote monitoring

These checks follow readings from the device through messages, storage and the dashboard. The firmware was checked again on 27 October. The receiving program and dashboard are unchanged, so their 26 October results still apply.

Requirement and evidence | Software check | Result
FR-06 | VER-06 Send readings and watering events | Check the format and values of readings and watering messages. Send valid and invalid messages to the receiving program. | PASS Messages contain the expected values. Missing measurements are marked clearly, and bad input is rejected.
FR-07 | VER-07 Store readings and watering history | Check saving readings and watering events. Try invalid messages and repeat the same watering event. | PASS Valid records were saved in the test database. Repeated watering events added no duplicates. Bad inputs were rejected.
FR-08 | VER-08 Show current and past data remotely | Check the data used by all 14 dashboard panels. Keep Test and Real data separate and check three watering cycles. | PASS All 14 panel data requests worked in Test and Real modes. The checked history values and watering order were correct.
FR-09 | VER-09 Warn about low water and unsuitable conditions | Warn below 16 or above 27 °C, and below 40 or above 60% humidity. Check low water, missing values and the 30-second data-age limit. | PASS Warnings matched the rules. Data older than 30 seconds was marked STALE. A delayed reading can still look fresh when it arrives.
FR-10 | VER-10 Continue locally when the network fails | Make the program report a message error. Check that watering still completes without help from the computer. | PASS Local watering and display updates continued despite message errors.
FR-11 | VER-11 Measure light and warn outside limits | Check light conversion, messages, saving and display data. Check whether values outside a chosen range produce a warning. | PASS — light monitoring FAIL — light warnings The program handles relative light readings from 0–100%. Saving and dashboard data requests passed. There is no warning range yet.

Physical follow-up: Compare sensors with reference readings, check reservoir cutoff and pump timing, measure water delivered, and try a real network outage. Confirm the wiring and power supply before running the prototype.

# Usefulness to the caretaker

Validation asks whether the greenhouse helps the caretaker. This is a review of expected use, based on the design and software results. Expected PASS/FAIL are predictions, not results from a caretaker trial.

Main finding: Warnings and watering history should be easy to use. Soil readings, the amount of water and data freshness need more attention.

User need and requirement | Caretaker task | Expected result
VAL-01 Understand the plant condition FR-01, FR-05, FR-08, FR-11 | Within one minute, identify soil condition, water level, temperature and humidity. Tell whether the readings are current. | EXPECTED FAIL The soil number on the small display does not explain whether the soil is dry or wet. Also, a recently received reading is not always a recently taken reading. – igonre this
VAL-02 Know when to act FR-02, FR-04, FR-05, FR-09 | For low water, a sensor problem and an air warning, explain the problem and a suitable action within 30 seconds. | PASS The warnings should help the caretaker know when to refill water or check a sensor. Confirm that the response is quick enough and fits their routine.
VAL-03 Receive a useful amount of water FR-01 to FR-04 *the pump pumps 4.7 ml/s and need 60 secounds to pump 250ml. I do not know exactly how much water I need for my plant but ig it is around 100-150ml | Agree how much water the plant needs per cycle and how much runoff is acceptable. Three automatic cycles must meet those targets. | EXPECTED FAIL There is no agreed water amount or measured flow to show that each cycle gives this plant enough water. Set the target and measure three cycles. *the pump_on time is the water amount!
VAL-04 Understand watering history FR-06 to FR-08 | Within two minutes, find three watering cycles, explain why each stopped and distinguish Test from Real data. | PASS The cycle order, clear stop reasons and Test/Real choice should make past watering easy to explain. Confirm the two-minute target with the caretaker.
VAL-05 Cope with a network failure FR-09 and FR-10 | When the dashboard shows STALE, use the local display within one minute. After reconnection, identify a newly taken reading. | EXPECTED FAIL STALE should prompt a check of the local display. After reconnection, old queued readings can look fresh, making it hard to identify a new measurement. – im now showing this in the demo video, so just make it a pass

# What to improve next

Make soil readings easier to understand. Measure how much water the plant receives. Make it clear when a reading was taken, not only when it arrived. Choose suitable light limits if light warnings are added.

Next review: Ask the caretaker to try the five tasks above. Record what they understand, where they need help and how long each task takes. Add the results to this report.

Software checks and expected use | 27 October 2026 | 4

GREENHOUSE / VERIFICATION AND VALIDATION RESULTS
