kaloyanMilev13/GreenHouse/doc/design/System_Architecture/previews/03_Sensors_and_Display/02-sensor-validation.png

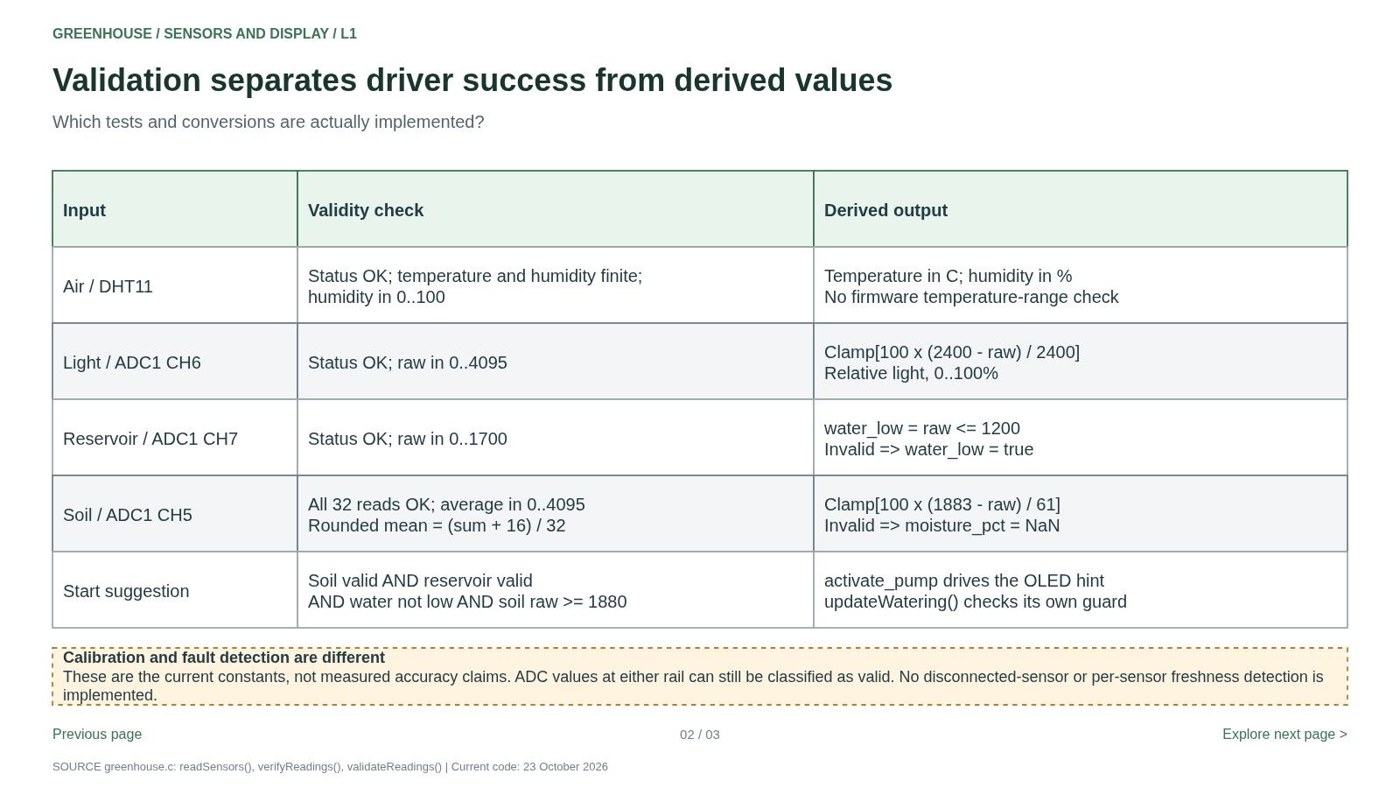
doc/design/System_Architecture/previews/03_Sensors_and_Display/02-sensor-validation.png
