kaloyanMilev13/GreenHouse/doc/design/System_Architecture/previews/06_Data_and_Database/04-backend-validation.png

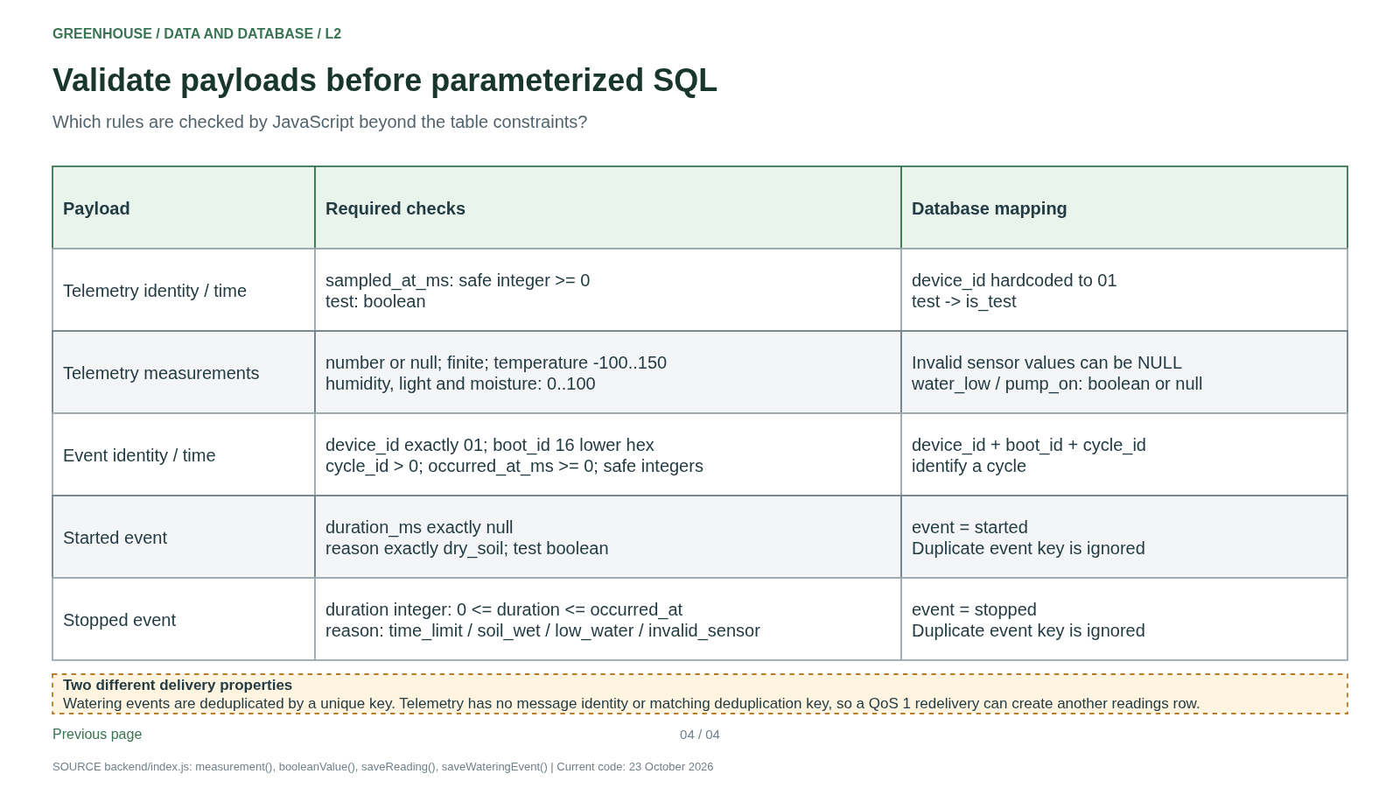
doc/design/System_Architecture/previews/06_Data_and_Database/04-backend-validation.png
