kaloyanMilev13/GreenHouse/doc/design/scheme.pdf

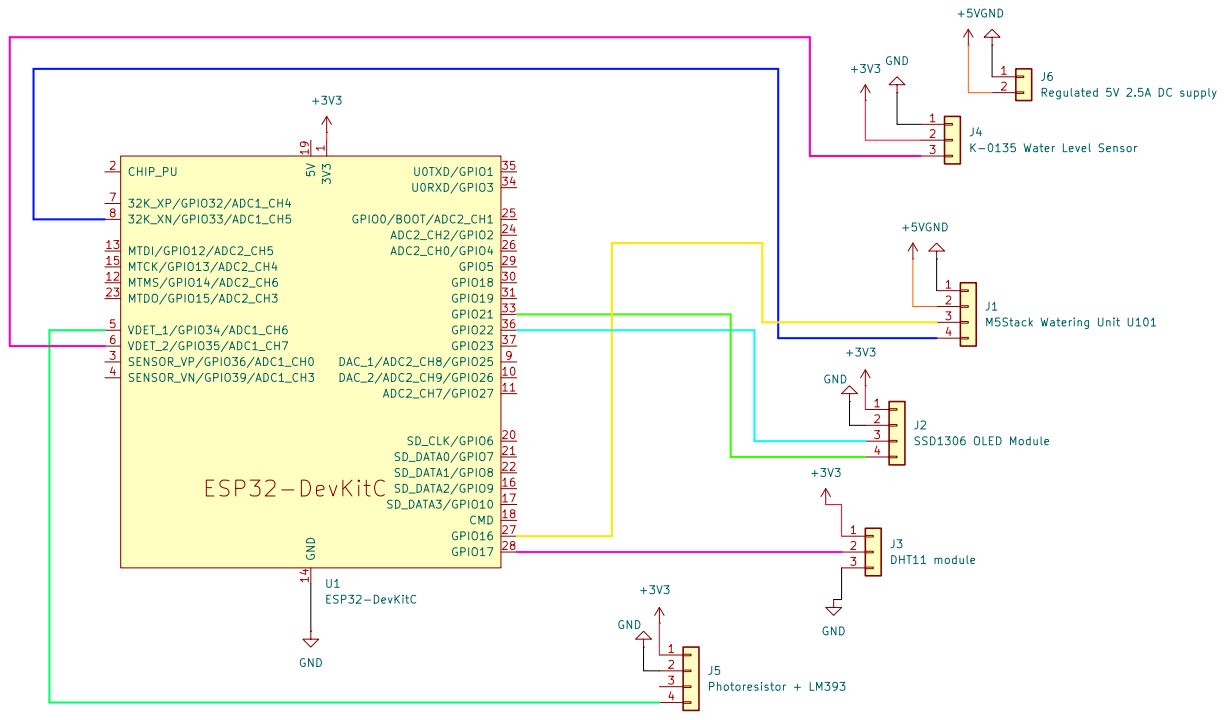
[picture p86: page 1]
