kaloyanMilev13/GreenHouse/doc/design/Greenhouse_Hardware/Greenhouse_Hardware.kicad_pcb

## KiCad design project/dmp280/dmp280/dmp280.kicad_sch

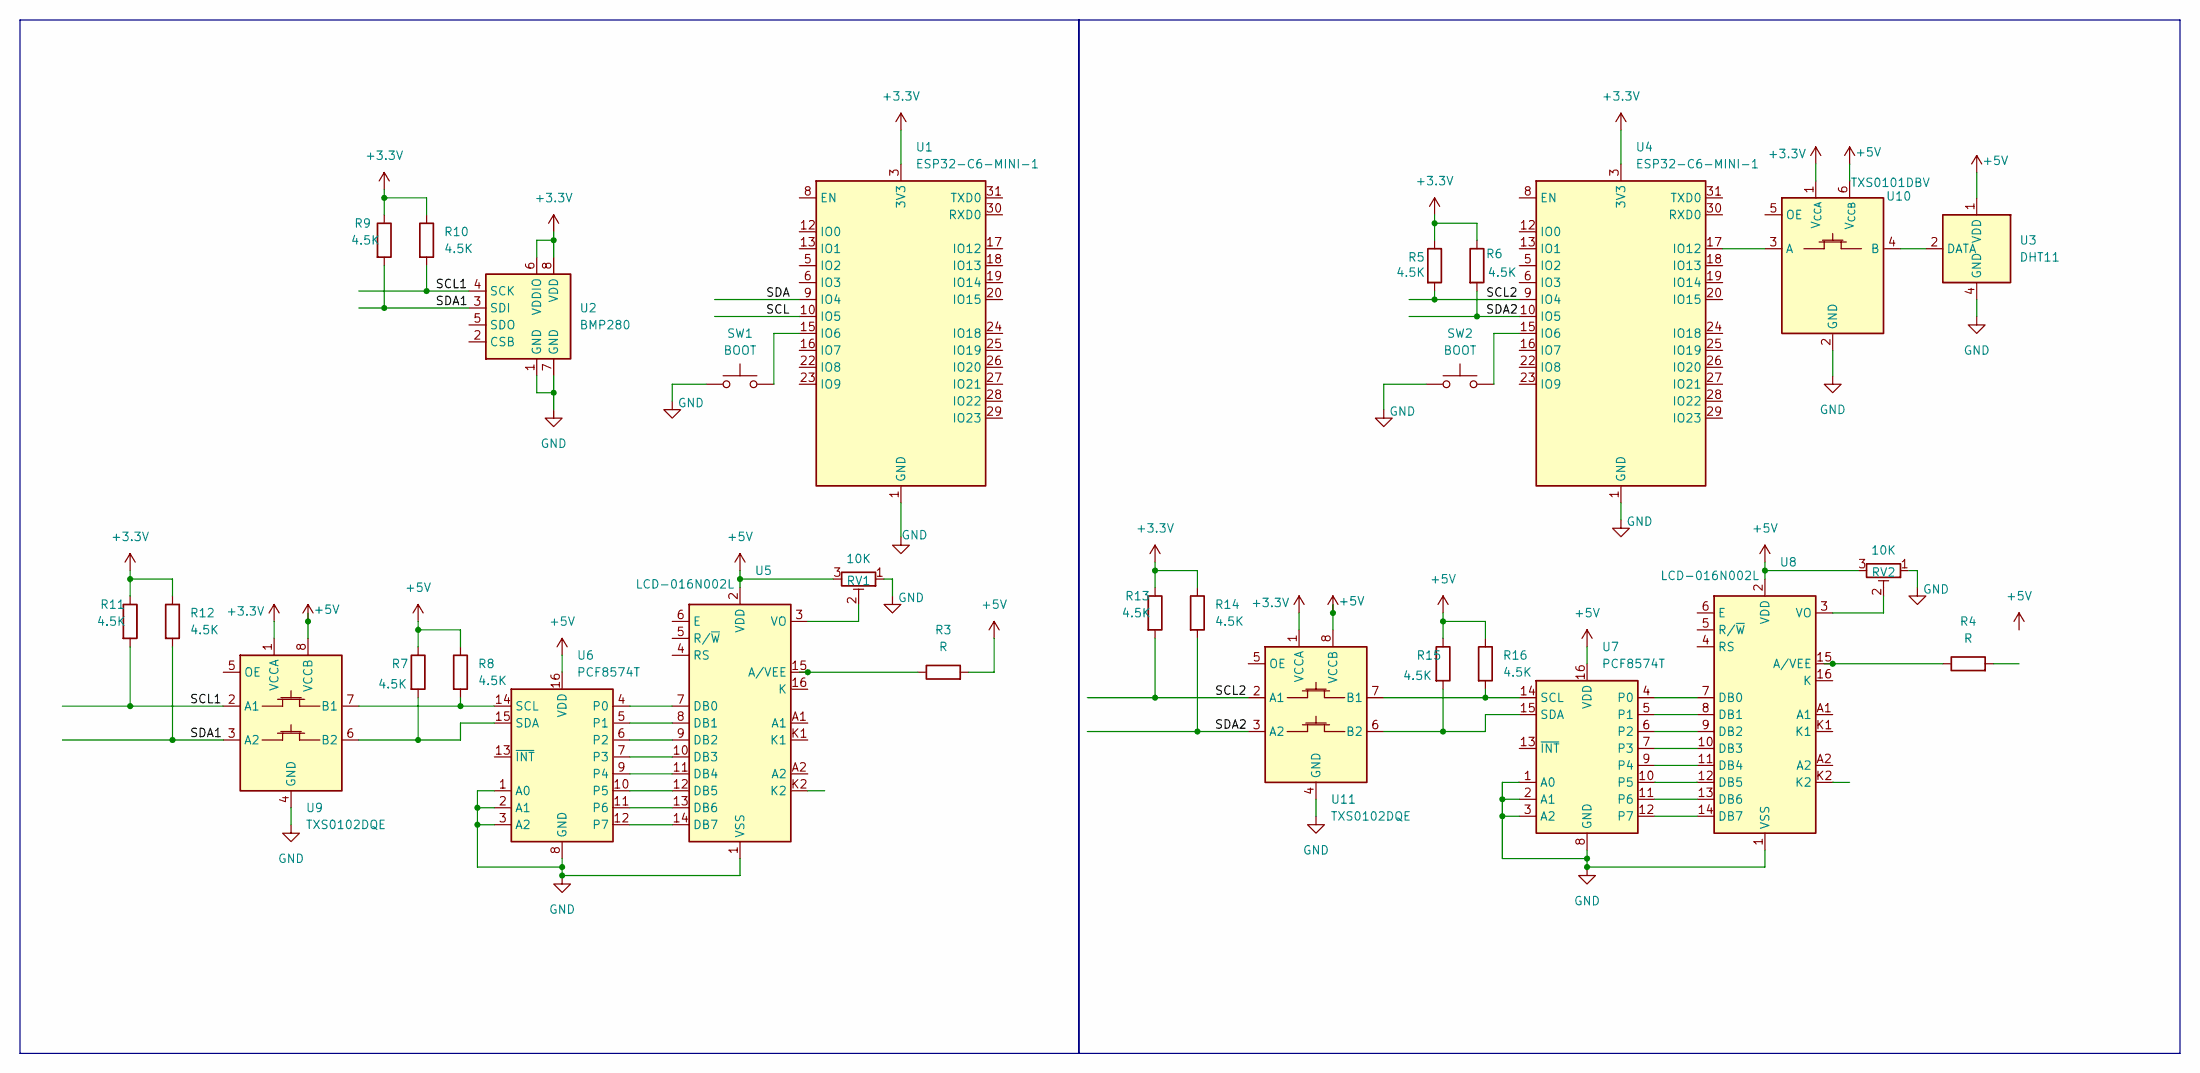
[picture p87: schematic dmp280.kicad_sch]

Parts:
R3, R4: R
R5, R6, R7, R8, R9, R10, R11, R12, R13, R14, R15, R16: 4.5K
RV1, RV2: 10K
SW1, SW2: BOOT
U1, U4: ESP32-C6-MINI-1
U2: BMP280; Bosch_LGA-8_2x2.5mm_P0.65mm_ClockwisePinNumbering
U3: DHT11; Aosong_DHT11_5.5x12.0_P2.54mm
U5, U8: LCD-016N002L
U6, U7: PCF8574T; SOIC-16W_7.5x10.3mm_P1.27mm
U9, U11: TXS0102DQE; X2SON-8_1.4x1mm_P0.35mm
U10: TXS0101DBV; SOT-23-6

Connections:
+3.3V: R5.1, R6.1, R9.1, R10.1, R11.1, R12.1, R13.1, R14.1, U1.3 (3V3), U2.6 (VDDIO), U2.8 (VDD), U4.3 (3V3), U9.1 (VCCA), U10.1 (V_{CCA}), U11.1 (VCCA)
+5V: R3.2, R7.1, R8.1, R15.1, R16.1, RV1.3, RV2.3, U3.1 (VDD), U5.2 (VDD), U6.16 (VDD), U7.16 (VDD), U8.2 (VDD), U9.8 (VCCB), U10.6 (V_{CCB}), U11.8 (VCCB)
GND: RV1.1, RV2.1, SW1.1, SW2.1, U1.1 (GND), U1.2 (GND), U1.11 (GND), U1.14 (GND), U1.36 (GND), U1.37 (GND), U1.38 (GND), U1.39 (GND), U1.40 (GND), U1.41 (GND), U1.42 (GND), U1.43 (GND), U1.44 (GND), U1.45 (GND), U1.46 (GND), U1.47 (GND), U1.48 (GND), U1.49 (GND), U1.50 (GND), U1.51 (GND), U1.52 (GND), U1.53 (GND), U2.1 (GND), U2.7 (GND), U3.4 (GND), U4.1 (GND), U4.2 (GND), U4.11 (GND), U4.14 (GND), U4.36 (GND), U4.37 (GND), U4.38 (GND), U4.39 (GND), U4.40 (GND), U4.41 (GND), U4.42 (GND), U4.43 (GND), U4.44 (GND), U4.45 (GND), U4.46 (GND), U4.47 (GND), U4.48 (GND), U4.49 (GND), U4.50 (GND), U4.51 (GND), U4.52 (GND), U4.53 (GND), U5.1 (VSS), U6.1 (A0), U6.2 (A1), U6.3 (A2), U6.8 (GND), U7.1 (A0), U7.2 (A1), U7.3 (A2), U7.8 (GND), U8.1 (VSS), U9.4 (GND), U10.2 (GND), U11.4 (GND)
unnamed: R3.1, U5.15 (A/VEE)
unnamed: R4.1, U8.15 (A/VEE)
unnamed: R7.2, U6.15 (SDA), U9.6 (B2)
unnamed: R8.2, U6.14 (SCL), U9.7 (B1)
unnamed: R15.2, U7.15 (SDA), U11.6 (B2)
unnamed: R16.2, U7.14 (SCL), U11.7 (B1)
unnamed: RV1.2, U5.3 (VO)
unnamed: RV2.2, U8.3 (VO)
unnamed: SW1.2, U1.15 (IO6)
unnamed: SW2.2, U4.15 (IO6)
unnamed: U5.7 (DB0), U6.4 (P0)
unnamed: U5.8 (DB1), U6.5 (P1)
unnamed: U5.9 (DB2), U6.6 (P2)
unnamed: U5.10 (DB3), U6.7 (P3)
unnamed: U5.11 (DB4), U6.9 (P4)
unnamed: U5.12 (DB5), U6.10 (P5)
unnamed: U5.13 (DB6), U6.11 (P6)
unnamed: U5.14 (DB7), U6.12 (P7)
unnamed: U7.4 (P0), U8.7 (DB0)
unnamed: U7.5 (P1), U8.8 (DB1)
unnamed: U7.6 (P2), U8.9 (DB2)
unnamed: U7.7 (P3), U8.10 (DB3)
unnamed: U7.9 (P4), U8.11 (DB4)
unnamed: U7.10 (P5), U8.12 (DB5)
unnamed: U7.11 (P6), U8.13 (DB6)
unnamed: U7.12 (P7), U8.14 (DB7)
unnamed: U4.17 (IO12), U10.3 (A)
unnamed: U3.2 (DATA), U10.4 (B)
SCL: U1.10 (IO5)
SCL1: R10.2, R11.2, U2.4 (SCK), U9.2 (A1)
SCL2: R5.2, R13.2, U4.9 (IO4), U11.2 (A1)
SDA: U1.9 (IO4)
SDA1: R9.2, R12.2, U2.3 (SDI), U9.3 (A2)
SDA2: R6.2, R14.2, U4.10 (IO5), U11.3 (A2)
