kaloyanMilev13/GreenHouse/(commit log)

2026-09-30 Initial upload
    [Greenhouse_Hardware.kicad_pcb, Greenhouse_Hardware.kicad_sch, parts.ods]
2026-10-01 Added a temp/humid functionality and light detection, have to fix the oposite resistance of the photoresistor and display the actual lux
    [Greenhouse_Hardware.kicad_sch, parts.ods]
2026-10-05 Made it possible to track light level, water level and moisture
2026-10-07 Added basic WiFi functionallity, sensor reading, oled displaying and validation checking
2026-10-07 WiFi functionallity and sensor reading, validation, data display
    [Greenhouse_Hardware.kicad_sch]
2026-10-08 Finished the WiFi part and started an MQTT implementation. Verified that OLED and sensor readings work
2026-10-12 done backend with postgres connection, onyl garafana is left and the esp32 system
2026-10-12 Calibrated water level sensor and light sensor
2026-10-13 Added water controller and finished data sending/receiving. i only need to calibrate moisture sensor and code the alerts
